mahilfernando/Tracker-Layout_Tororo-PV/solar-mezzanine-roof/report/keyplan.png

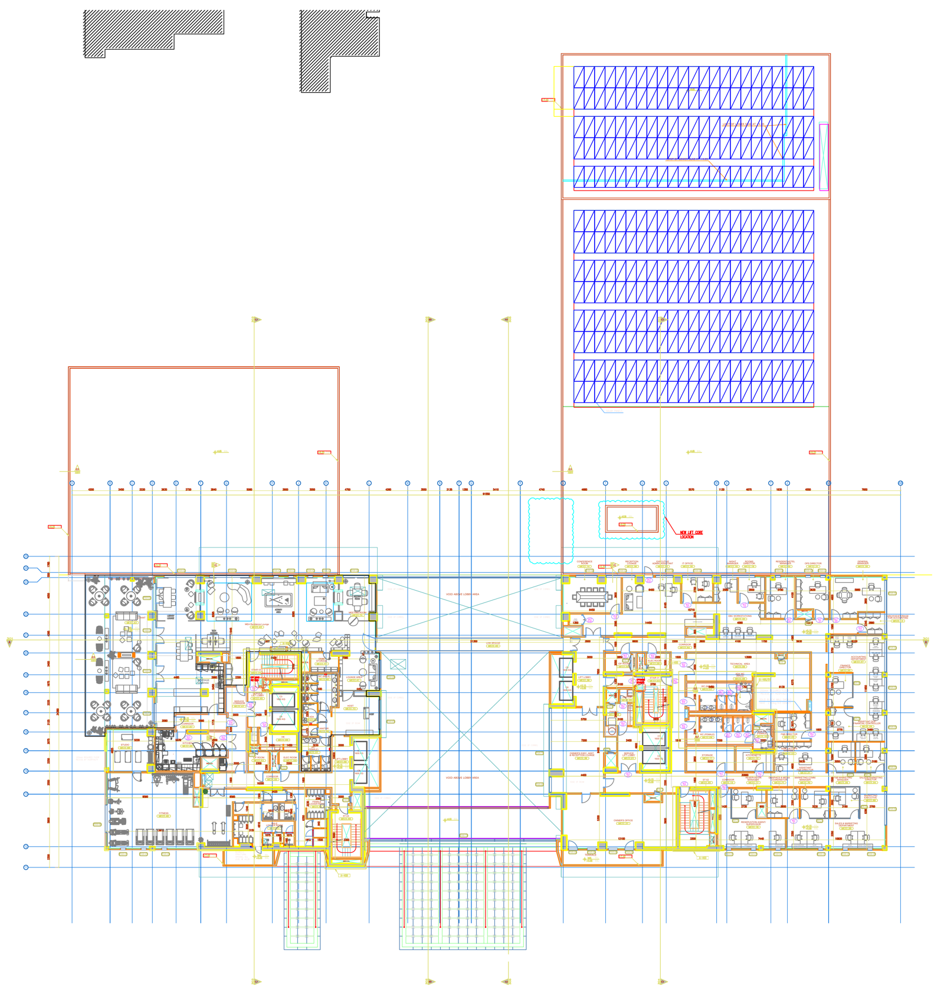
solar-mezzanine-roof/report/keyplan.png
