mahilfernando/Tracker-Layout_Tororo-PV/solar-mezzanine-roof/report/hotel.jpg

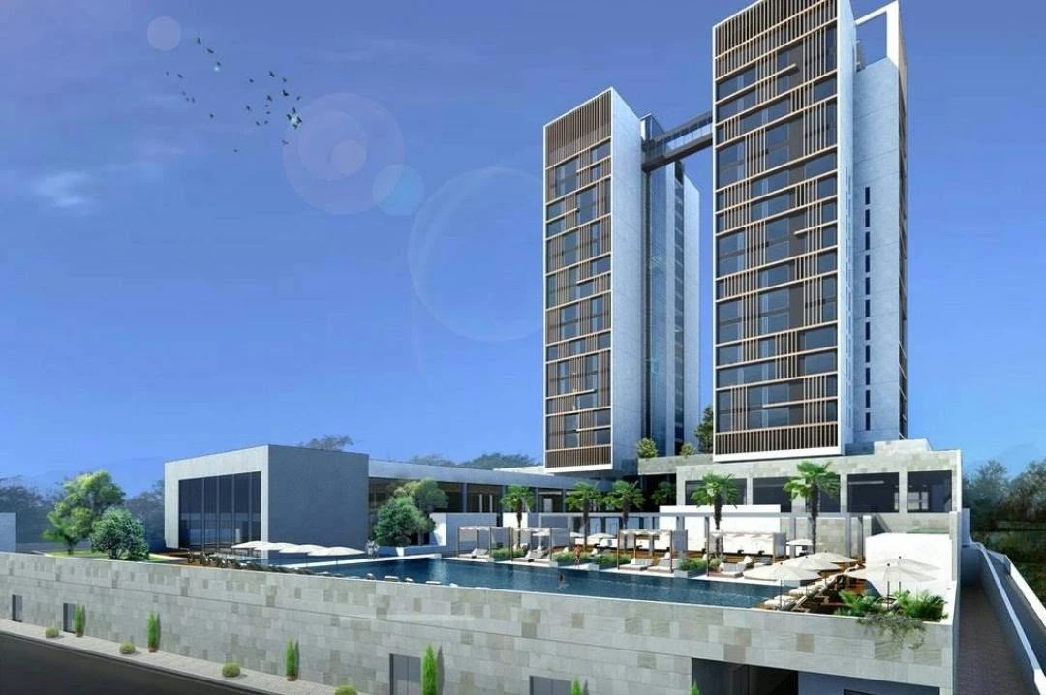
solar-mezzanine-roof/report/hotel.jpg
