mahilfernando/Tracker-Layout_Tororo-PV/solar-mezzanine-roof/README.md

# Rooftop PV layout – D18102-DD-A-104 (Mezzanine)

`PV_Layout_10deg_Mezzanine_Roof.dxf` – PV layout at real scale in mm, ready to paste into the DWG.
`make_pv_layout.py` – regenerates the DXF (change tilt, module or spacing at the top).
`preview_overlay.png` – the layout drawn over the architect's PDF to check the fit.

## Design basis
| Item | Value |
|---|---|
| Module | 2382 × 1134 × 30 mm, 620 Wp bifacial TOPCon, portrait, 2 high (2P) |
| Tilt | 10° → 2P table depth on plan 4,711 mm; 1P table 2,346 mm |
| Clamp gap | 20 mm |
| Aisle between tables | 800 mm (no row-to-row shading 09:00–15:00 all year at Tororo) |
| Edge setback | 1,000 mm (east side 1,742 mm to keep clear of the roof opening ⊠) |
| Modules per row | 23 (row length 26,522 mm) |

## Result
| Zone | Tables | Modules | kWp |
|---|---|---|---|
| Upper block (+6.80, incl. hatched +4.85 strip) | 2 × 2P + 1 × 1P | 115 | 71.3 |
| Lower block (architect's PV zone) | 4 × 2P | 184 | 114.1 |
| **Total** | | **299** | **185.4** |

## Layers
`PV-MODULE`, `PV-TABLE`, `PV-SETBACK`,
`PV-OBSTRUCTION`, `PV-ROOF-REF`, `PV-DIM`, `PV-TEXT`. Modules are block `PV_MOD_620W`.

## Inserting into the DWG
The roof outline was traced from the PDF plot (accurate to about ±50 mm) and calibrated on the
29,390 and 15,805 dimensions. The DXF origin (0,0) is the **inner face of the top-left (NW) corner
of the upper PV roof**.
1. Open the DXF, select everything, then run `COPYBASE` with base point 0,0.
2. In the DWG, `PASTECLIP` and pick the same inner corner.
3. If the model space is rotated relative to the plot, `ROTATE` about that corner.
4. Check that the `PV-ROOF-REF` outline sits on the walls, then freeze or delete that layer.

## Enerack structure version (current)
`PV_Layout_Enerack_10deg.dxf` / `.pdf` – same 299-module layout drawn with the Enerack ballast
structure (EPJ-26110401): rails, 11 frames per table, feet and sections. Built by
`make_pv_layout_enerack.py` and `build_layout_sheet.py`. All tables are within the architect's solar zone.
