mahilfernando/Tracker-Layout_Tororo-PV/solar-mezzanine-roof/report/PVsyst_Report_Kampala_Marriott_Hotel_185kWp_VC0.pdf

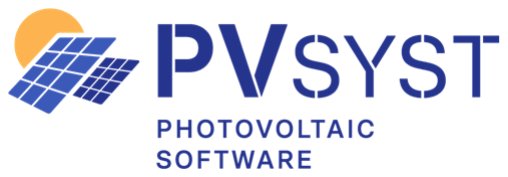
[picture p14: figure]

# PVsyst TRIAL

# PVsyst TRIAL

# PVsyst TRIAL

# PVsyst TRIAL

# PVsyst TRIAL

## PVsyst V8.1.8

# PVsyst - Simulation report

# Grid-Connected System

Project: | Nsambya_160_kW
Variant: | Nsambya_160_kW

## No 3D scene defined, no shadings System power: 185 kWp Nsambya - Uganda

Author

# Kampala_Marriott_Hotel

# Kampala_Marriott_Hotel

# PVsyst TRIAL

# PVsyst TRIAL

# PVsyst TRIAL

# PVsyst TRIAL

# PVsyst TRIAL ⁰⁹/11/26

PVsyst V8.1.8
VC0, Simulation date:
09/11/26 18:38
with V8.1.8

## Project: Nsambya_160_kW

### Variant: Nsambya_160_kW

PVsyst Evaluation mode

### Project summary

Geographical Site
Nsambya
Uganda

Situation
Latitude
Longitude
Altitude
Time zone

0.3042
32.5874
1178
UTC+3

°(N)
°(E)
m

Project settings
Albedo | 0.20

Weather data
Nsambya
Meteonorm 9.0 dll, Sat=100% - Synthetic

### System summary

Grid-Connected System | No 3D scene defined, no shadings

Orientation #1
Fixed plane
Tilt/Azimuth | 10 / 0 °

Near Shadings
no Shadings

User's needs
Unlimited load (grid)

System information
PV Array
Nb. of modules
Pnom total

299
185

units
kWp

Inverters
Nb. of units
Total power
Pnom ratio

2
160
1.16

units
kWac

### Results summary

Simulation step | Hourly
Produced Energy | 291051 kWh/year | Specific production | 1570 kWh/kWp/year Perf. Ratio PR | 85.44 %

### Table of contents

Project and results summary
General parameters, PV Array Characteristics, System losses Main results
Loss diagram
Predef. graphs
Single-line diagram

2
3
4
5
6
7

# Kampala_Marriott_Hotel

## Kampala_Marriott_Hotel

# PVsyst TRIAL

# PVsyst TRIAL

# PVsyst TRIAL

PVsyst V8.1.8
VC0, Simulation date:
09/11/26 18:38
with V8.1.8

### General parameters

Grid-Connected System | No 3D scene defined, no shadings

Simulation step
Hourly

Orientation #1
Fixed plane
Tilt/Azimuth | 10 / 0 °

Models used
Transposition
Diffuse
Circumsolar

Perez
Perez, Meteonorm
separate

Horizon
Free Horizon

Near Shadings
no Shadings

User's needs
Unlimited load (grid)

### PV Array Characteristics

PV module
Manufacturer
Model

Generic
CHSM66RN(DG)/F-BH-620
(Original PVsyst database)
Unit Nom. Power | 620 Wp
Number of PV modules Nominal (STC) Modules | 299
| 185
| 23 units x 13 units
| kWp
| In series
At operating cond. (50°C)
Pmpp U mpp I mpp | 172
| 491
| 351 kWp
| V
| A

Inverter
Manufacturer
Model

Generic
80M1-HYA
(Original PVsyst database)
Unit Nom. Power | 80.0 kWac
Number of inverters Total power | 2
| 160 units
| kWac
Operating voltage Max. power (=>40°C) Pnom ratio (DC:AC) Power sharing within this inverter | 160-1000
| 88.0
| 1.16 V
| kWac

Total PV power
Nominal (STC)
Total
Module area
Cell area

185
299
808
754

kWp
modules
m²
m²

Total inverter power
Total power
Max. power
Number of inverters
Pnom ratio

160
176
2
1.16

kWac
kWac
units

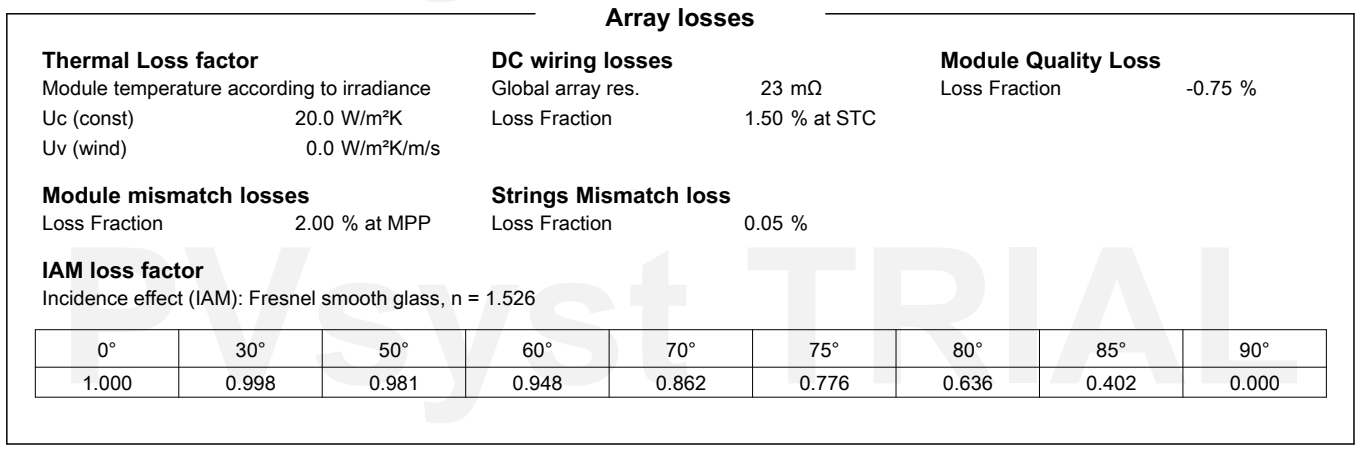
[picture p15: figure]
PVsyst TRIAL; Array losses; Thermal Loss factor; Module temperature according to irradiance; Uc (const); Uv (wind); W/m²K; W/m²K/m/s; DC wiring losses; Global array res.; Loss Fraction; % at STC; Module Quality Loss; Module mismatch losses; 2.00 % at MPP; Strings Mismatch loss; IAM loss factor

Incidence effect (IAM): Fresnel smooth glass, n = 1.526

# PVsyst TRIAL

# PVsyst TRIAL

# PVsyst TRIAL

PVsyst V8.1.8
VC0, Simulation date:
09/11/26 18:38
with V8.1.8

### Main results

Simulation step
Hourly

System Production
Produced Energy | 291051 kWh/year | Specific production
| | Perf. Ratio PR

1570
85.44

kWh/kWp/year
%
Normalized productions (per installed kWp) | Performance Ratio PR

Balances and main results

| GlobHor kWh/m² | DiffHor kWh/m² | T_Amb °C | GlobInc kWh/m² | GlobEff kWh/m² | EArray kWh | E_Grid kWh | PR ratio
PVsyst TRIAL January February March April May June July August September October November December | 163.9 155.8 170.3 146.6 152.4 147.4 158.5 160.2 159.5 155.5 138.1 146.8 | 65.15 60.45 76.10 72.32 71.94 61.35 56.87 63.78 65.84 68.89 73.98 67.95 | 23.02 23.52 23.21 22.79 22.59 22.19 21.80 21.90 22.11 22.31 22.30 22.42 | 174.4 161.5 170.2 141.3 142.3 135.0 145.4 152.1 157.0 158.1 144.3 156.1 | 169.0 157.0 164.9 136.1 136.5 129.0 139.4 146.5 152.1 153.4 139.6 151.3 | 28018 25848 27424 22846 23031 21771 23454 24591 25340 25458 23357 25187 | 27523 25387 26942 22443 22628 21387 23038 24154 24885 24993 22933 24738 | 0.851 0.848 0.854 0.857 0.858 0.855 0.855 0.857 0.855 0.853 0.857 0.855
Year | 1855.0 | 804.62 | 22.51 | 1837.7 | 1774.7 | 296323 | 291051 | 0.854

Legends
GlobHor
DiffHor
T_Amb
GlobInc
GlobEff

Global horizontal irradiation Horizontal diffuse irradiation
Ambient Temperature
Global incident in coll. plane
Effective Global, corr. for IAM and shadings

EArray
E_Grid
PR

Effective energy at the output of the array Energy injected into grid
Performance Ratio

# PVsyst TRIAL

### Loss diagram

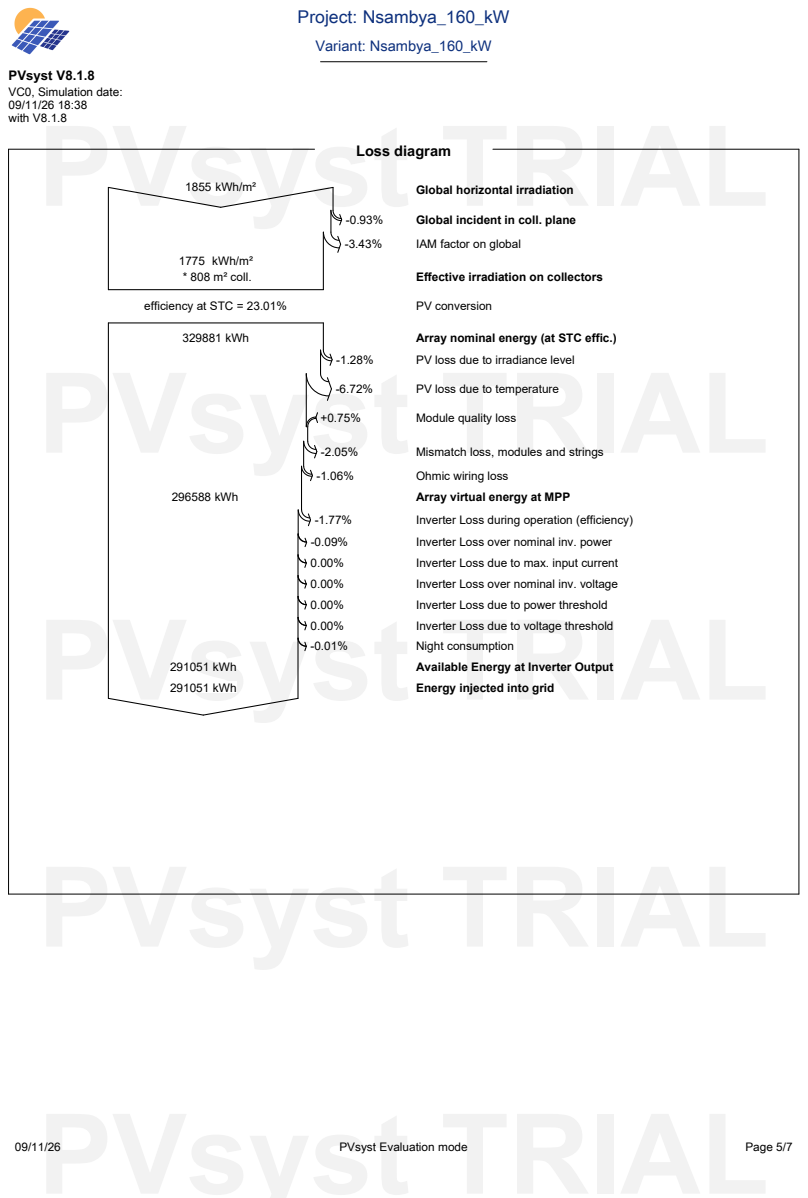
[picture p16: page 5]
PVsyst TRIAL; PVsyst V8.1.8; VC0, Simulation date: 09/11/26 18:38 with V8.1.8; 1855 kWh/m²; Global horizontal irradiation; Global incident in coll. plane; IAM factor on global; 1775 kWh/m²; * 808 m² coll.; efficiency at STC = 23.01%; PV conversion; 329881 kWh; Array nominal energy (at STC effic.); PV loss due to irradiance level; PV loss due to temperature; Module quality loss; Mismatch loss, modules and strings; Ohmic wiring loss; 296588 kWh; Array virtual energy at MPP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

Effective irradiation on collectors

# PVsyst TRIAL

### Predef. graphs

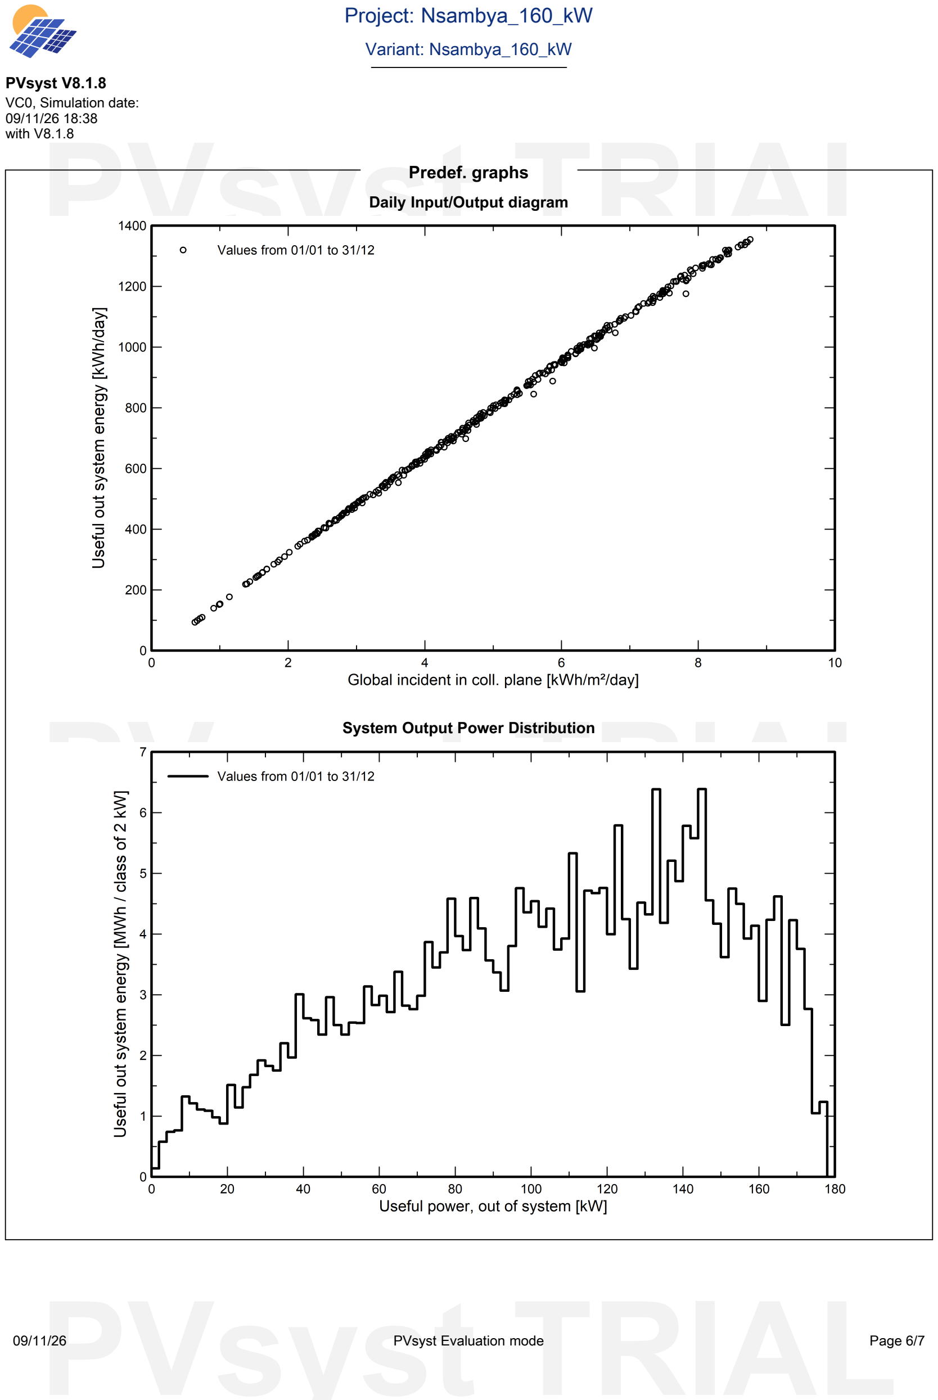
[picture p17: page 6]

# PVsyst TRIAL

# PVsyst TRIAL

# PVsyst TRIAL

PVsyst V8.1.8
VC0, Simulation date:
09/11/26 18:38
with V8.1.8

Daily Input/Output diagram

System Output Power Distribution

# PVsyst TRIAL

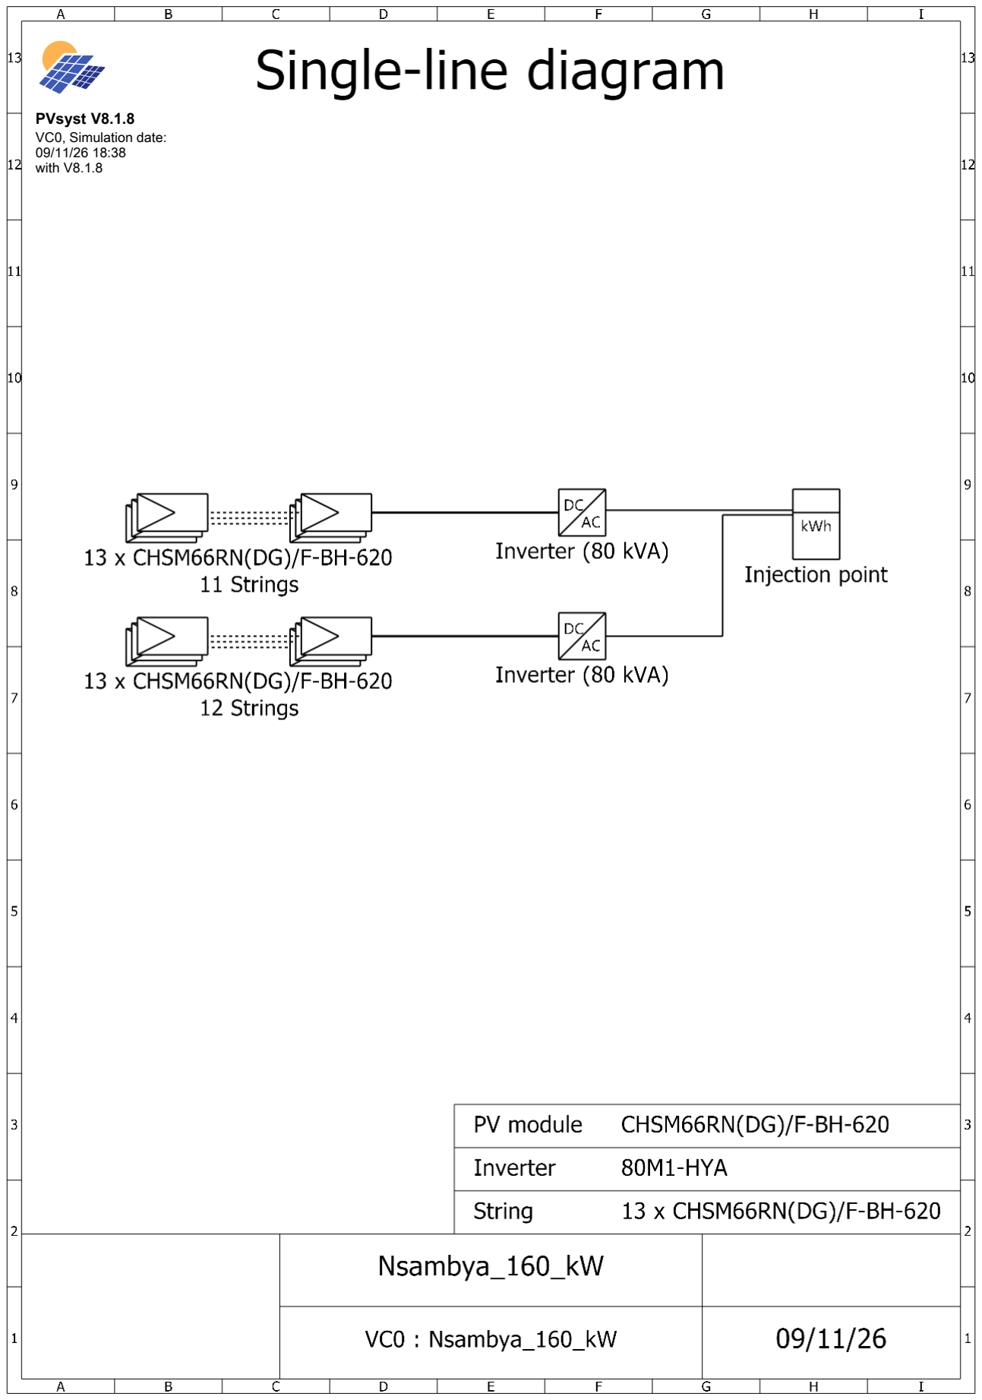
[picture p18: page 7]

# PVsyst TRIAL

# PVsyst TRIAL

# PVsyst TRIAL

# PVsyst TRIAL

PVsyst V8.1.8
VC0, Simulation date:
09/11/26 18:38
with V8.1.8
