mahilfernando/Tracker-Layout_Tororo-PV/solar-mezzanine-roof/sld/PV_SLD_Engineering.docx

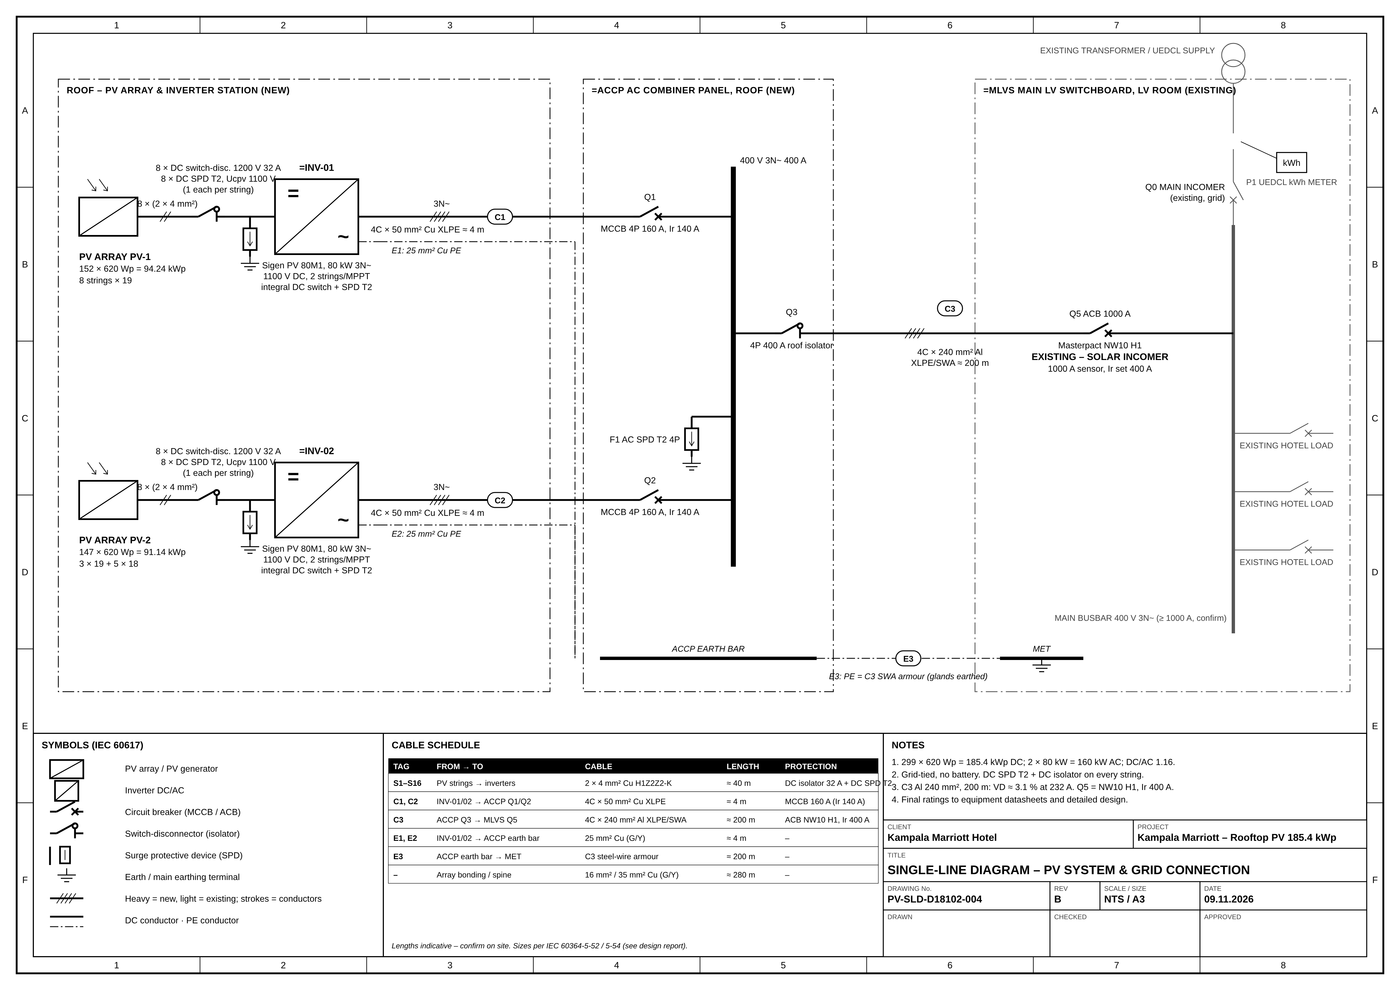
[picture p20: figure]
PV system single-line diagram PV-SLD-D18102-004

Figure – Single-line diagram, 185.4 kWp rooftop PV (drawing PV-SLD-D18102-004 Rev A)
