mahilfernando/Tracker-Layout_Tororo-PV/solar-mezzanine-roof/report/PVsyst_vs_Initial_Generation.xlsx

Sheet: Monthly comparison
PVsyst simulation vs initial generation estimate – Kampala Marriott 185.4 kWp
PVsyst V8.1.8 (trial) · Meteonorm 9.0 · tilt 10°, azimuth 0° · 299 × CHSM66RN(DG)/F-BH-620 · 2 × 80M1 · no shading · simulated 09/11/2026
Month | GHI – initial (kWh/m²) | GHI – PVsyst (kWh/m²) | Plane irradiation – PVsyst (kWh/m²) | Generation – initial estimate (kWh) | Generation – PVsyst E_Grid (kWh) | Difference (kWh) | Difference (%) | PR – PVsyst
Jan | 167.4 | 163.9 | 174.4 | 25143 | 27523 | 2380 | 9.5% | 85.1%
Feb | 156.8 | 155.8 | 161.5 | 23551 | 25387 | 1836 | 7.8% | 84.8%
Mar | 167.4 | 170.3 | 170.2 | 25143 | 26942 | 1799 | 7.2% | 85.4%
Apr | 150.0 | 146.6 | 141.3 | 22529 | 22443 | -86 | -0.4% | 85.7%
May | 145.7 | 152.4 | 142.3 | 21884 | 22628 | 744 | 3.4% | 85.8%
Jun | 138.0 | 147.4 | 135.0 | 20727 | 21387 | 660 | 3.2% | 85.5%
Jul | 139.5 | 158.5 | 145.4 | 20952 | 23038 | 2086 | 10.0% | 85.5%
Aug | 148.8 | 160.2 | 152.1 | 22349 | 24154 | 1805 | 8.1% | 85.7%
Sep | 153.0 | 159.5 | 157.0 | 22980 | 24885 | 1905 | 8.3% | 85.5%
Oct | 155.0 | 155.5 | 158.1 | 23280 | 24993 | 1713 | 7.4% | 85.3%
Nov | 147.0 | 138.1 | 144.3 | 22079 | 22933 | 854 | 3.9% | 85.7%
Dec | 158.1 | 146.8 | 156.1 | 23746 | 24738 | 992 | 4.2% | 85.5%
Year | 1826.7 | 1855.0 | 1837.7 | 274363 | 291051 | 16688 | 6.1% | 85.4%
Indicator |  |  |  | Initial estimate | PVsyst | Difference
Specific yield (kWh/kWp/yr) |  |  |  | 1480.003237 | 1570.023735 | 90.02049844
Average per month (kWh) |  |  |  | 22863.58333 | 24254.25 | 1390.666667
Average per day (kWh) |  |  |  | 751.6794521 | 797.4 | 45.72054795
Performance ratio (yield ÷ plane irradiation) |  |  |  | 80.5% | 85.4% | 4.9%
Best month ÷ worst month |  |  |  | 1.21 | 1.29 | 0.07

Sheet: Assumptions & losses
Why the two estimates differ
Item | Initial estimate (Excel) | PVsyst VC0 | Comment
Weather data | Typical Kampala GHI (desktop), 1,827 kWh/m²/yr | Meteonorm 9.0 synthetic, 1,855 kWh/m²/yr | PVsyst GHI 1.5 % higher
Method | kWp × specific yield 1,480 kWh/kWp | Hourly simulation (Perez transposition)
Performance ratio | ≈ 0.80 (assumed, all losses) | 0.854 (simulated) | Main reason for the 6 % difference
Shading (row-to-row, parapet, tower) | included in PR 0.80 | Not modelled – 'no 3D scene, no shadings' | Tower and parapet shading will reduce PVsyst output
Soiling (dust) | included in PR 0.80 | Not modelled (0 %) | Typically 2–3 % in Kampala (dry seasons, urban dust)
Thermal model | included in PR 0.80 | Uc = 20 W/m²K → −6.7 % temperature loss | Conservative for an open ballast structure (Uc 29 typical)
Module quality / LID | included in PR 0.80 | +0.75 % quality gain, no LID | Optimistic – use 0 % quality gain
Bifacial rear gain | not included | not included (front-side only) | Could add ≈ 2–4 % on a light roof
String layout | 16 strings: 8 × 19 + 3 × 19 + 5 × 18 | 23 strings × 13 modules | Update PVsyst to the design stringing (19/18 in series)
AC losses (ACCP → MLVS cable) | included in PR 0.80 | Not modelled (output at inverter) | ≈ 1–2 % with the long C3 run
Availability / downtime | included in PR 0.80 | Not modelled | ≈ 1 % typical
Degradation | 1 % year 1, then 0.4 %/yr | Year-1 nominal (no degradation) | Compare year-1 figures only
Software licence | – | PVsyst TRIAL / evaluation mode | Run with a licensed copy for the issued report
Adjusted PVsyst estimate (adding the losses PVsyst left out)
Step | Factor | Energy (kWh/yr) | Note
PVsyst E_Grid (as simulated) |  | 291051 | page 4 of the report
Soiling | 2.0% | 285229.98 | edit
Near shading (tower / parapet / rows) | 2.0% | 279525.3804 | edit – confirm with a 3D scene
AC cable losses to MLVS | 1.0% | 276730.1266 | edit
Availability | 1.0% | 273962.8253 | edit
Remove module quality gain | 0.8% | 271908.1041 | PVsyst +0.75 %
Adjusted PVsyst year-1 generation |  | 271908.1041
Initial estimate (proposal / workings) |  | 274363
Adjusted PVsyst vs initial |  | -0.9%

Sheet: Financial impact
Year-1 financial effect of the generation basis (tariff USD 0.07/kWh, Total Project Value USD 102,789)
Case | Year-1 generation (kWh) | Year-1 savings (USD) | Simple payback (yrs, approx.) | Specific yield (kWh/kWp) | Tariff (USD/kWh) | 0.07002272727
Initial estimate (used in proposal) | 274363 | 19211.64552 | 5.1 | 1480.003237 | Investment (USD) | 102788.75
PVsyst as simulated | 291051 | 20380.1848 | 4.9 | 1570.023735 | Escalation | 0.02
PVsyst adjusted (soiling, shading, AC, availability) | 271908.1041 | 19039.74702 | 5.2 | 1466.76073
Payback = years for savings rising 2 %/yr to repay the investment (degradation ignored, so ≈ 0.1 yr shorter than the full 25-year model in the workings).
