mahilfernando/Tracker-Layout_Tororo-PV/ChatGPT Image Oct 8, 2026, 09_10_20 AM.jpg

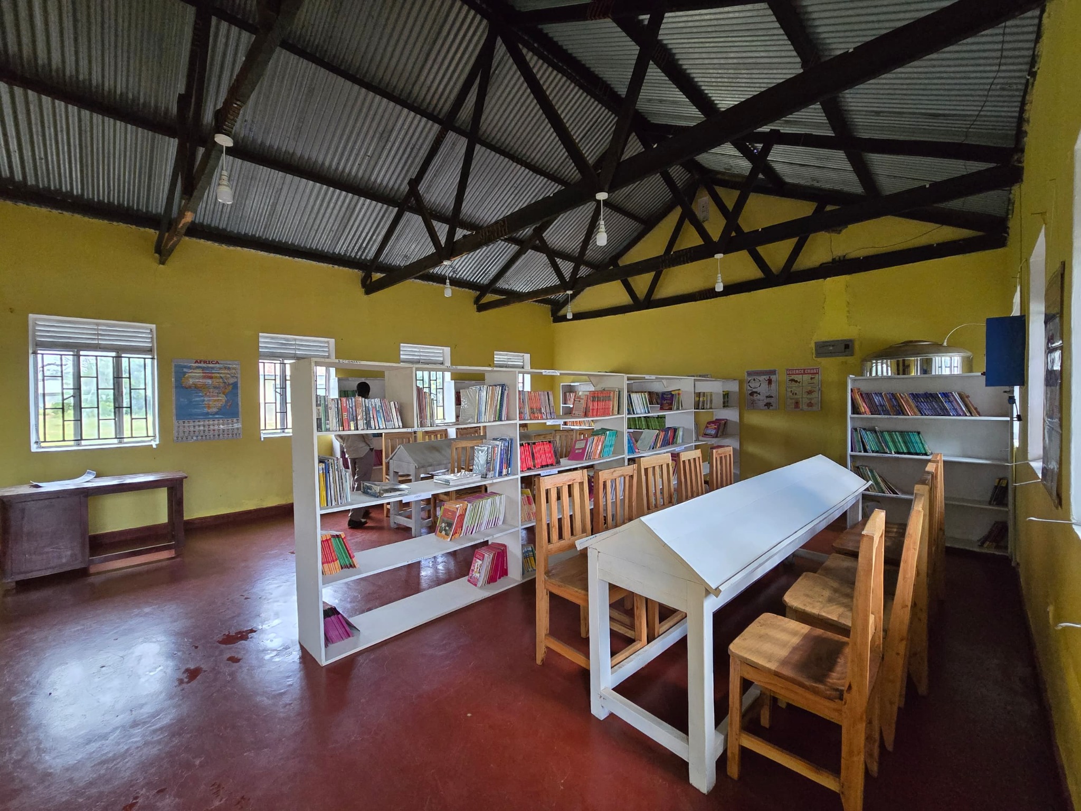
ChatGPT Image Oct 8, 2026, 09_10_20 AM.jpg
