mahilfernando/Tracker-Layout_Tororo-PV/ChatGPT Image Oct 8, 2026, 09_10_26 AM.jpg

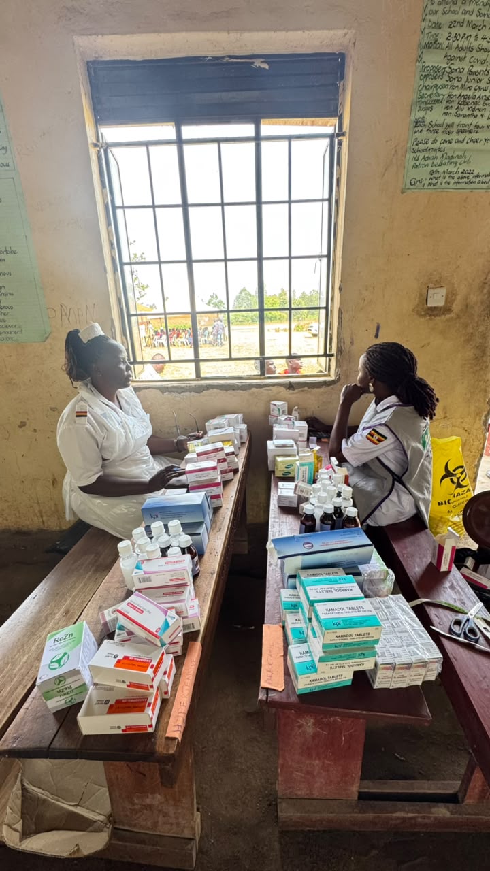
ChatGPT Image Oct 8, 2026, 09_10_26 AM.jpg
