mahilfernando/Tracker-Layout_Tororo-PV/ChatGPT Image Oct 8, 2026, 09_10_37 AM.jpg

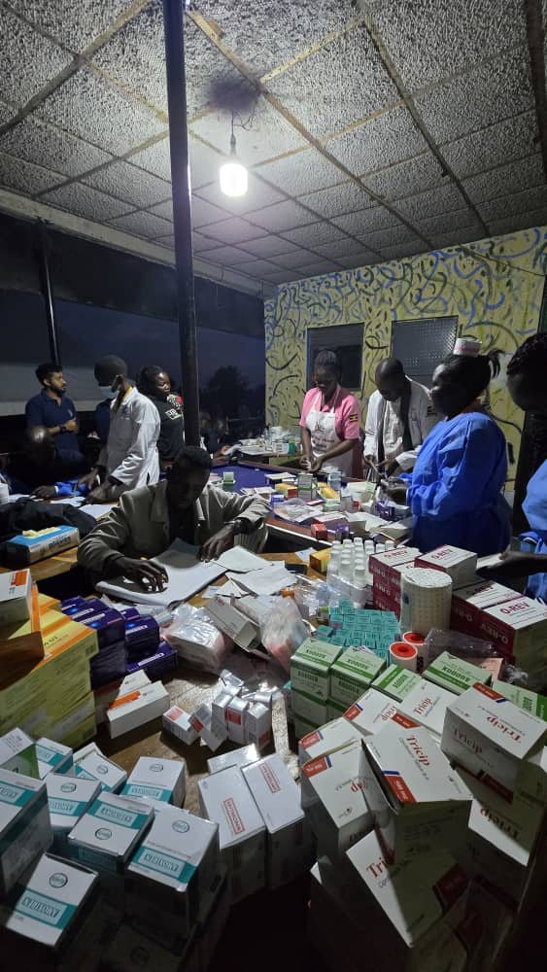
ChatGPT Image Oct 8, 2026, 09_10_37 AM.jpg
