mahilfernando/Tracker-Layout_Tororo-PV/solar-mezzanine-roof/preview_overlay.png

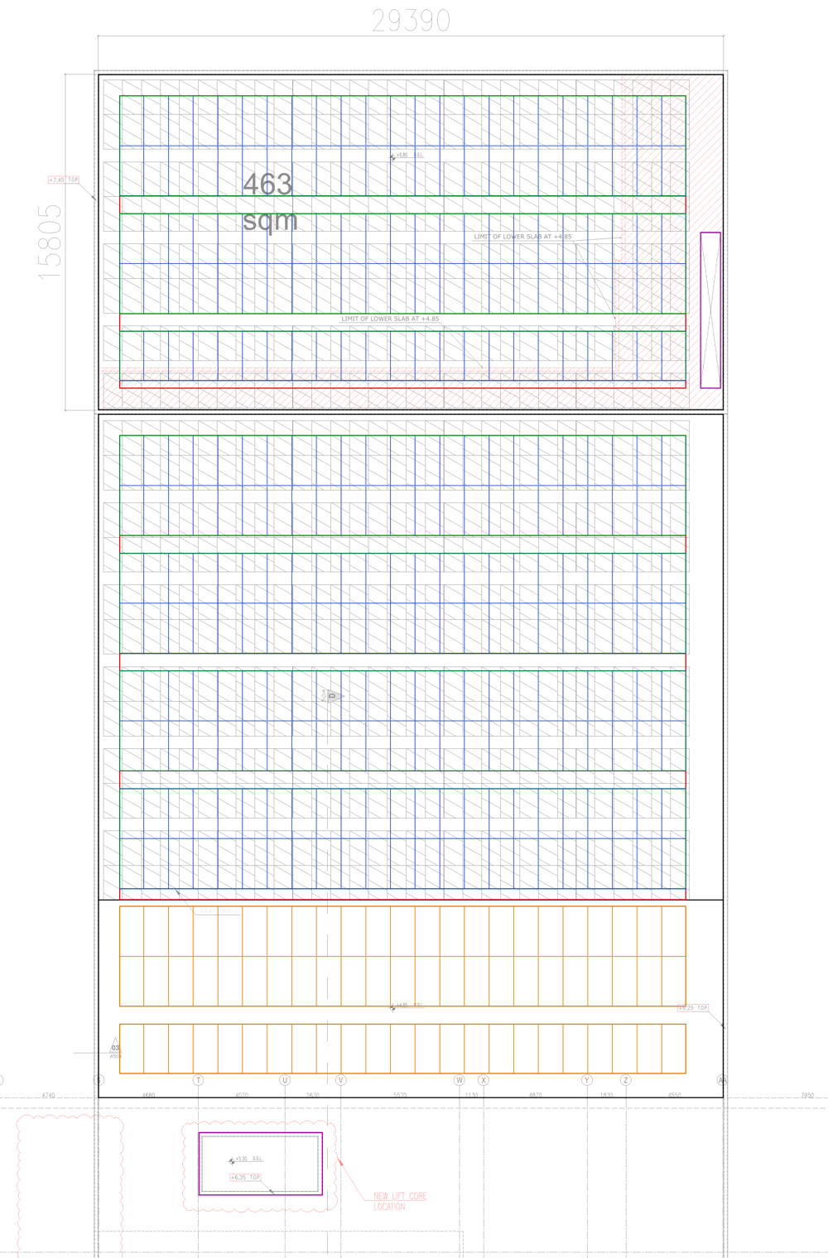
solar-mezzanine-roof/preview_overlay.png
