mahilfernando/Tracker-Layout_Tororo-PV/solar-mezzanine-roof/report/cashflow_chart.png

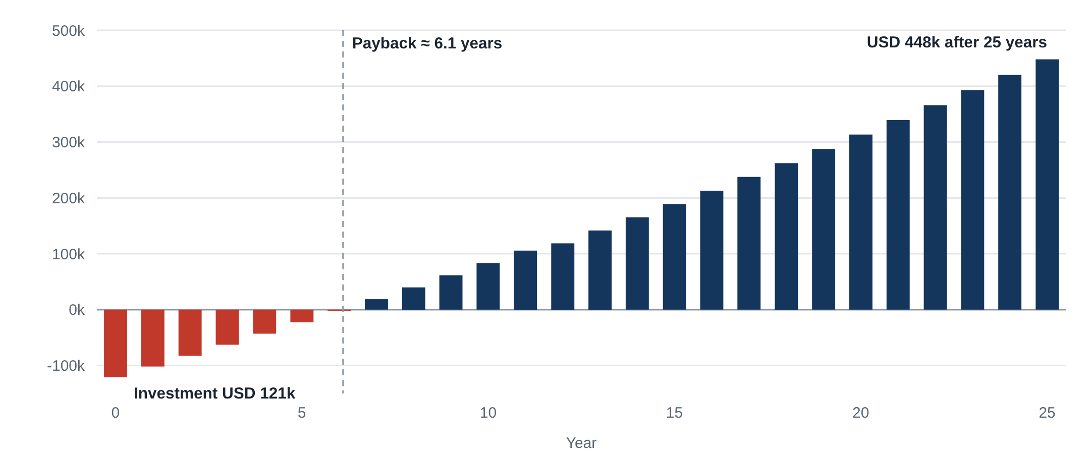
solar-mezzanine-roof/report/cashflow_chart.png
