mahilfernando/Tracker-Layout_Tororo-PV/solar-mezzanine-roof/report/layout_plan_crop.png

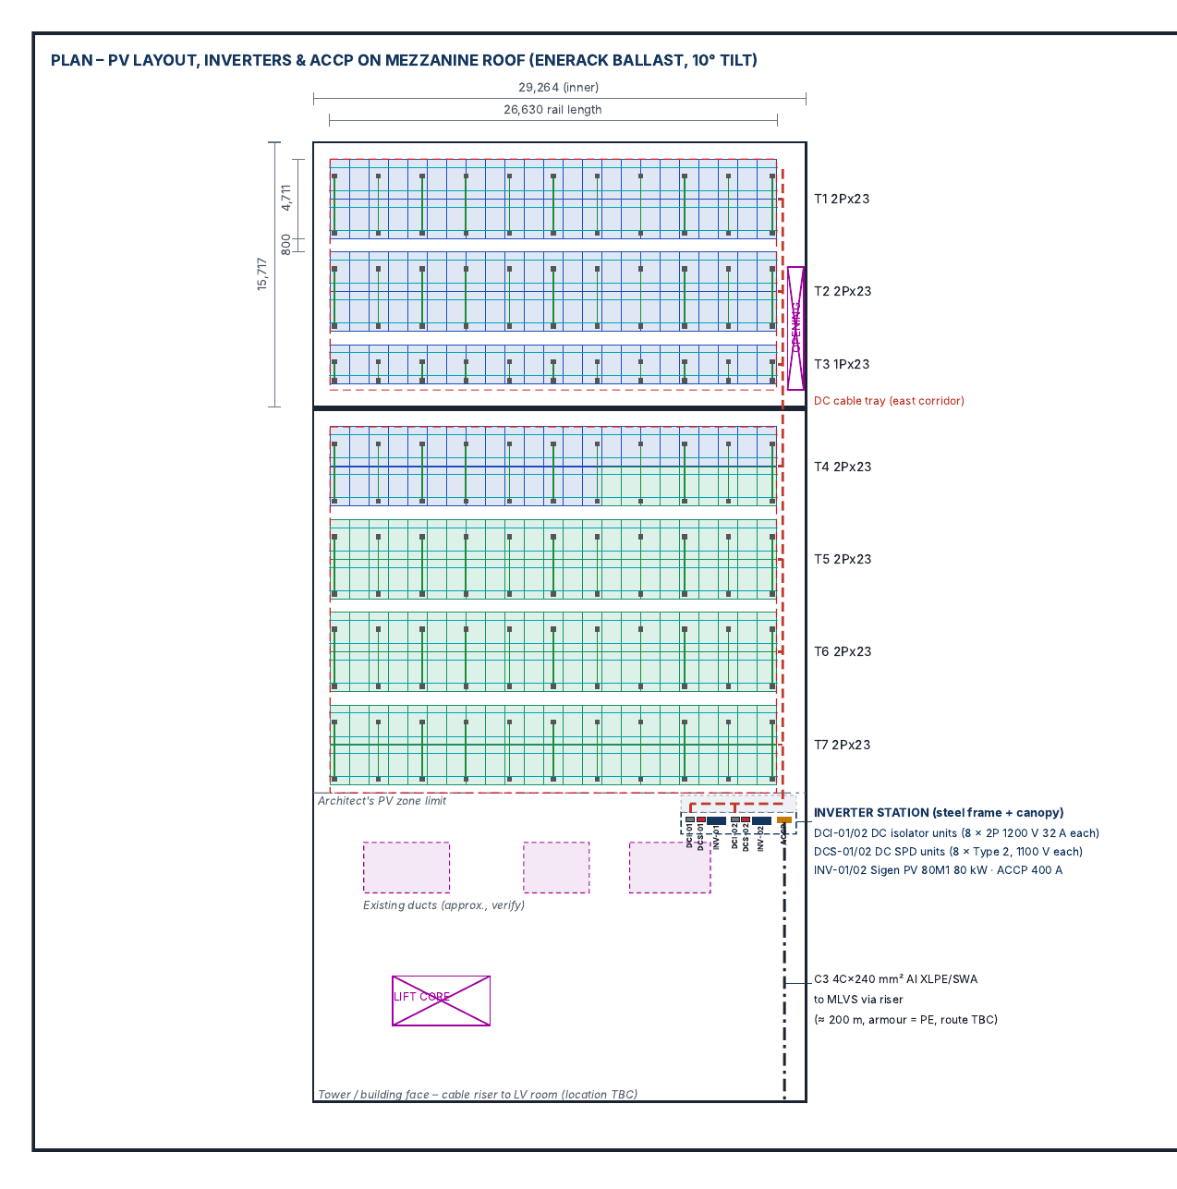
solar-mezzanine-roof/report/layout_plan_crop.png
