mahilfernando/Tracker-Layout_Tororo-PV/solar-mezzanine-roof/report/layout_revB.png

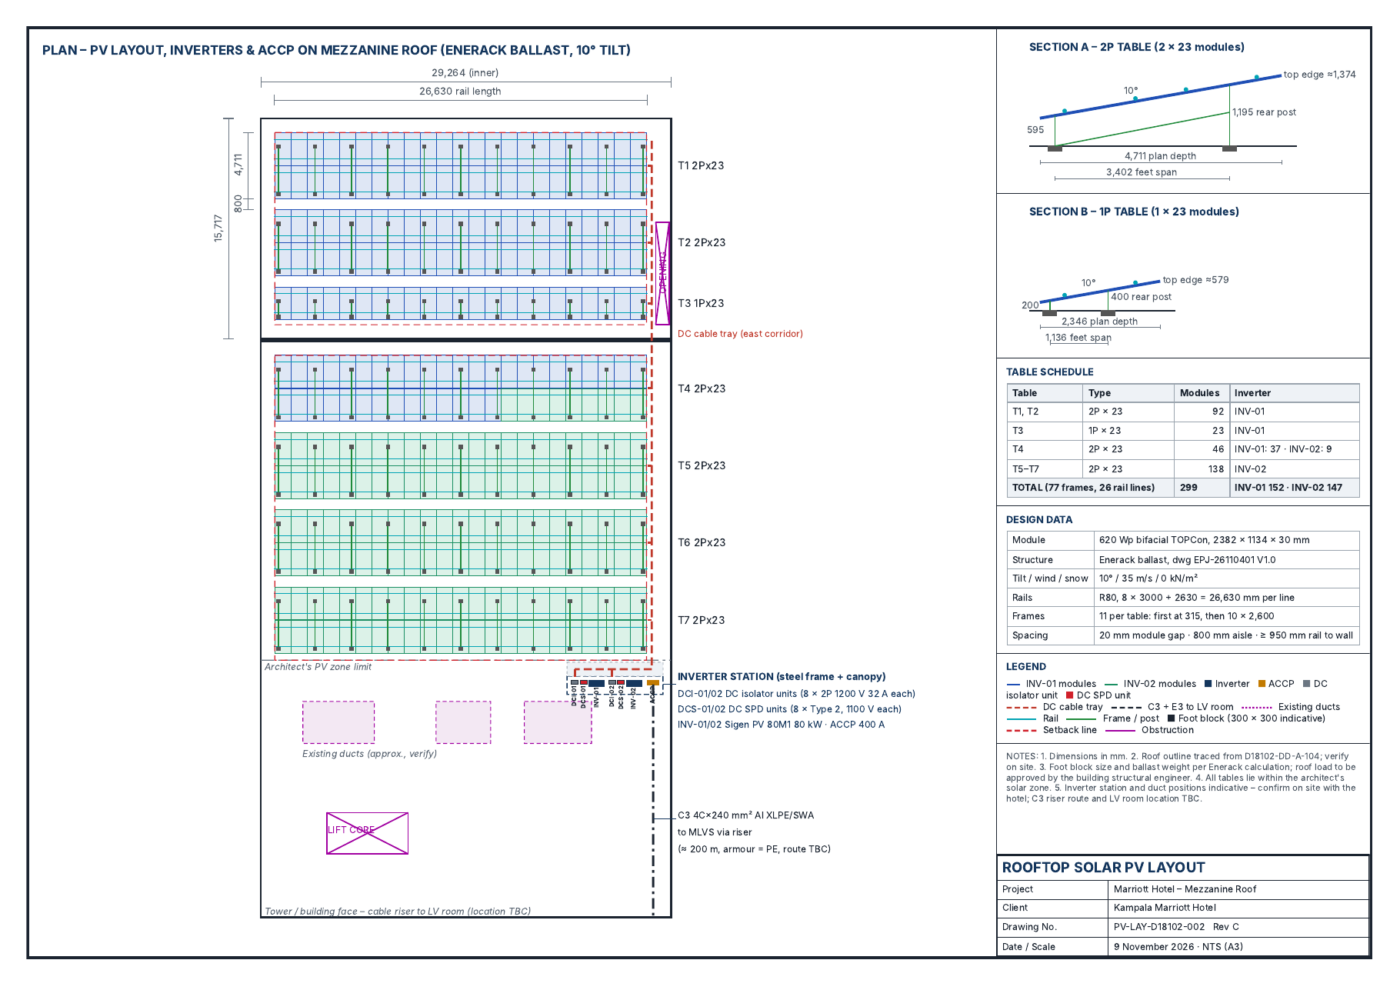
solar-mezzanine-roof/report/layout_revB.png
