mahilfernando/Tracker-Layout_Tororo-PV/solar-mezzanine-roof/sld/Array_Bonding_Explainer.png

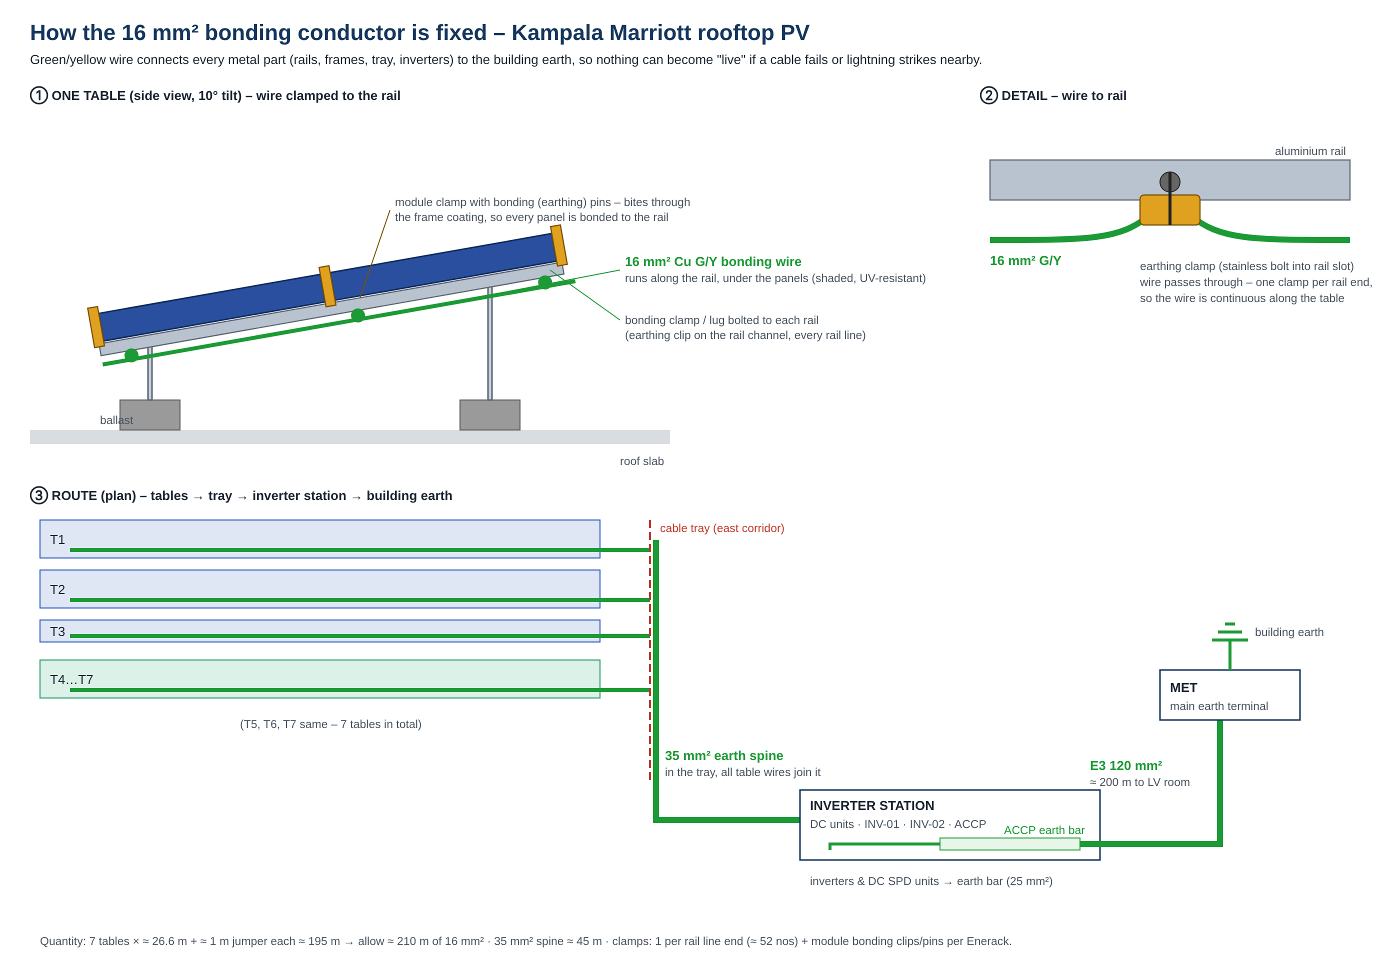
solar-mezzanine-roof/sld/Array_Bonding_Explainer.png
