mahilfernando/Tracker-Layout_Tororo-PV/solar-mezzanine-roof/sld/DC_Cable_Tray_Explainer.png

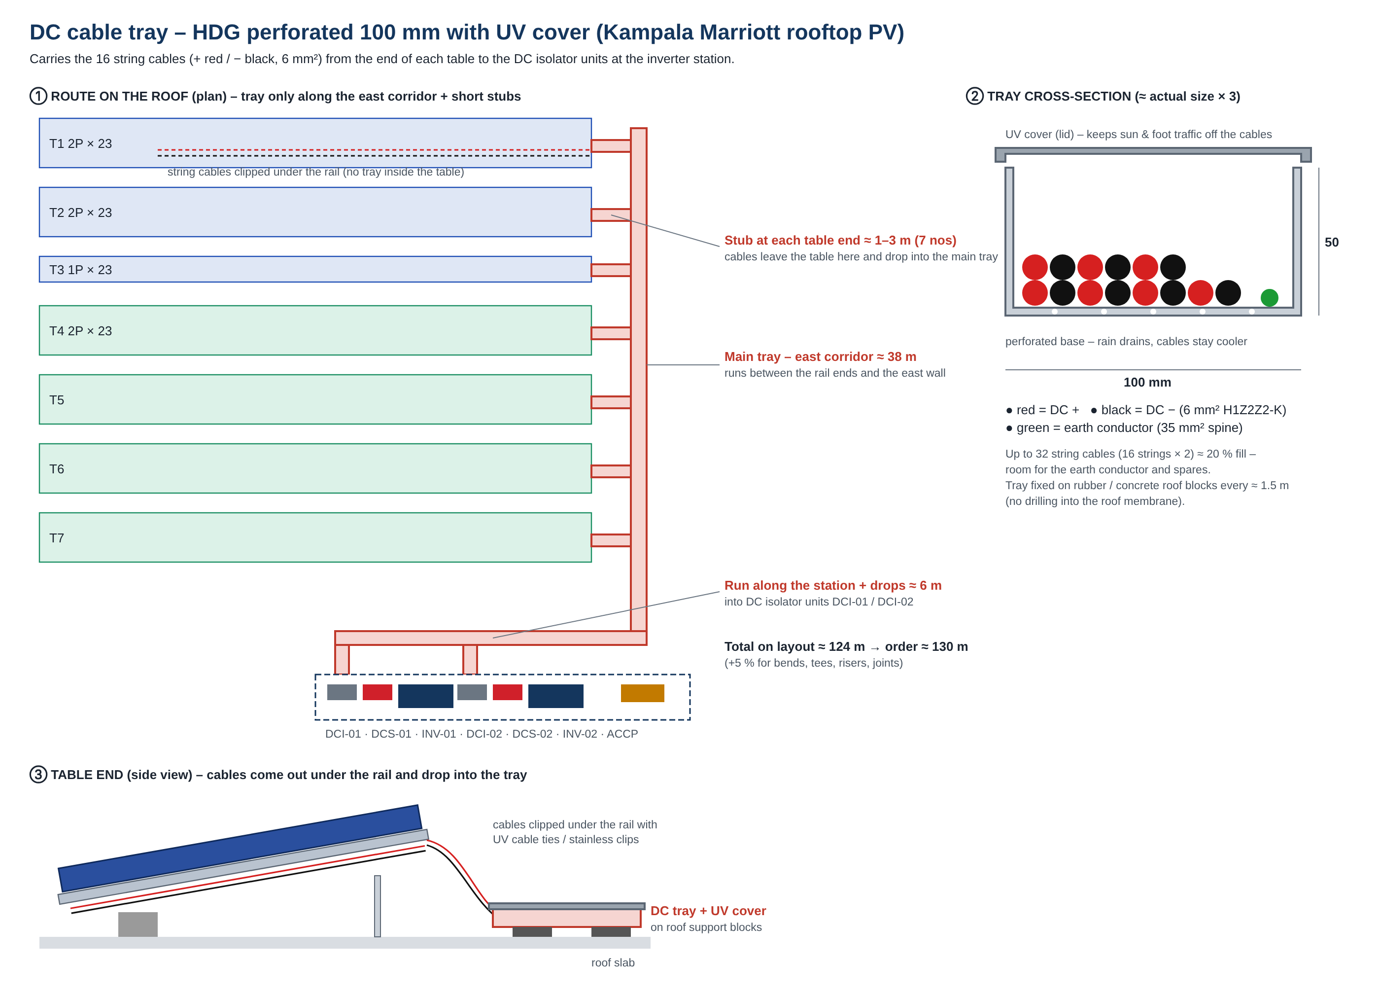
solar-mezzanine-roof/sld/DC_Cable_Tray_Explainer.png
