mahilfernando/Tracker-Layout_Tororo-PV/solar-mezzanine-roof/sld/Lightning_Rod_Explainer.png

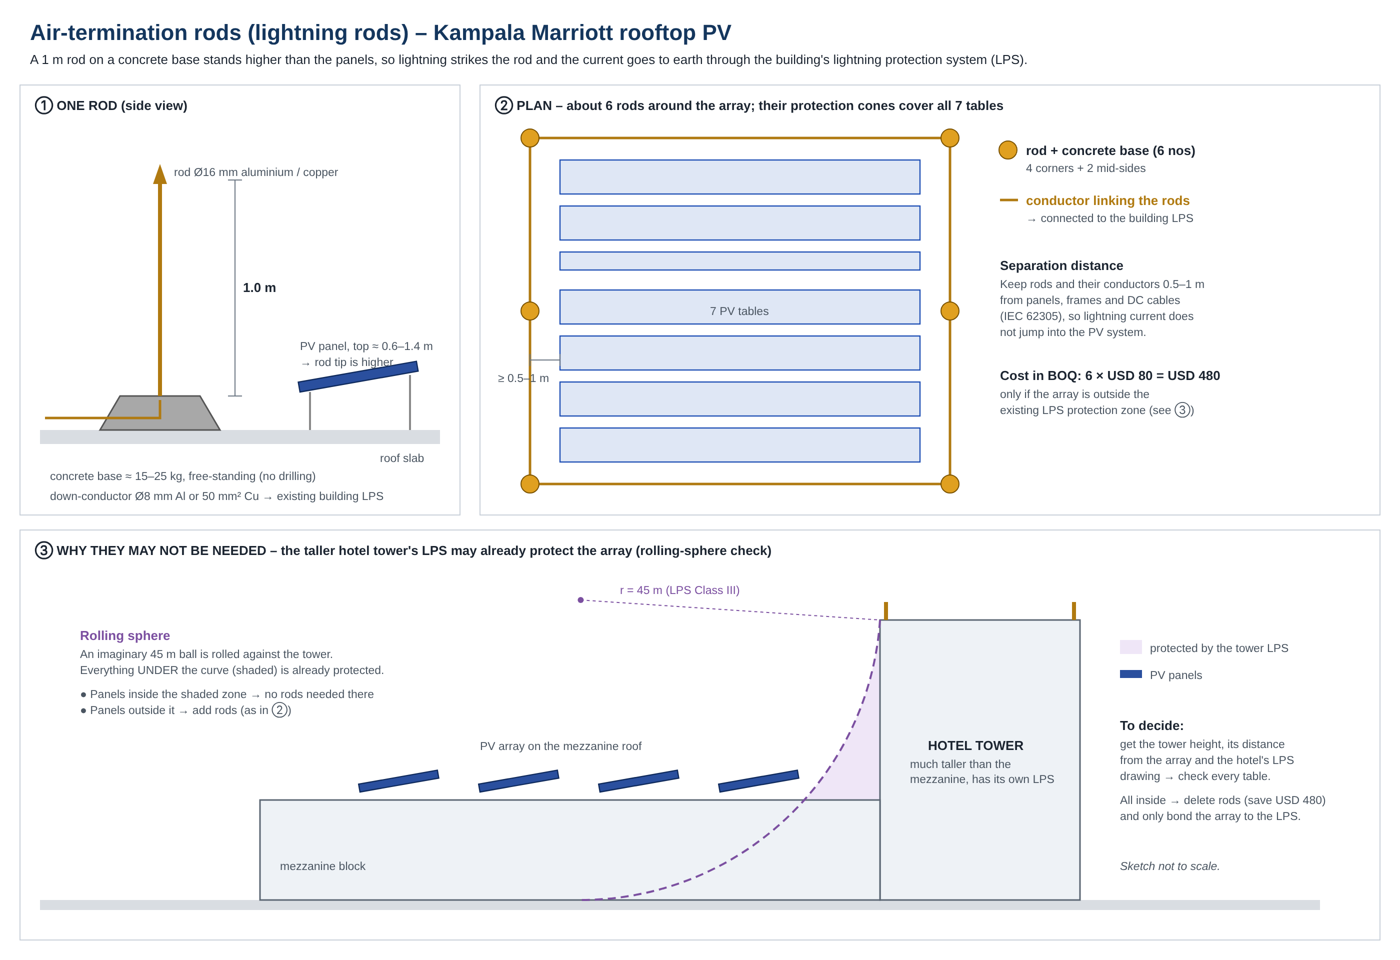
solar-mezzanine-roof/sld/Lightning_Rod_Explainer.png
