mahilfernando/Tracker-Layout_Tororo-PV/solar-mezzanine-roof/sld/PV_Single_Line_Diagram.png

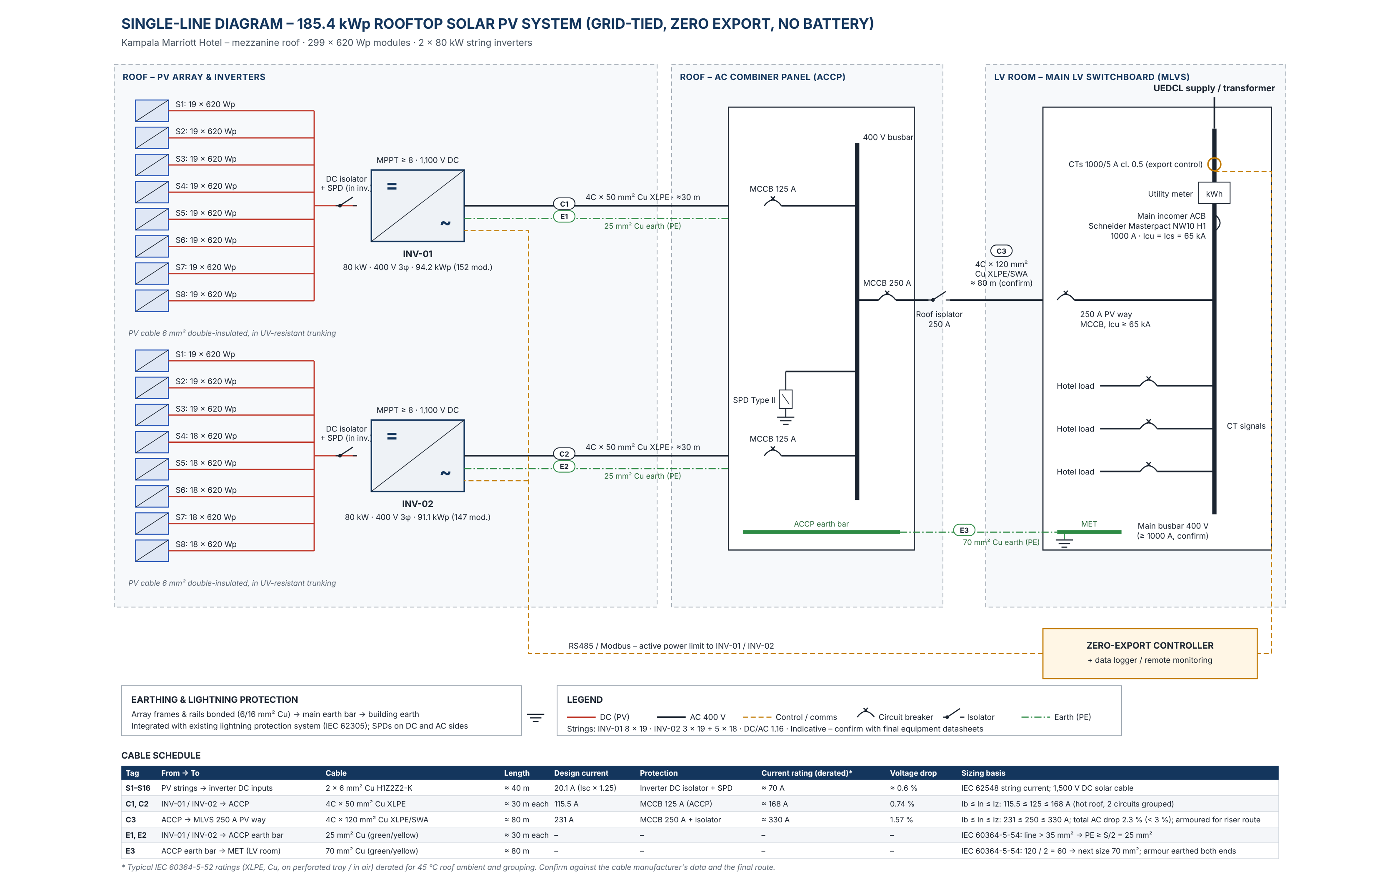
solar-mezzanine-roof/sld/PV_Single_Line_Diagram.png
