mahilfernando/Tracker-Layout_Tororo-PV/solar-mezzanine-roof/sld/PV_SLD_Detailed.png

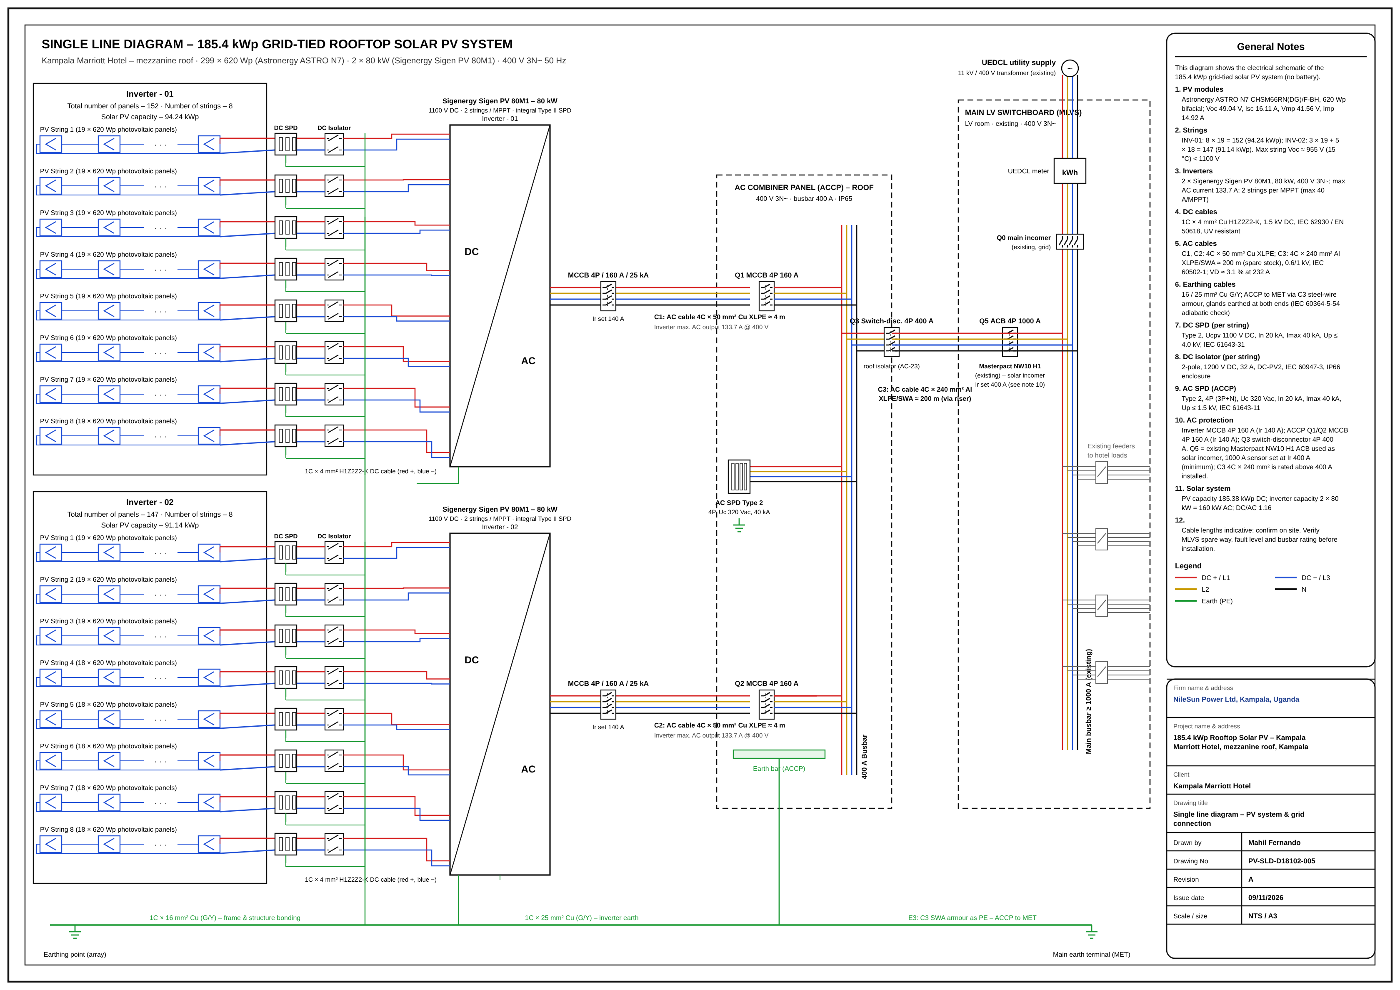
solar-mezzanine-roof/sld/PV_SLD_Detailed.png
