mahilfernando/Tracker-Layout_Tororo-PV/solar-mezzanine-roof/visual/Marriott_roof_PV_overlay_zoom.png

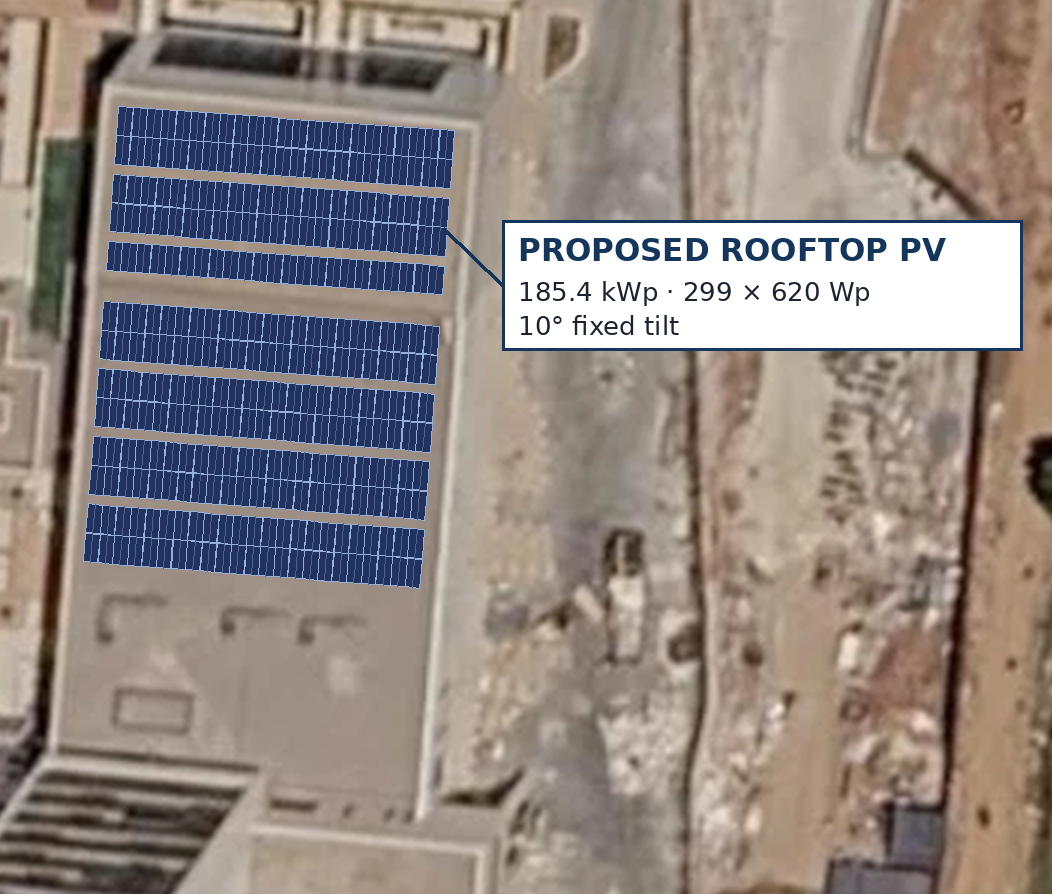
solar-mezzanine-roof/visual/Marriott_roof_PV_overlay_zoom.png
