mahilfernando/Tracker-Layout_Tororo-PV/solar-mezzanine-roof/report/Kampala_Marriott_PV_Quotation.xlsx

 |  | Nile Sun Power Limited Kampala, Uganda
Commercial Proposal & Quotation – Rooftop Solar PV System
Turnkey EPC supply, installation and commissioning · 185.4 kWp grid-tied · no battery
Quotation No.: |  | NSP-261105-KMH | Date: |  | 05-11-2026
Revision: |  | A | Valid until: |  | 05-12-2026 (30 days)
1. Project Details
Project name: |  | Kampala Marriott Hotel – 185.4 kWp Rooftop Solar PV (mezzanine roof)
System: |  | Grid-tied solar PV, self-consumption, no battery storage
Location: |  | Kampala, Uganda · 0°18'11.34"N, 32°35'13.76"E · Ref. drawing D18102-DD-A-104
2. Client & Supplier Details
Client: |  | Kampala Marriott Hotel | Supplier: |  | Nile Sun Power Limited
Address: |  | Kampala, Uganda | Address: |  | Kampala, Uganda
Contact: |  | Mr. Jagath | Contact: |  | Mahil Fernando
Mobile / Email: |  | +256 791 811805 | Mobile / Email: |  | +94 773 55 96 82 · mahil@windforce.lk
3. Quotation (Turnkey EPC)
No. | Scope of supply & works |  | Qty | Unit | Total Price (USD)
1 | PV modules – Astronergy ASTRO N7 620 Wp bifacial N-type TOPCon |  | 299 | nos | USD 139881
2 | String inverters – Sigenergy Sigen PV 80M1, 80 kW, 1100 V |  | 2 | nos
3 | Ballasted aluminium mounting structure, 10° tilt |  | 1 | lot
4 | DC system – PV cable, connectors, string isolators, cable tray |  | 1 | lot
5 | AC system – AC combiner panel, MCCBs, cabling to main LV switchboard |  | 1 | lot
6 | Remote monitoring via inverter cloud portal |  | 1 | set
7 | Earthing & lightning protection integration |  | 1 | lot
8 | Installation, testing & commissioning |  | 1 | lot
9 | Transport, logistics & customs clearing to site |  | 1 | lot
TOTAL TURNKEY EPC PRICE (excluding VAT and other applicable taxes) |  |  |  |  | USD 139881
Equivalent to USD 0.75 per Wp · Amount in words: One hundred thirty-nine thousand eight hundred eighty-one US Dollars only.
4. Payment & Commercial Terms
Price basis: |  | Turnkey EPC, delivered, installed and commissioned at site, Kampala. Currency: USD.
Payment terms: |  | 75 % advance with purchase order · 25 % on commissioning
Taxes: |  | Prices exclude VAT, withholding tax and any other statutory levies, which shall be charged as applicable.
5. Delivery & Project Schedule
Programme: |  | Equipment delivery 8–10 weeks from PO and advance payment; installation and commissioning ≈ 4 weeks after delivery (≈ 12–14 weeks in total).
6. Warranties
PV modules: |  | 15-yr product · 30-yr linear power | Inverters: |  | 5 years (extendable)
Mounting structure: |  | 10 years | Workmanship: |  | 2 years from commissioning
7. Notes & Exclusions
1. Final quantities are subject to detailed engineering and site survey; price will be adjusted for any change in scope.
2. Excluded: roof structural strengthening or waterproofing works, battery storage, utility/permit fees, and works not listed above.
3. Client to provide roof access, connection to the existing Masterpact NW10 H1 solar incomer on the main LV switchboard, and power/water during installation.
4. Energy and savings estimates are given in the accompanying proposal and are indicative only.
