mahilfernando/Tracker-Layout_Tororo-PV/solar-mezzanine-roof/report/Kampala_Marriott_PV_Workings_P50_PVsyst.xlsx

Sheet: Summary
Kampala Marriott Hotel – Rooftop Solar PV: Summary of Workings
185.4 kWp grid-tied, zero-export, no battery · Mezzanine roof (D18102-DD-A-104) · All values link to the working sheets.
Item | Value | Unit | Sheet
System
Modules | 299 | nos | Layout
Module rating | 620 | Wp | Inputs
Plant capacity (DC) | 185.4 | kWp | Layout
Inverters | 2 × 80 kW |  | Inputs
Inverter capacity (AC) | 160 | kW | Electrical
DC/AC ratio | 1.16 |  | Electrical
Tilt | 10 | ° | Inputs
Tables (2P / 1P) | 6 / 1 |  | Layout
Energy
Year-1 generation | 291051 | kWh | Generation
Average monthly generation | 24254.25 | kWh | Generation
Share of hotel consumption | 2.5% |  | Generation
Solar in shoulder period | 100.0% |  | TOU Impact
Solar in peak period | 0.0% |  | TOU Impact
Bill reduction (TOU rates) | 2.46% |  | TOU Impact
Value per solar kWh (TOU) Average | 0.087 | USD/kWh | TOU Impact
Cost & return
Total project value (excl. taxes) | 139881.25 | USD | BOQ
Specific cost | 0.755 | USD/Wp | BOQ
Mounting structure (Enerack, CIF Mombasa) | 77 | USD | Structure
Year-1 savings | 25342.73341 | USD | Financial
Simple payback | 5.4 | years | Financial
Project IRR | 19.2% |  | Financial
NPV (25 years) | 117871.3362 | USD | Financial
LCOE | 0.055 | USD/kWh | Financial
Checks
Row shading | OK |  | Layout
String voltages | OK |  | Electrical
Modules in strings = modules on roof | OK |  | Electrical
Colour code: yellow + blue = input · black = formula · green = link to another sheet.

Sheet: Energy Bill
Energy Bill Analysis – UEDCL bill, CS Hospitality Limited (Kampala Marriott)
Account 110508216496 · Tariff 30.2 Large Consumers – Service · Period 01/10/2026 – 01/11/2026 (31 days, actual) · Invoice 202611EIC0188862201
Bill item | Units | Unit | Rate (UGX) | Amount (UGX) | Share of energy | Note
Energy – peak (18:00–24:00) | 250200 | kWh | 428.80 | 107285760 | 25.5%
Energy – shoulder (06:00–18:00) | 501301 | kWh | 357.00 | 178964457 | 51.1%
Energy – off-peak (00:00–06:00) | 230400 | kWh | 286.50 | 66009600 | 23.5%
Total energy | 981901 | kWh |  | 352259817 | 100.0%
Maximum demand | 1836 | kW | 11096 | 20372256 |  | not reduced by solar (evening peak)
Reactive energy | 221392 | kVArh
Reward | -269558.5 |  | 20 | -5391170
Service charge |  |  |  | 72333.33
Energy amount rebate | 352259817 |  | 40% | -140903926.8 |  | 40 % rebate on all energy charges
VAT (charged on amount before rebate) |  |  | 18% | 66116382.54
Total amount due |  |  |  | 292525692.1 |  | check: bill shows UGX 292,525,692
Demand analysis
Days in billing period | 31 | days
Monthly consumption | 981901 | kWh
Annual consumption (× 12) | 11782812 | kWh/yr
Average daily consumption | 31674.22581 | kWh/day
Average demand – peak band (6 h) | 1345.16129 | kW
Average demand – shoulder band (12 h) | 1347.583333 | kW
Average demand – off-peak band (6 h) | 1238.709677 | kW
Maximum demand | 1836 | kW
Load factor | 71.9%
PV peak output (AC limit 160 kW) ÷ shoulder average demand | 11.9%
Energy rates used (bill tariffs, excluding VAT)
Exchange rate | 4100 | UGX/USD |  |  |  | UGX/USD – market rate Nov 2026 (≈ 4,080–4,130)
Band | Bill tariff (UGX/kWh) | Rate used (UGX/kWh) | Rate used (USD/kWh) | With 40 % rebate (USD/kWh)
Peak | 428.80 | 428.80 | 0.1046 | 0.0628
Shoulder | 357.00 | 357.00 | 0.0871 | 0.0522
Off-peak | 286.50 | 286.50 | 0.0699 | 0.0419
Avoided tariff for solar (all solar in shoulder band, bill tariff, excl. VAT) |  | 357.00 | 0.0871
If VAT is not recoverable: shoulder tariff + 18 % VAT |  | 421.26 | 0.1027
If the 40 % energy rebate is applied: shoulder tariff × 0.6 |  | 214.20 | 0.0522
Base case uses the UEDCL shoulder tariff as billed (UGX 357/kWh), excluding VAT, at UGX 4,100/USD. Solar does not reduce the maximum-demand charge.

Sheet: Inputs
Inputs & Assumptions – Kampala Marriott Rooftop PV
Yellow cells with blue text are inputs. Black = formula, green = link to another sheet. Change inputs here; all sheets update.
Parameter | Value | Unit | Source / note
Site
Project | Kampala Marriott Hotel – mezzanine roof |  | Client: Tororo PV Power Company Limited
Latitude | 0.30315 | ° N | 0°18'11.34"N
Longitude | 32.58716 | ° E | 32°35'13.76"E
Time zone | 3 | UTC +h | East Africa Time
Day length | 12.1 | h | Near-constant at the equator
PV module (620 Wp bifacial TOPCon – confirm with selected datasheet)
Module power | 620 | Wp
Module length | 2382 | mm
Module width | 1134 | mm
Module weight | 33.0 | kg | Dual glass
Voc (STC) | 48.6 | V | Typical
Vmp (STC) | 40.6 | V | Typical
Isc (STC) | 16.1 | A | Typical
Imp (STC) | 15.3 | A | Typical
Temp. coefficient Voc | -0.25% | /°C | -0.25 %/°C
Temp. coefficient Vmp | -0.27% | /°C | -0.27 %/°C
Bifacial / irradiance current factor | 1.25 | × | IEC 62548 string current factor
Minimum cell temperature | 12 | °C | Kampala cool morning
Maximum cell temperature | 65 | °C | Hot roof, low tilt
Roof & layout (drawing D18102-DD-A-104, architect's solar zone only)
Roof inner width | 29264 | mm | Traced from drawing (29,390 dim.)
Upper block inner depth | 15717 | mm | Traced from drawing (15,805 dim.)
Lower block PV-zone depth | 22754 | mm | Joint to architect's PV limit
Tilt | 10 | °
Module clamp gap | 20 | mm
Aisle between tables | 800 | mm | Shading + maintenance walkway
Edge setback (west / north / south) | 1000 | mm
Edge setback (east) | 1742 | mm | Clear of roof opening
Inverters & stringing
Inverter AC rating | 80 | kW | Available sizes: 50/60/80/100/110/125 kW
Number of inverters | 2 | nos
Inverter max. DC voltage | 1100 | V
Inverter MPPT minimum voltage | 200 | V
AC voltage (line-line) | 400 | V
Power factor | 1.00
INV-01: strings (group A) | 8 | nos
INV-01: modules per string (group A) | 19 | nos
INV-01: strings (group B) | 0 | nos
INV-01: modules per string (group B) | 18 | nos
INV-02: strings (group A) | 3 | nos
INV-02: modules per string (group A) | 19 | nos
INV-02: strings (group B) | 5 | nos
INV-02: modules per string (group B) | 18 | nos
Cables & protection
DC string cable length (one way, avg.) | 40 | m | 6 mm² Cu PV cable
DC cable resistance (6 mm², 90 °C) | 3.950 | Ω/km
Inverter → ACCP cable length | 30 | m | 4C × 50 mm² Cu XLPE
Resistance 50 mm² Cu (90 °C) | 0.494 | Ω/km
ACCP → MLVS cable length | 80 | m | 4C × 120 mm² Cu XLPE/SWA (confirm route)
Resistance 120 mm² Cu (90 °C) | 0.196 | Ω/km
Reactance (AC cables) | 0.080 | Ω/km
Inverter outgoing MCCB rating | 125 | A | In ACCP
PV feeder MCCB rating | 250 | A | ACCP outgoing & MLVS PV way
Main incomer (existing) | 1000 | A | Schneider Masterpact NW10 H1, 65 kA
Switchboard fault level | 65 | kA | Masterpact NW10 H1 Icu
PV MCCB breaking capacity Icu | 70 | kA | e.g. NSX250 H
Energy & load
Specific yield, year 1 (incl. losses) | 1570.023735 | kWh/kWp/yr | PVsyst V8.1.8 VC0 (09/11/2026), P50 as simulated: 291,051 kWh ÷ 185.38 kWp
Degradation, year 1 | 1.0%
Degradation, year 2 onward | 0.4% | per yr
Hotel consumption | 981901 | kWh/month | UEDCL bill Oct 2026 (981,901 kWh)
Time-of-use tariff (UEDCL bill Oct 2026, tariffs as billed, excl. VAT, UGX 4,100/USD)
Off-peak start / end | 0 | h | 00:00 |  | Avoided (shoulder) | 357.00 | 0.0871
Shoulder start | 6 | h | 06:00 |  | peak | 428.80 | 0.1046
Peak start | 18 | h | 18:00 – 24:00 |  | shoulder | 357.00 | 0.0871
Off-peak rate | 0.070 | USD/kWh | UEDCL bill |  | off peak | 286.50 | 0.0699
Shoulder rate | 0.087 | USD/kWh | UEDCL bill
Peak rate | 0.105 | USD/kWh | UEDCL bill
Financial
Avoided tariff used in cash flow (year 1) | 0.087 | USD/kWh | Shoulder tariff as billed – all solar is in the shoulder band
Tariff escalation | 2.0% | per yr
Discount rate | 10.0%
O&M cost (% of capex, year 1) | 1.2% |  | Cleaning, inspection, monitoring
O&M escalation | 3.0% | per yr
Inverter replacement year | 12 | year
Contingency | 7.0%
EPC unit rates (2026 East Africa, ±15 %)
PV modules (landed, cleared) | 0.130 | USD/Wp
String inverter | 4000 | USD each | 80 kW, incl. comms
Mounting structure (incl. ballast, pads) | 0.095 | USD/Wp | Enerack quote within this allowance
DC system | 0.035 | USD/Wp | Cable, MC4, isolators, SPD
AC system | 32228 | USD | Lump sum
Earthing & lightning protection | 1985.25 | USD | Lump sum
Installation, testing & commissioning | 5000 | USD/Wp
Transport, logistics & customs clearing | 8650 | USD | Lump sum
Enerack structure unit prices (quote ERKI20261104TP, EXW)
R80 rail L=3000 | 16.64 | USD/kit
R80 rail L=2630 | 14.58 | USD/kit
Rail connect | 1.19 | USD/kit
Rail clamp | 0.22 | USD/kit
30 mm end clamp | 0.30 | USD/kit
Inner clamp 30–40 mm | 0.30 | USD/kit
Pre-assembly frame L=3800 (2P) | 40.40 | USD/kit
Pre-assembly frame L=1400 (1P) | 20.64 | USD/kit
Cross brace L=2725 | 6.85 | USD/kit
M8×70 bolt | 0.20 | USD/kit
Earthing lug | 0.28 | USD/kit
Freight to Mombasa | 1300 | USD
Rail clamps per rail–frame crossing | 2.259 | nos | From quote: 795 clamps for 352 crossings
Bolts per frame | 1.566 | nos | From quote: 155 bolts for 99 frames
Earthing lugs per rail line | 1.031 | nos | From quote: 33 lugs for 32 rail lines
Cross braces per 2P table | 20 | nos | From quote: 140 for 7 tables
Frames per table | 11 | nos | First at 315 mm, then 10 × 2,600 mm
 | Container Size | Transport Cost Mombasa to Uganda | Clearance | Total Cost
module | 40 | 3850 | 250 | 4100
strcture | 20 | 2300 | 250 | 2300
inverter | 2 | 2000 | 250 | 2250
 |  |  |  | 8650

Sheet: BOQ
Cost Estimate – Bill of Quantities (USD, excluding taxes)
 |  |  |  |  |  |  | Columns G–J are internal working – margin is included in modules and installation, not shown to the client.
No. | Description | Quantity | Unit | Rate (USD) | Amount (USD) |  | Base cost (internal) | Margin share | Margin (internal)
1 | PV modules, 620 Wp | 185380 | Wp | 0.205 | 38087 |  | 24099 | 50% | 13988
2 | String inverters, 80 kW | 2 | nos | 4000 | 8000 |  | 8000
3 | Mounting structure | 185380 | Wp | 0.095 | 17634 |  | 17634
4 | DC Cable system | 185380 | Wp | 0.035 | 6488 |  | 6488
5 | AC Cable system | 1 | lot | 32228 | 32228 |  | 32228
7 | Earthing,system & lightning protection | 1 | lot | 1985.25 | 1985 |  | 1985
8 | Installation, testing & commissioning | 1 | lot | 18988.25 | 18988.25 |  | 5000 | 50% | 13988.25
9 | Transport, logistics & customs clearing | 1 | lot | 8650 | 9150 |  | 9150
 | Sub-total |  |  |  | 132560.25 |  | 104584
 | Contingency |  |  | 7.0% | 7321
 | Total Project Value (excluding taxes) |  |  |  | 139881.25 | EPC cost (internal) | 111905
 |  |  |  |  |  | 25 % margin (internal) | 27976.25
 | Specific cost |  | USD/Wp |  | 0.755 |  | 249.01

Sheet: Layout
Layout & Row-Spacing Working
Tables are 2 modules high in portrait (2P) or 1 module high (1P).
Item | Value | Unit | Working
Table geometry
2P slope length | 4784 | mm | 2 × module length + gap
2P table depth on plan | 4711.32029 | mm | slope × cos(tilt)
2P rise (rear above front) | 830.732882 | mm | slope × sin(tilt)
1P table depth on plan | 2345.812068 | mm
1P rise | 413.6299592 | mm
Modules per row | 23 | nos | fits between setbacks
Row length (modules) | 26522 | mm
Upper block
Available depth | 13717 | mm | depth − 2 setbacks
2P tables | 2 | nos
Depth left after 2P tables | 3494.359419 | mm
1P tables | 1 | nos | one 1P row if it fits
Modules | 115 | nos
Lower block (to architect's PV limit)
Available depth | 21754 | mm | setback at top only
2P tables | 4 | nos
Depth left after 2P tables | 508.7188384 | mm
1P tables | 0 | nos
Modules | 184 | nos
Totals
2P tables (total) | 6 | nos
1P tables (total) | 1 | nos
Total modules | 299 | nos
Plant capacity (DC) | 185.38 | kWp
Module area | 807.655212 | m²
Module weight (total) | 9.9 | t
Row-to-row shading check (panels facing the equator, no shading 09:00–15:00 all year)
Sun position | Declination (°) | Hour angle (°) | Elevation (°) | N-S component | Shadow gap needed (mm)
21 Dec, 09:00 / 15:00 | -23.45 | 45 | 40.3 | 0.401 | 515.6828397
21 Dec, 12:00 | -23.45 | 0 | 66.2 | 0.403 | 365.5857322
21 Jun, 09:00 / 15:00 | 23.45 | 45 | 40.6 | -0.395 | 0
21 Jun, 12:00 | 23.45 | 0 | 66.9 | -0.393 | 0
Largest shadow gap needed | 515.6828397 | mm | worst case of the rows above
Aisle provided | 800 | mm
Shading check | OK

Sheet: Electrical
Electrical Working – Strings, Inverters, Cables, Protection
Item | Value | Unit | Working
Module voltages at temperature extremes
Voc at minimum cell temperature | 50.18 | V | Voc × (1 + k × (Tmin − 25))
Vmp at maximum cell temperature | 36.22 | V | Vmp × (1 + k × (Tmax − 25))
Max. modules per string | 21 | nos | inverter max DC ÷ Voc cold
Min. modules per string | 6 | nos | MPPT min ÷ Vmp hot
Design string current | 20.1 | A | Isc × factor
Inverter configuration
 | INV-01 | INV-02 | Total
Strings | 8 | 8 | 16
Modules | 152 | 147 | 299
DC capacity (kWp) | 94.24 | 91.14 | 185.38
AC rating (kW) | 80 | 80 | 160
DC/AC ratio | 1.18 | 1.14 | 1.16
Longest string Voc cold (V) | 953.4105 | 953.4105 | 953.4105
Shortest string Vmp hot (V) | 688.0888 | 651.8736 | 651.8736
AC current at rated output (A) | 115.5 | 115.5 | 230.9
Checks
Modules in strings = modules on roof | OK
String Voc cold ≤ inverter max DC | OK
String Vmp hot ≥ MPPT minimum | OK
DC/AC ratio between 1.0 and 1.35 | OK
Inverter MCCB ≥ inverter current | OK
PV feeder MCCB ≥ total PV current | OK
PV MCCB Icu ≥ switchboard fault level | OK
PV current ≤ 25 % of main incomer | OK
Voltage drop
DC string voltage (19 modules at Vmp STC) | 771.4 | V
DC voltage drop | 4.83 | V | 2 × L × Imp × R
DC voltage drop | 0.63% | % | target ≤ 1.5 %
AC drop inverter → ACCP | 0.74% | % | √3·I·L·(R cosφ + X sinφ) / V
AC drop ACCP → MLVS | 1.57% | %
Total AC voltage drop | 2.31% | % | target ≤ 3 %
Voltage-drop check | OK

Sheet: DC & AC Earthing System
DC System – Bottom-up Breakdown
PV strings to inverter DC inputs. Quantities from Inputs (strings, cable run) and Layout (tables).
No. | Item | Quantity | Unit | Rate (USD) | Amount (USD) | Quantity working | Local Market Price (UGX) | USD
1 | PV cable 4 mm² (red + black) | 1600 | m | 1.45 | 2320 | strings × (2 × one-way run + 10 m row links) × 1.10 waste | 5925.5 | 1.45
2 | MC4 connector pairs | 71 | pairs | 2.68 | 190.28 | 4 pairs per string + 10 % spares | 11000 | 2.68
3 | String DC isolator 1,000 V, 32 A | 16 | nos | 37.00 | 592 | 1 per string | 150000 | 36.59
4 | DC SPD Type II, 2 pole 1000 V DC | 16 | nos | 37.00 | 592 |  | 150000 | 36.59
5 | Cable tray | 100 | m | 17.60 | 1760 | 100mm*25mm | 72000 | 17.56
6 | Tray supports / non-penetrating roof blocks & fixings | 1 | lot | 450.00 | 450 | lot
7 | Flexible conduit, glands & entry fittings | 1 | lot | 250.00 | 250 | lot
8 | UV-resistant cable ties, module cable clips | 1 | lot | 150.00 | 150 | lot
9 | String labels & DC warning signage | 1 | lot | 100.00 | 100 | lot
 | Transport
 | Total (bottom-up) |  |  |  | 6404.28
 | Current BOQ allowance (USD/Wp × Wp) |  |  |  | 7416 | 0.04
 | Difference (bottom-up − allowance) |  |  |  | 1011.72
 | Bottom-up cost per Wp |  |  |  | 0.035
 |  |  |  |  |  |  |  |  |  | String DC isolator 1,000 V, 32 A, IP66
 |  |  |  |  |  |  |  |  |  | DC SPD Type II
 |  |  |  |  |  |  |  |  |  | MCCB 125 A 3P, Icu ≥ 36 kA
AC System – Bottom-up Breakdown |  |  |  |  |  |  |  |  |  | MCCB 250 A 3P
 |  |  |  |  |  |  |  |  |  | SPD Type II, 3P+N, 400 V
 |  |  |  |  |  |  |  |  |  | Switch-disconnector 250 A
No. | Item | Quantity | Unit | Rate (USD) | Amount (USD) | Quantity working | Local Market Price (UGX) | USD
1 | ACCP enclosure IP65, 250 A busbar, wiring, assembly | 1 | nos | 400.00 | 400 |  | 1600000 | 390.24
2 | enclosure IP6 for DC Isolators & SPD Panel | 2 | nos | 250.00 | 250 |  | 1025000 | 250
3 | enclosure IP6 for AC MCCB Panel | 1 | nos | 250.00 | 250 |  | 1025000 | 250
2 | MCCB 125 A 4P | 2 | nos | 66.00 | 132 |  | 272000 | 66.34
3 | MCCB 250 A 4P | 1 | nos | 66.00 | 66 |  | 272000 | 66.34
4 | SPD Type II, 3P+N, 400 V (ACCP) | 1 | nos | 40.00 | 40 |  | 150000 | 36.59
5 | Switch-disconnector 250 A (roof isolator) | 1 | nos | 300.00 | 300 |  | 961000 | 234.39
6 | Cable 4C × 50 mm² Cu XLPE (inverter → ACCP) | 10 | m | 40.00 | 400 |  | 150000 | 36.59
7 | Earth cable 25 mm² Cu (inverter → ACCP) | 10 | m | 4.00 | 40 |  | 15000 | 3.66
8 | Cable 4C × 240 mm² Al XLPE/SWA (ACCP → MLVS) | 200 | m | 146.00 | 29200 | Avaiable Spares at tororo PV./ Cable 4C × 150 mm² cu XLPE/SW USD.106/m | 600000 | 146.34
9 | Earth cable 120 mm² Cu (ACCP → MLVS) | 200 | m |  | 0 | Not Reruired, XLPE armored can use for earthing from one side
11 | Cable glands, lugs, terminations | 1 | lot | 250.00 | 250
13 | MLVS busbar connection kit & panel modification | 1 | lot | 300.00 | 300
14 | Inverter mounting frames & sun-shade canopies | 2 | nos | 300.00 | 600
 | Total Cost |  |  |  | 32228
 |  |  |  |  | 32228
 | cost per Wp |  |  |  | 1.738
Earthing & Lightning Protection – Bottom-up Breakdown
No. | Item | Quantity | Unit | Rate (USD) | Amount (USD) | Quantity working | Local Market Price (UGX) | USD
1 | Panel-to-panel bonding jumpers 4 mm² Cu, green/yellow, UV-resistant | 385 | m | 1.45 | 558.25 | 13 rows × 22 jumpers × 1.3 m (286 nos) + 7 table-to-rail jumpers | 5926 | 1.45
2 | Row-end earth leads 16 mm² Cu, green/yellow | 60 | m | 2.50 | 150 | 13 rows × 2 ends (26 nos), last panel → tray earth | 9000 | 2.20
3 | Tray earth conductor 35 mm² Cu (array → ACCP earth bar) | 45 | m | 5.00 | 225 | along east-corridor tray to inverter station | 20000 | 4.88
4 | Crimp lugs, tinned Cu, 4 mm² / M6 | 590 | nos | 0.30 | 177 | 2 per jumper | 1200 | 0.29
5 | Stainless M6 bolt + serrated (star) washer + nut | 600 | sets | 0.30 | 180 | 1 per lug at panel earthing holes
6 | Bimetallic (Al–Cu) clamps on rails / tray earth | 40 | nos | 3.00 | 120 | 7 tables × 2 + 26 row-end connections
7 | Inverter, DC SPD unit & ACCP earth bonding (16 mm² Cu + lugs) | 5 | sets | 25.00 | 125 | 2 inverters + 2 DC SPD units + ACCP earth bar
9 | Connection to existing LPS: clamps, test joints, separation-distance fittings | 1 | lot | 250.00 | 250 | IEC 62305 tie-in
10 | Earth pit: 1.5 m Cu-bonded rod | 1 | nos | 150.00 | 150 | only if the building earth is inadequate | 330000 | 80.48780488 | 120.7317073
11 | Earthing labels & warning signs | 1 | lot | 50.00 | 50 | lot
 | Total (bottom-up) |  |  |  | 1985.25
 | Current BOQ allowance (lump sum) |  |  |  | 2500
 | Difference (bottom-up − allowance) |  |  |  | -173.5

Sheet: Structure
Bill of Quantities – PV Mounting Structure (Enerack Ballast System)
Kampala Marriott Hotel – mezzanine roof rooftop PV, 185.4 kWp · values exactly as quoted by the supplier
Supplier | Xiamen Enerack Technology Co., Ltd., Xiamen, China
Quote / invoice No. | ERKI20261104TP
Date | 2026-11-04
To | Tororo PV Power Company Limited, Kampala, Uganda
Drawing | EPJ-26110401 V1.0 (2P and 1P tables, 10° tilt, wind 35 m/s)
Module | 2382 × 1134 × 30 mm
Incoterm | EXW unit prices; freight to Mombasa quoted separately (CIF Mombasa)
No. | Item No. | Description | Qty | Unit | Unit price EXW (USD) | Amount (USD)
1 | ERK-R80-3000 | R80 Rail L=3000 | 256 | kits | 16.64 | 4258.56
2 | ERK-R80-2630 | R80 Rail L=2630 | 32 | kits | 14.58 | 466.67
3 | ERK-SFR-R80 | Rail connect | 256 | kits | 1.19 | 304.64
4 | ERK-GRC | Rail clamp | 795 | kits | 0.22 | 178.59
5 | ERK-FEC-30 | 30 mm end clamp | 65 | kits | 0.30 | 19.47
6 | ERK-AIC | Adjustable (30–40 mm) inner clamp | 707 | kits | 0.30 | 212.10
7 | ERK-W45-3800 | Pre-assembly L=3800 (2P frame) | 77 | kits | 40.40 | 3110.80
8 | ERK-W45-1400 | Pre-assembly L=1400 (1P frame) | 22 | kits | 20.64 | 454.08
9 | ERK-35JL-2725 | Cross L=2725 | 140 | kits | 6.85 | 958.77
10 | ERK-M8X70 | M8×70 bolt | 155 | kits | 0.20 | 31.00
11 | ERK-ELG-03 | Earthing lug | 33 | kits | 0.28 | 9.24
 |  | Sub-total EXW | 2538 |  |  | 10003.92
 |  | Freight cost to Mombasa Port, Kenya |  |  |  | 1300.00
 |  | Total CIF Mombasa |  |  |  | 11303.92
 |  | Total Taxes + CIF |  |  |  | 17634.1152
 |  | Transport |  |  |  |  | 2500
 |  |  |  |  |  | 17634.12
Cost per Wp (CIF, 185.4 kWp plant) |  |  |  | Wp | 185380 | 0.095 | 0.09512415147
Blue = value from the supplier's quote (edit if the quote is revised); black = formula.
 | package size | 12 m^3
 | weight

Sheet: Generation
Estimated PV Solar Generation
Monthly shape and annual total from the PVsyst simulation (P50, Meteonorm 9.0, as simulated – no shading/soiling losses modelled).
Plant capacity | 185.38 | kWp
Year-1 generation | 291051 | kWh | kWp × specific yield (PVsyst P50)
Hotel consumption | 11782812 | kWh/yr | 981901
Share of hotel consumption | 2.47%
Month | Days | GHI (kWh/m²/day) | Weight | Share | Generation (kWh) | Generation (MWh) | kWh/day | PVsyst E_Grid (kWh) | PVsyst GlobHor (kWh/m²)
Jan | 31 | 5.29 | 27523.0 | 9.5% | 27523 | 27.5 | 887.8387097 | 27523 | 163.9
Feb | 28 | 5.56 | 25387.0 | 8.7% | 25387 | 25.4 | 906.6785714 | 25387 | 155.8
Mar | 31 | 5.49 | 26942.0 | 9.3% | 26942 | 26.9 | 869.0967742 | 26942 | 170.3
Apr | 30 | 4.89 | 22443.0 | 7.7% | 22443 | 22.4 | 748.1 | 22443 | 146.6
May | 31 | 4.92 | 22628.0 | 7.8% | 22628 | 22.6 | 729.9354839 | 22628 | 152.4
Jun | 30 | 4.91 | 21387.0 | 7.3% | 21387 | 21.4 | 712.9 | 21387 | 147.4
Jul | 31 | 5.11 | 23038.0 | 7.9% | 23038 | 23.0 | 743.1612903 | 23038 | 158.5
Aug | 31 | 5.17 | 24154.0 | 8.3% | 24154 | 24.2 | 779.1612903 | 24154 | 160.2
Sep | 30 | 5.32 | 24885.0 | 8.6% | 24885 | 24.9 | 829.5 | 24885 | 159.5
Oct | 31 | 5.02 | 24993.0 | 8.6% | 24993 | 25.0 | 806.2258065 | 24993 | 155.5
Nov | 30 | 4.60 | 22933.0 | 7.9% | 22933 | 22.9 | 764.4333333 | 22933 | 138.1
Dec | 31 | 4.74 | 24738.0 | 8.5% | 24738 | 24.7 | 798 | 24738 | 146.8
Year | 365 | 5.08 | 291051.0 | 100.0% | 291051 | 291.1 | 797.4 | 291051 | 1855
Monthly average |  |  |  |  | 24254.25 | 24.3

Sheet: TOU Impact
Solar Impact on Time-of-Use Tariff – Average Day
Solar: sine profile between sunrise and sunset (formula). Load: hotel hourly profile scaled so the band totals match the UEDCL bill (Oct 2026).
Solar noon (EAT) | 12.88 | h | longitude correction + equation-of-time avg
Sunrise | 6.83 | h
Sunset | 18.93 | h
Solar per average day | 797.4 | kWh/day
Hotel load per average day | 32281.67671 | kWh/day
Hour | Period | Rate (USD/kWh) | Sun-up from | Sun-up to | Load profile factor | Solar share | Solar (kWh) | Hotel load (kWh) | Grid after solar (kWh)
00:00 | Off-peak | 0.070 | 6.83 | 1.00 | 1.01 | 0.00% | 0.0 | 1294.109859 | 1294.109859
01:00 | Off-peak | 0.070 | 6.83 | 2.00 | 0.97 | 0.00% | 0.0 | 1242.376197 | 1242.376197
02:00 | Off-peak | 0.070 | 6.83 | 3.00 | 0.94 | 0.00% | 0.0 | 1207.801721 | 1207.801721
03:00 | Off-peak | 0.070 | 6.83 | 4.00 | 0.94 | 0.00% | 0.0 | 1207.801721 | 1207.801721
04:00 | Off-peak | 0.070 | 6.83 | 5.00 | 0.97 | 0.00% | 0.0 | 1242.376197 | 1242.376197
05:00 | Off-peak | 0.070 | 6.83 | 6.00 | 1.08 | 0.00% | 0.0 | 1380.417997 | 1380.417997
06:00 | Shoulder | 0.087 | 6.83 | 7.00 | 0.84 | 0.05% | 0.4 | 1071.680725 | 1071.281023
07:00 | Shoulder | 0.087 | 7.00 | 8.00 | 0.97 | 2.25% | 17.9 | 1240.839554 | 1222.907768
08:00 | Shoulder | 0.087 | 8.00 | 9.00 | 1.06 | 5.45% | 43.4 | 1353.654791 | 1310.225803
09:00 | Shoulder | 0.087 | 9.00 | 10.00 | 1.10 | 8.28% | 66.0 | 1410.126436 | 1344.111418
10:00 | Shoulder | 0.087 | 10.00 | 11.00 | 1.13 | 10.56% | 84.2 | 1443.932591 | 1359.75672
11:00 | Shoulder | 0.087 | 11.00 | 12.00 | 1.15 | 12.13% | 96.7 | 1466.470028 | 1369.775855
12:00 | Shoulder | 0.087 | 12.00 | 13.00 | 1.15 | 12.88% | 102.7 | 1466.470028 | 1363.739244
13:00 | Shoulder | 0.087 | 13.00 | 14.00 | 1.15 | 12.78% | 101.9 | 1466.470028 | 1364.588975
14:00 | Shoulder | 0.087 | 14.00 | 15.00 | 1.13 | 11.81% | 94.2 | 1443.932591 | 1349.73065
15:00 | Shoulder | 0.087 | 15.00 | 16.00 | 1.10 | 10.06% | 80.2 | 1410.126436 | 1329.918236
16:00 | Shoulder | 0.087 | 16.00 | 17.00 | 1.06 | 7.63% | 60.8 | 1353.654791 | 1292.816919
17:00 | Shoulder | 0.087 | 17.00 | 18.00 | 1.06 | 4.69% | 37.4 | 1353.654791 | 1316.265386
18:00 | Peak | 0.105 | 18.00 | 18.93 | 1.29 | 1.44% | 11.5 | 1655.733275 | 1644.228068
19:00 | Peak | 0.105 | 19.00 | 18.93 | 1.24 | 0.00% | 0.0 | 1589.529554 | 1589.529554
20:00 | Peak | 0.105 | 20.00 | 18.93 | 1.14 | 0.00% | 0.0 | 1457.122114 | 1457.122114
21:00 | Peak | 0.105 | 21.00 | 18.93 | 1.01 | 0.00% | 0.0 | 1298.079521 | 1298.079521
22:00 | Peak | 0.105 | 22.00 | 18.93 | 0.91 | 0.00% | 0.0 | 1165.67208 | 1165.67208
23:00 | Peak | 0.105 | 23.00 | 18.93 | 0.83 | 0.00% | 0.0 | 1059.643685 | 1059.643685
Day total |  |  |  |  | 25.21 | 100.0% | 797.4 | 32281.67671 | 31484.27671
Period | Rate (USD/kWh) | Hotel use (MWh/yr) | Solar (MWh/yr) | Share of solar | Grid after solar (MWh/yr) | Reduction | Cost before (USD/yr) | Cost after (USD/yr) | Saving (USD/yr)
Off-peak | 0.070 | 2764.832547 | 0.0 | 0.0% | 2764.832547 | 0.00% | 193201.1036 | 193201.1036 | 0
Shoulder | 0.087 | 6015.569669 | 291.1 | 100.0% | 5724.518669 | 4.84% | 523794.7248 | 498451.9914 | 25342.73341
Peak | 0.105 | 3002.409784 | 0.0 | 0.0% | 3002.409784 | 0.00% | 314008.1257 | 314008.1257 | 0
Total |  | 11782.812 | 291.1 | 100.0% | 11491.761 | 2.47% | 1031003.954 | 1005661.221 | 25342.73341
Bill reduction |  |  |  |  |  |  |  |  | 2.46%
Value per solar kWh (USD) |  |  |  |  |  |  |  |  | 0.087
Avoided tariff for solar |  |  |  |  |  |  |  |  | 0.09
 | Avoided (shoulder) | 357.00 | 0.09
 | peak | 428.80 | 0.10
 | shoulder | 357.00 | 0.09
 | off peak | 286.50 | 0.07
Note: the small solar output just after 18:00 is counted in the shoulder period – no solar energy is assigned to the peak band.

Sheet: Financial
Financial Analysis – 25-Year Cash Flow (USD)
Savings use the flat avoided tariff on Inputs; see the TOU sheet for value by tariff period.
Year | Generation (kWh) | Tariff (USD/kWh) | Savings | O&M | Inverter replacement | Net cash flow | Cumulative | Discount factor | Disc. cash flow | Disc. generation | Disc. costs (O&M + repl.)
0 |  |  |  |  |  | -139881.25 | -139881.25 | 1.0000 | -139881.25
1 | 291051 | 0.087 | 25342.73341 |  | 0 | 25342.73341 | -114538.5166 | 0.9091 | 23038.84856 | 264591.8182 | 0
2 | 286987.928 | 0.089 | 25488.72783 |  | 0 | 25488.72783 | -89049.78875 | 0.8264 | 21065.06433 | 237180.1058 | 0
3 | 285839.9763 | 0.091 | 25894.50838 |  | 0 | 25894.50838 | -63155.28037 | 0.7513 | 19454.92741 | 214755.8049 | 0
4 | 284696.6164 | 0.092 | 26306.74895 |  | 0 | 26306.74895 | -36848.53142 | 0.6830 | 17967.8635 | 194451.6197 | 0
5 | 283557.83 | 0.094 | 26725.5524 |  | 0 | 26725.5524 | -10122.97902 | 0.6209 | 16594.46535 | 176067.1029 | 0
6 | 282423.5986 | 0.096 | 27151.02319 |  | 0 | 27151.02319 | 17028.04417 | 0.5645 | 15326.04477 | 159420.7587 | 0
7 | 281293.9042 | 0.098 | 27583.26748 |  | 0 | 27583.26748 | 44611.31165 | 0.5132 | 14154.57763 | 144348.2506 | 0
8 | 280168.7286 | 0.100 | 28022.3931 |  | 0 | 28022.3931 | 72633.70475 | 0.4665 | 13072.65319 | 130700.7796 | 0
9 | 279048.0537 | 0.102 | 28468.5096 |  | 0 | 28468.5096 | 101102.2143 | 0.4241 | 12073.42712 | 118343.615 | 0
10 | 277931.8615 | 0.104 | 28921.72827 |  | 0 | 28921.72827 | 130023.9426 | 0.3855 | 11150.57825 | 107154.7641 | 0
11 | 276820.1341 | 0.106 | 29382.16218 |  | 0 | 29382.16218 | 159406.1048 | 0.3505 | 10298.2686 | 97023.76824 | 0
12 | 275712.8535 | 0.108 | 29849.92621 |  | 0 | 29849.92621 | 189256.031 | 0.3186 | 9511.106396 | 87850.61197 | 0
13 | 274610.0021 | 0.110 | 30325.13703 |  | 0 | 30325.13703 | 219581.168 | 0.2897 | 8784.112008 | 79544.73593 | 0
14 | 273511.5621 | 0.113 | 30807.91321 |  | 0 | 30807.91321 | 250389.0812 | 0.2633 | 8112.686429 | 72024.14271 | 0
15 | 272417.5158 | 0.115 | 31298.37519 |  | 0 | 31298.37519 | 281687.4564 | 0.2394 | 7492.582179 | 65214.5874 | 0 | 1044878.05
16 | 271327.8458 | 0.117 | 31796.64532 |  | 0 | 31796.64532 | 313484.1018 | 0.2176 | 6919.876443 | 59048.84459 | 0
17 | 270242.5344 | 0.120 | 32302.84792 |  | 0 | 32302.84792 | 345786.9497 | 0.1978 | 6390.946251 | 53466.04474 | 0
18 | 269161.5643 | 0.122 | 32817.10926 |  | 0 | 32817.10926 | 378604.0589 | 0.1799 | 5902.445559 | 48411.07324 | 0
19 | 268084.918 | 0.124 | 33339.55764 |  | 0 | 33339.55764 | 411943.6166 | 0.1635 | 5451.284084 | 43834.02631 | 0
20 | 267012.5783 | 0.127 | 33870.32339 |  | 0 | 33870.32339 | 445813.94 | 0.1486 | 5034.607752 | 39689.71837 | 0
21 | 265944.528 | 0.129 | 34409.53894 |  | 0 | 34409.53894 | 480223.4789 | 0.1351 | 4649.780643 | 35937.23591 | 0
22 | 264880.7499 | 0.132 | 34957.3388 |  | 0 | 34957.3388 | 515180.8177 | 0.1228 | 4294.368319 | 32539.5336 | 0
23 | 263821.2269 | 0.135 | 35513.85964 |  | 0 | 35513.85964 | 550694.6773 | 0.1117 | 3966.12242 | 29463.06861 | 0
24 | 262765.942 | 0.137 | 36079.24028 |  | 0 | 36079.24028 | 586773.9176 | 0.1015 | 3662.966445 | 26677.46939 | 0
25 | 261714.8782 | 0.140 | 36653.62179 |  | 0 | 36653.62179 | 623427.5394 | 0.0923 | 3382.98261 | 24155.23592 | 0
Total | 6871028.331 |  | 763308.7894 | 0 | 0 | 623427.5394 | 5664055.811 |  | 117871.3362 | 2541894.716 | 0
Results
Investment (EPC) | 139881.25 | USD
Year-1 savings | 25342.73341 | USD
Simple payback | 5.4 | years
Project IRR (25 years) | 19.2% |  |  |  |  |  | Put the formula back, =(capex + total discounted costs) ÷ total discounted generation, and it will give 0.05
NPV at discount rate | 117871.3362 | USD
LCOE | 0.055 | USD/kWh
25-year generation | 6871.028331 | MWh
25-year net savings (before capex) | 763308.7894 | USD
LCOE = (capex + discounted O&M and replacement) ÷ discounted generation. Payback interpolated within the year it turns positive.

Sheet: Sensitivity
Tariff Sensitivity
Each column recomputes the 25-year cash flow at a different avoided tariff (year 1).
Avoided tariff (USD/kWh) | Payback (yrs) | IRR | NPV (USD)
0.087 | 5.4 | 19.22695809% | 117871.3362
0.060 | 7.7 | 13.12330962% | 37729.77582
0.070 | 6.6 | 15.43749128% | 67331.61345
0.080 | 5.8 | 17.67583846% | 96933.45109
0.100 | 4.7 | 22.01438554% | 156137.1264
12% |  |  |  | Tariff → | 0.087 | 0.060 | 0.070 | 0.080 | 0.100
0.09752195122 |  |  |  | Year | Cash flow @ F11 | Cash flow @ G11 | Cash flow @ H11 | Cash flow @ I11 | Cash flow @ J11 | Cumulative @ F11 | Cumulative @ G11 | Cumulative @ H11 | Cumulative @ I11 | Cumulative @ J11
0.1092245854 |  |  |  | 0 | -139881.25 | -139881.25 | -139881.25 | -139881.25 | -139881.25 | -139881.25 | -139881.25 | -139881.25 | -139881.25 | -139881.25
0.1223315356 |  |  |  | 1 | 25342.73341 | 17463.06 | 20373.57 | 23284.08 | 29105.1 | -114538.5166 | -122418.19 | -119507.68 | -116597.17 | -110776.15
0.1370113199 |  |  |  | 2 | 25488.72783 | 17563.6612 | 20490.93806 | 23418.21493 | 29272.76866 | -89049.78875 | -104854.5288 | -99016.74194 | -93178.95507 | -81503.38134
 |  |  |  | 3 | 25894.50838 | 17843.27468 | 20817.1538 | 23791.03291 | 29738.79114 | -63155.28037 | -87011.25412 | -78199.58814 | -69387.92216 | -51764.5902
 |  |  |  | 4 | 26306.74895 | 18127.33962 | 21148.56288 | 24169.78615 | 30212.23269 | -36848.53142 | -68883.91451 | -57051.02526 | -45218.13601 | -21552.35751
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
0.05 | 13718 | 8.9 | 10.60% | 6840
0.06 | 16462 | 7.5 | 13.10% | 34744
0.07 | 19205 | 6.5 | 15.50% | 62649
0.08 | 21949 | 5.7 | 17.80% | 90553
0.09 | 24693 | 5.1 | 20.00% | 118458
0.1 | 27436 | 4.6 | 22.20% | 146362
0.12 | 32923 | 3.9 | 26.60% | 202171
