mahilfernando/Tracker-Layout_Tororo-PV/solar-mezzanine-roof/report/Kampala_Marriott_Earthing_AC_BOQ.xlsx

Sheet: Earthing BOQ
Earthing & Bonding BOQ – panel-to-panel bonding (revised)
Kampala Marriott Hotel – 185.4 kWp rooftop PV · NileSun Power Ltd · yellow = input, blue = estimated rate (confirm)
No. | Item | Quantity | Unit | Rate (USD) | Amount (USD) | Quantity working
1 | Panel-to-panel bonding jumpers 6 mm² Cu, green/yellow, UV-resistant | 385 | m | 0.80 | 308 | 13 rows × 22 jumpers × 1.3 m (286 nos) + 7 table-to-rail jumpers
2 | Row-end earth leads 16 mm² Cu, green/yellow | 60 | m | 2.50 | 150 | 13 rows × 2 ends (26 nos), last panel → tray earth
3 | Tray earth conductor 35 mm² Cu (array → ACCP earth bar) | 45 | m | 5.00 | 225 | along east-corridor tray to inverter station
4 | Crimp lugs, tinned Cu, 6 mm² / M6 | 590 | nos | 0.15 | 88.5 | 2 per jumper
5 | Stainless M6 bolt + serrated (star) washer + nut | 600 | sets | 0.30 | 180 | 1 per lug at panel earthing holes
6 | Bimetallic (Al–Cu) clamps on rails / tray earth | 40 | nos | 3.00 | 120 | 7 tables × 2 + 26 row-end connections
7 | Inverter, DC SPD unit & ACCP earth bonding (16 mm² Cu + lugs) | 5 | sets | 25.00 | 125 | 2 inverters + 2 DC SPD units + ACCP earth bar
8 | Air-termination rods 1 m with concrete bases (array perimeter) | 6 | nos | 80.00 | 480 | only if the array is outside the existing LPS protection zone
9 | Connection to existing LPS: clamps, test joints, separation-distance fittings | 1 | lot | 250.00 | 250 | IEC 62305 tie-in
10 | Earth pit: 1.5 m Cu-bonded rod | 1 | nos | 350.00 | 350 | only if the building earth is inadequate
11 | Earthing labels & warning signs | 1 | lot | 50.00 | 50 | lot
 | Total (bottom-up) |  |  |  | 2326.5
 | Current BOQ allowance (lump sum) |  |  |  | 2500
 | Difference (bottom-up − allowance) |  |  |  | -173.5
E3 (120 mm² Cu ≈ 200 m, ACCP earth bar → MET) is included in the AC BOQ sheet.

Sheet: AC BOQ
AC System BOQ – revised (C3 ≈ 200 m, 4C × 240 mm²)
Kampala Marriott Hotel – 185.4 kWp rooftop PV · NileSun Power Ltd · yellow = input, blue = estimated rate (confirm)
No. | Item | Quantity | Unit | Rate (USD) | Amount (USD) | Quantity working
1 | ACCP enclosure IP65, 400 A busbar, wiring, assembly | 1 | nos | 1000.00 | 1000 | AC combiner panel on the roof
2 | MCCB 4P 160 A (Ir 140 A), Icu ≥ 25 kA – inverter incomers Q1/Q2 | 2 | nos | 300.00 | 600 | 1 per inverter (max AC 133.7 A)
3 | Switch-disconnector 4P 400 A – Q3 roof isolator | 1 | nos | 500.00 | 500 | replaces 250 A MCCB + 250 A switch
4 | AC SPD Type 2, 3P+N, Uc 320 Vac, 40 kA (ACCP) | 1 | nos | 250.00 | 250
5 | Cable 4C × 50 mm² Cu XLPE (C1, C2 inverter → ACCP) | 15 | m | 25.00 | 375 | layout: C1 4.5 m + C2 2.3 m + drops/terminations
6 | Earth cable 25 mm² Cu (E1, E2 inverter → ACCP) | 15 | m | 4.00 | 60 | same route
7 | Cable 4C × 240 mm² Cu XLPE/SWA (C3 ACCP → MLVS) | 200 | m | 110.00 | 22000 | route length (confirm); VD ≈ 2.0 % at 232 A
8 | Earth cable 120 mm² Cu (E3 ACCP → MET) | 200 | m | 15.00 | 3000 | same route
9 | Cable ladder/tray 300 mm HDG (roof section) | 20 | m | 18.00 | 360 | roof ≈ 17.4 m; LV room cable provision available
10 | Cable glands, lugs, terminations (240 mm²) | 1 | lot | 350.00 | 350 | lot
11 | MLVS solar incomer: existing Masterpact NW10 H1 (no new breaker) | 0 | nos | 900.00 | 0 | existing breaker used – Ir set 400 A
12 | MLVS busbar connection & NW10 H1 setting / test | 1 | lot | 300.00 | 300
13 | Inverter station frame & sun-shade canopy (incl. DC units) | 2 | nos | 300.00 | 600 | 1 per inverter bay
 | Total (bottom-up) |  |  |  | 29395
 | Current BOQ allowance (lump sum) |  |  |  | 13140
 | Difference (bottom-up − allowance) |  |  |  | 16255
Rates in blue are estimates for new / upsized items – confirm with suppliers.
