mahilfernando/Tracker-Layout_Tororo-PV/solar-mezzanine-roof/report/Kampala_Marriott_PV_Workings.xlsx

Sheet: Summary
Kampala Marriott Hotel – Rooftop Solar PV: Summary of Workings
185.4 kWp grid-tied, zero-export, no battery · Mezzanine roof (D18102-DD-A-104) · All values link to the working sheets.
Item | Value | Unit | Sheet
System
Modules | 299 | nos | Layout
Module rating | 620 | Wp | Inputs
Plant capacity (DC) | 185.4 | kWp | Layout
Inverters | 2 × 80 kW |  | Inputs
Inverter capacity (AC) | 160 | kW | Electrical
DC/AC ratio | 1.16 |  | Electrical
Tilt | 10 | ° | Inputs
Tables (2P / 1P) | 6 / 1 |  | Layout
Energy
Year-1 generation | 274362.4 | kWh | Generation
Average monthly generation | 22863.53333 | kWh | Generation
Share of hotel consumption | 2.3% |  | Generation
Solar in shoulder period | 98.6% |  | TOU Impact
Solar in peak period | 1.4% |  | TOU Impact
Bill reduction (TOU rates) | 2.32% |  | TOU Impact
Value per solar kWh (TOU) | 0.120 | USD/kWh | TOU Impact
Cost & return
Budget EPC cost (excl. taxes) | 109278 | USD | BOQ
Specific cost | 0.589 | USD/Wp | BOQ
Mounting structure (Enerack, CIF Mombasa) | 11303.92 | USD | Structure
Year-1 savings | 32923.488 | USD | Financial
Simple payback | 3.4 | years | Financial
Project IRR | 30.1% |  | Financial
NPV (25 years) | 207407.7608 | USD | Financial
LCOE | 0.053 | USD/kWh | Financial
Checks
Row shading | OK |  | Layout
String voltages | OK |  | Electrical
Modules in strings = modules on roof | OK |  | Electrical
Colour code: yellow + blue = input · black = formula · green = link to another sheet.

Sheet: Inputs
Inputs & Assumptions – Kampala Marriott Rooftop PV
Yellow cells with blue text are inputs. Black = formula, green = link to another sheet. Change inputs here; all sheets update.
Parameter | Value | Unit | Source / note
Site
Project | Kampala Marriott Hotel – mezzanine roof |  | Client: Kampala Marriott Hotel
Latitude | 0.30315 | ° N | 0°18'11.34"N
Longitude | 32.58716 | ° E | 32°35'13.76"E
Time zone | 3 | UTC +h | East Africa Time
Day length | 12.1 | h | Near-constant at the equator
PV module (620 Wp bifacial TOPCon – confirm with selected datasheet)
Module power | 620 | Wp
Module length | 2382 | mm
Module width | 1134 | mm
Module weight | 33.0 | kg | Dual glass
Voc (STC) | 48.6 | V | Typical
Vmp (STC) | 40.6 | V | Typical
Isc (STC) | 16.1 | A | Typical
Imp (STC) | 15.3 | A | Typical
Temp. coefficient Voc | -0.25% | /°C | -0.25 %/°C
Temp. coefficient Vmp | -0.27% | /°C | -0.27 %/°C
Bifacial / irradiance current factor | 1.25 | × | IEC 62548 string current factor
Minimum cell temperature | 12 | °C | Kampala cool morning
Maximum cell temperature | 65 | °C | Hot roof, low tilt
Roof & layout (drawing D18102-DD-A-104, architect's solar zone only)
Roof inner width | 29264 | mm | Traced from drawing (29,390 dim.)
Upper block inner depth | 15717 | mm | Traced from drawing (15,805 dim.)
Lower block PV-zone depth | 22754 | mm | Joint to architect's PV limit
Tilt | 10 | °
Module clamp gap | 20 | mm
Aisle between tables | 800 | mm | Shading + maintenance walkway
Edge setback (west / north / south) | 1000 | mm
Edge setback (east) | 1742 | mm | Clear of roof opening
Inverters & stringing
Inverter AC rating | 80 | kW | Available sizes: 50/60/80/100/110/125 kW
Number of inverters | 2 | nos
Inverter max. DC voltage | 1100 | V
Inverter MPPT minimum voltage | 200 | V
AC voltage (line-line) | 400 | V
Power factor | 1.00
INV-01: strings (group A) | 8 | nos
INV-01: modules per string (group A) | 19 | nos
INV-01: strings (group B) | 0 | nos
INV-01: modules per string (group B) | 18 | nos
INV-02: strings (group A) | 3 | nos
INV-02: modules per string (group A) | 19 | nos
INV-02: strings (group B) | 5 | nos
INV-02: modules per string (group B) | 18 | nos
Cables & protection
DC string cable length (one way, avg.) | 40 | m | 6 mm² Cu PV cable
DC cable resistance (6 mm², 90 °C) | 3.950 | Ω/km
Inverter → ACCP cable length | 30 | m | 4C × 50 mm² Cu XLPE
Resistance 50 mm² Cu (90 °C) | 0.494 | Ω/km
ACCP → MLVS cable length | 80 | m | 4C × 120 mm² Cu XLPE/SWA (confirm route)
Resistance 120 mm² Cu (90 °C) | 0.196 | Ω/km
Reactance (AC cables) | 0.080 | Ω/km
Inverter outgoing MCCB rating | 125 | A | In ACCP
PV feeder MCCB rating | 250 | A | ACCP outgoing & MLVS PV way
Main incomer (existing) | 1000 | A | Schneider Masterpact NW10 H1, 65 kA
Switchboard fault level | 65 | kA | Masterpact NW10 H1 Icu
PV MCCB breaking capacity Icu | 70 | kA | e.g. NSX250 H
Energy & load
Specific yield, year 1 (incl. losses) | 1480 | kWh/kWp/yr | Desktop estimate, PR ≈ 0.80 – confirm with PVsyst
Degradation, year 1 | 1.0%
Degradation, year 2 onward | 0.4% | per yr
Hotel consumption | 1000000 | kWh/month | Client
Time-of-use tariff (Uganda ERA structure – replace with the bill's values)
Off-peak start / end | 0 | h | 00:00
Shoulder start | 6 | h | 06:00
Peak start | 18 | h | 18:00 – 24:00
Off-peak rate | 0.070 | USD/kWh | Indicative
Shoulder rate | 0.120 | USD/kWh | Indicative
Peak rate | 0.150 | USD/kWh | Indicative
Financial
Avoided tariff used in cash flow (year 1) | 0.120 | USD/kWh | Flat rate; TOU value per kWh shown on TOU sheet
Tariff escalation | 2.0% | per yr
Discount rate | 10.0%
O&M cost (% of capex, year 1) | 1.2% |  | Cleaning, inspection, monitoring
O&M escalation | 3.0% | per yr
Inverter replacement year | 12 | year
Contingency | 7.0%
EPC unit rates (2026 East Africa, ±15 %)
PV modules (landed, cleared) | 0.150 | USD/Wp
String inverter | 4800 | USD each | 80 kW, incl. comms
Mounting structure (incl. ballast, pads) | 0.090 | USD/Wp | Enerack quote within this allowance
DC system | 0.040 | USD/Wp | Cable, MC4, isolators, SPD
AC system (ACCP, MCCBs, 120 mm² cable, tray) | 9500 | USD | Lump sum
Use detailed breakdowns in BOQ (1 = yes, 0 = allowance) | 0 |  | DC System, AC System, Earthing & LPS and Roof Access & Safety sheets
Zero-export controller & monitoring | 3500 | USD | Lump sum
Earthing & lightning protection | 3000 | USD | Lump sum
Walkways, lifeline, water point | 3500 | USD | Lump sum
Installation, testing & commissioning | 0.060 | USD/Wp
Engineering & structural check | 4000 | USD | Lump sum
Approvals & utility interface | 2000 | USD | Lump sum
Transport, logistics & customs clearing | 4000 | USD | Lump sum

Sheet: Layout
Layout & Row-Spacing Working
Tables are 2 modules high in portrait (2P) or 1 module high (1P).
Item | Value | Unit | Working
Table geometry
2P slope length | 4784 | mm | 2 × module length + gap
2P table depth on plan | 4711.32029 | mm | slope × cos(tilt)
2P rise (rear above front) | 830.732882 | mm | slope × sin(tilt)
1P table depth on plan | 2345.812068 | mm
1P rise | 413.6299592 | mm
Modules per row | 23 | nos | fits between setbacks
Row length (modules) | 26522 | mm
Upper block
Available depth | 13717 | mm | depth − 2 setbacks
2P tables | 2 | nos
Depth left after 2P tables | 3494.359419 | mm
1P tables | 1 | nos | one 1P row if it fits
Modules | 115 | nos
Lower block (to architect's PV limit)
Available depth | 21754 | mm | setback at top only
2P tables | 4 | nos
Depth left after 2P tables | 508.7188384 | mm
1P tables | 0 | nos
Modules | 184 | nos
Totals
2P tables (total) | 6 | nos
1P tables (total) | 1 | nos
Total modules | 299 | nos
Plant capacity (DC) | 185.38 | kWp
Module area | 807.655212 | m²
Module weight (total) | 9.9 | t
Row-to-row shading check (panels facing the equator, no shading 09:00–15:00 all year)
Sun position | Declination (°) | Hour angle (°) | Elevation (°) | N-S component | Shadow gap needed (mm)
21 Dec, 09:00 / 15:00 | -23.45 | 45 | 40.3 | 0.401 | 515.6828397
21 Dec, 12:00 | -23.45 | 0 | 66.2 | 0.403 | 365.5857322
21 Jun, 09:00 / 15:00 | 23.45 | 45 | 40.6 | -0.395 | 0
21 Jun, 12:00 | 23.45 | 0 | 66.9 | -0.393 | 0
Largest shadow gap needed | 515.6828397 | mm | worst case of the rows above
Aisle provided | 800 | mm
Shading check | OK

Sheet: Electrical
Electrical Working – Strings, Inverters, Cables, Protection
Item | Value | Unit | Working
Module voltages at temperature extremes
Voc at minimum cell temperature | 50.18 | V | Voc × (1 + k × (Tmin − 25))
Vmp at maximum cell temperature | 36.22 | V | Vmp × (1 + k × (Tmax − 25))
Max. modules per string | 21 | nos | inverter max DC ÷ Voc cold
Min. modules per string | 6 | nos | MPPT min ÷ Vmp hot
Design string current | 20.1 | A | Isc × factor
Inverter configuration
 | INV-01 | INV-02 | Total
Strings | 8 | 8 | 16
Modules | 152 | 147 | 299
DC capacity (kWp) | 94.24 | 91.14 | 185.38
AC rating (kW) | 80 | 80 | 160
DC/AC ratio | 1.18 | 1.14 | 1.16
Longest string Voc cold (V) | 953.4105 | 953.4105 | 953.4105
Shortest string Vmp hot (V) | 688.0888 | 651.8736 | 651.8736
AC current at rated output (A) | 115.5 | 115.5 | 230.9
Checks
Modules in strings = modules on roof | OK
String Voc cold ≤ inverter max DC | OK
String Vmp hot ≥ MPPT minimum | OK
DC/AC ratio between 1.0 and 1.35 | OK
Inverter MCCB ≥ inverter current | OK
PV feeder MCCB ≥ total PV current | OK
PV MCCB Icu ≥ switchboard fault level | OK
PV current ≤ 25 % of main incomer | OK
Voltage drop
DC string voltage (19 modules at Vmp STC) | 771.4 | V
DC voltage drop | 4.83 | V | 2 × L × Imp × R
DC voltage drop | 0.63% | % | target ≤ 1.5 %
AC drop inverter → ACCP | 0.74% | % | √3·I·L·(R cosφ + X sinφ) / V
AC drop ACCP → MLVS | 1.57% | %
Total AC voltage drop | 2.31% | % | target ≤ 3 %
Voltage-drop check | OK

Sheet: Structure
Mounting Structure – Enerack Ballast System (supplier quote as issued)
Xiamen Enerack Technology Co., Ltd. · Invoice/quote ERKI20261104TP dated 2026-11-04 · Drawing EPJ-26110401 V1.0 · Panel 2382×1134×30 mm
Item No. | Description | Qty | Unit | Unit price EXW (USD) | Amount EXW (USD)
ERK-R80-3000 | R80 Rail L=3000 | 256 | kits | 16.64 | 4258.56
ERK-R80-2630 | R80 Rail L=2630 | 32 | kits | 14.58 | 466.67
ERK-SFR-R80 | Rail connect | 256 | kits | 1.19 | 304.64
ERK-GRC | Rail clamp | 795 | kits | 0.22 | 178.59
ERK-FEC-30 | 30 mm end clamp | 65 | kits | 0.30 | 19.47
ERK-AIC | Adjustable (30-40 mm) inner clamp | 707 | kits | 0.30 | 212.10
ERK-W45-3800 | Pre-assembly L=3800 (2P frame) | 77 | kits | 40.40 | 3110.80
ERK-W45-1400 | Pre-assembly L=1400 (1P frame) | 22 | kits | 20.64 | 454.08
ERK-35JL-2725 | Cross L=2725 | 140 | kits | 6.85 | 958.77
ERK-M8X70 | M8×70 bolt | 155 | kits | 0.20 | 31.00
ERK-ELG-03 | Earthing lug | 33 | kits | 0.28 | 9.24
 | Sub-total EXW | 2538 |  |  | 10003.92
 | Freight cost to Mombasa Port, Kenya |  |  |  | 1300.00
 | Total CIF Mombasa |  |  |  | 11303.92
Quote terms: 30 % T/T deposit, balance before shipment · Port of destination Mombasa · Delivery 10–15 days after deposit · CIF excludes import clearance, customs duties and VAT.
Line amounts are as printed on the supplier's quote (some differ from qty × unit price by a few cents due to the supplier's rounding).
Quote scope vs. current layout
 | Item | Quoted | Current layout | Difference
 | 2P frames (L=3800) | 77 | 66 | 11
 | 1P frames (L=1400) | 22 | 11 | 11
 | Rail lines (R80 L=2630, 1 per line) | 32 | 26 | 6
 | Modules supported | 368 | 299 | 69
The quote covers 7 × 2P + 2 × 1P tables (368 modules); the current layout uses 6 × 2P + 1 × 1P (299 modules). Value kept as quoted – confirm final quantities with Enerack.
Structure cost per Wp of current plant (CIF) | 0.061 | USD/Wp
Roof load – modules + structure (excl. ballast) | 16.6 | kg/m² | 4.5 kg/m² structure allowance; ballast per Enerack calculation

Sheet: Generation
Estimated PV Solar Generation
Monthly shape from typical Kampala irradiation (approx.); annual total = kWp × specific yield. Replace column C with PVGIS/PVsyst values when available.
Plant capacity | 185.38 | kWp
Year-1 generation | 274362.4 | kWh | kWp × specific yield
Hotel consumption | 12000000 | kWh/yr
Share of hotel consumption | 2.29%
Month | Days | GHI (kWh/m²/day) | Weight | Share | Generation (kWh) | Generation (MWh) | kWh/day
Jan | 31 | 5.40 | 167.4 | 9.2% | 25142.75237 | 25.1 | 811.0565282
Feb | 28 | 5.60 | 156.8 | 8.6% | 23550.67845 | 23.6 | 841.0956588
Mar | 31 | 5.40 | 167.4 | 9.2% | 25142.75237 | 25.1 | 811.0565282
Apr | 30 | 5.00 | 150.0 | 8.2% | 22529.348 | 22.5 | 750.9782668
May | 31 | 4.70 | 145.7 | 8.0% | 21883.5067 | 21.9 | 705.9195708
Jun | 30 | 4.60 | 138.0 | 7.6% | 20727.00016 | 20.7 | 690.9000055
Jul | 31 | 4.50 | 139.5 | 7.6% | 20952.29364 | 21.0 | 675.8804401
Aug | 31 | 4.80 | 148.8 | 8.1% | 22349.11322 | 22.3 | 720.9391361
Sep | 30 | 5.10 | 153.0 | 8.4% | 22979.93496 | 23.0 | 765.9978322
Oct | 31 | 5.00 | 155.0 | 8.5% | 23280.32627 | 23.3 | 750.9782668
Nov | 30 | 4.90 | 147.0 | 8.0% | 22078.76104 | 22.1 | 735.9587015
Dec | 31 | 5.10 | 158.1 | 8.7% | 23745.9328 | 23.7 | 765.9978322
Year | 365 | 5.00 | 1826.7 | 100.0% | 274362.4 | 274.4 | 751.6778082
Monthly average |  |  |  |  | 22863.53333 | 22.9

Sheet: TOU Impact
Solar Impact on Time-of-Use Tariff – Average Day
Solar: sine profile between sunrise and sunset at the site (formula). Load: hotel hourly profile (edit column F).
Solar noon (EAT) | 12.88 | h | longitude correction + equation-of-time avg
Sunrise | 6.83 | h
Sunset | 18.93 | h
Solar per average day | 751.6778082 | kWh/day
Hotel load per average day | 32876.71233 | kWh/day
Hour | Period | Rate (USD/kWh) | Sun-up from | Sun-up to | Load profile factor | Solar share | Solar (kWh) | Hotel load (kWh) | Grid after solar (kWh)
00:00 | Off-peak | 0.070 | 6.83 | 1.00 | 0.75 | 0.00% | 0.0 | 978.0854521 | 978.0854521
01:00 | Off-peak | 0.070 | 6.83 | 2.00 | 0.72 | 0.00% | 0.0 | 938.962034 | 938.962034
02:00 | Off-peak | 0.070 | 6.83 | 3.00 | 0.70 | 0.00% | 0.0 | 912.8797553 | 912.8797553
03:00 | Off-peak | 0.070 | 6.83 | 4.00 | 0.70 | 0.00% | 0.0 | 912.8797553 | 912.8797553
04:00 | Off-peak | 0.070 | 6.83 | 5.00 | 0.72 | 0.00% | 0.0 | 938.962034 | 938.962034
05:00 | Off-peak | 0.070 | 6.83 | 6.00 | 0.80 | 0.00% | 0.0 | 1043.291149 | 1043.291149
06:00 | Shoulder | 0.120 | 6.83 | 7.00 | 0.95 | 0.05% | 0.4 | 1238.908239 | 1238.531455
07:00 | Shoulder | 0.120 | 7.00 | 8.00 | 1.10 | 2.25% | 16.9 | 1434.52533 | 1417.621736
08:00 | Shoulder | 0.120 | 8.00 | 9.00 | 1.20 | 5.45% | 40.9 | 1564.936723 | 1523.997914
09:00 | Shoulder | 0.120 | 9.00 | 10.00 | 1.25 | 8.28% | 62.2 | 1630.14242 | 1567.912643
10:00 | Shoulder | 0.120 | 10.00 | 11.00 | 1.28 | 10.56% | 79.3 | 1669.265838 | 1589.916535
11:00 | Shoulder | 0.120 | 11.00 | 12.00 | 1.30 | 12.13% | 91.1 | 1695.348117 | 1604.1983
12:00 | Shoulder | 0.120 | 12.00 | 13.00 | 1.30 | 12.88% | 96.8 | 1695.348117 | 1598.507823
13:00 | Shoulder | 0.120 | 13.00 | 14.00 | 1.30 | 12.78% | 96.0 | 1695.348117 | 1599.308831
14:00 | Shoulder | 0.120 | 14.00 | 15.00 | 1.28 | 11.81% | 88.8 | 1669.265838 | 1580.465351
15:00 | Shoulder | 0.120 | 15.00 | 16.00 | 1.25 | 10.06% | 75.6 | 1630.14242 | 1554.533285
16:00 | Shoulder | 0.120 | 16.00 | 17.00 | 1.20 | 7.63% | 57.3 | 1564.936723 | 1507.58724
17:00 | Shoulder | 0.120 | 17.00 | 18.00 | 1.20 | 4.69% | 35.2 | 1564.936723 | 1529.691193
18:00 | Peak | 0.150 | 18.00 | 18.93 | 1.25 | 1.44% | 10.8 | 1630.14242 | 1619.296911
19:00 | Peak | 0.150 | 19.00 | 18.93 | 1.20 | 0.00% | 0.0 | 1564.936723 | 1564.936723
20:00 | Peak | 0.150 | 20.00 | 18.93 | 1.10 | 0.00% | 0.0 | 1434.52533 | 1434.52533
21:00 | Peak | 0.150 | 21.00 | 18.93 | 0.98 | 0.00% | 0.0 | 1278.031657 | 1278.031657
22:00 | Peak | 0.150 | 22.00 | 18.93 | 0.88 | 0.00% | 0.0 | 1147.620264 | 1147.620264
23:00 | Peak | 0.150 | 23.00 | 18.93 | 0.80 | 0.00% | 0.0 | 1043.291149 | 1043.291149
Day total |  |  |  |  | 25.21 | 100.0% | 751.6778082 | 32876.71233 | 32125.03452
Period | Rate (USD/kWh) | Hotel use (MWh/yr) | Solar (MWh/yr) | Share of solar | Grid after solar (MWh/yr) | Reduction | Cost before (USD/yr) | Cost after (USD/yr) | Saving (USD/yr)
Off-peak | 0.070 | 2089.646965 | 0.0 | 0.0% | 2089.646965 | 0.00% | 146275.2876 | 146275.2876 | 0
Shoulder | 0.120 | 6954.383181 | 270.4 | 98.6% | 6683.979392 | 3.89% | 834525.9818 | 802077.5271 | 32448.4547
Peak | 0.150 | 2955.969853 | 4.0 | 1.4% | 2952.011242 | 0.13% | 443395.478 | 442801.6864 | 593.7916211
Total |  | 12000 | 274.4 | 100.0% | 11725.6376 | 2.29% | 1424196.747 | 1391154.501 | 33042.24632
Bill reduction |  |  |  |  |  |  |  |  | 2.32%
Value per solar kWh (USD) |  |  |  |  |  |  |  |  | 0.120

Sheet: DC System
DC System – Bottom-up Breakdown
PV strings to inverter DC inputs. Quantities from Inputs (strings, cable run) and Layout (tables).
No. | Item | Quantity | Unit | Rate (USD) | Amount (USD) | Quantity working
1 | PV cable 6 mm² H1Z2Z2-K (red + black), UV-resistant | 1590 | m | 1.30 | 2067 | strings × (2 × one-way run + 10 m row links) × 1.10 waste
2 | MC4 connector pairs (genuine, 1,500 V) | 71 | pairs | 4.00 | 284 | 4 pairs per string + 10 % spares
3 | String DC isolator 1,000 V, 32 A, IP66 (at array) | 16 | nos | 45.00 | 720 | 1 per string
4 | DC SPD Type II | 0 | nos | 150.00 | 0 | 0 – built into inverters (enter qty if external SPDs required)
5 | Cable tray, HDG perforated 100 mm with UV cover | 145 | m | 14.00 | 2030 | 15 m per table + 40 m main run to inverters
6 | Tray supports / non-penetrating roof blocks & fixings | 1 | lot | 450.00 | 450 | lot
7 | Flexible conduit, glands & entry fittings | 1 | lot | 250.00 | 250 | lot
8 | UV-resistant cable ties, module cable clips | 1 | lot | 150.00 | 150 | lot
9 | String labels & DC warning signage | 1 | lot | 120.00 | 120 | lot
 | Total (bottom-up) |  |  |  | 6071
 | Current BOQ allowance (USD/Wp × Wp) |  |  |  | 7415
 | Difference (bottom-up − allowance) |  |  |  | -1344
 | Bottom-up cost per Wp |  |  |  | 0.033
Rates are indicative landed Kampala prices (2026), excluding VAT – replace with supplier quotes. Yellow + blue = input · black = formula · green = link to another sheet.

Sheet: AC System
AC System – Bottom-up Breakdown
Inverter AC outputs to the main LV switchboard. Lengths from Inputs (30 m and 80 m runs).
No. | Item | Quantity | Unit | Rate (USD) | Amount (USD) | Quantity working
1 | ACCP enclosure IP65, 250 A busbar, wiring, assembly | 1 | nos | 900.00 | 900 | AC combiner panel on the roof
2 | MCCB 125 A 3P, Icu ≥ 36 kA (inverter incomers) | 2 | nos | 220.00 | 440 | 1 per inverter
3 | MCCB 250 A 3P (ACCP outgoing) | 1 | nos | 450.00 | 450
4 | SPD Type II, 3P+N, 400 V (ACCP) | 1 | nos | 250.00 | 250
5 | Switch-disconnector 250 A (roof isolator) | 1 | nos | 350.00 | 350
6 | Cable 4C × 50 mm² Cu XLPE (inverter → ACCP) | 60 | m | 25.00 | 1500 | inverters × run length
7 | Earth cable 25 mm² Cu (inverter → ACCP) | 60 | m | 4.00 | 240 | same route
8 | Cable 4C × 120 mm² Cu XLPE/SWA (ACCP → MLVS) | 80 | m | 60.00 | 4800 | route length (confirm)
9 | Earth cable 70 mm² Cu (ACCP → MLVS) | 80 | m | 9.00 | 720 | same route
10 | Cable ladder/tray 300 mm HDG incl. riser supports | 80 | m | 18.00 | 1440 | main route roof → LV room
11 | Cable glands, lugs, terminations | 1 | lot | 250.00 | 250 | lot
12 | MLVS PV way: MCCB 250 A, Icu ≥ 65 kA (e.g. NSX250 H) | 1 | nos | 900.00 | 900 | matches Masterpact NW10 H1 fault level
13 | MLVS busbar connection kit & panel modification | 1 | lot | 300.00 | 300
14 | Inverter mounting frames & sun-shade canopies | 2 | nos | 300.00 | 600 | 1 per inverter
 | Total (bottom-up) |  |  |  | 13140
 | Current BOQ allowance (lump sum) |  |  |  | 9500
 | Difference (bottom-up − allowance) |  |  |  | 3640
 | Bottom-up cost per Wp |  |  |  | 0.071
Rates are indicative landed Kampala prices (2026), excluding VAT – replace with supplier quotes. Yellow + blue = input · black = formula · green = link to another sheet.

Sheet: Earthing & LPS
Earthing & Lightning Protection – Bottom-up Breakdown
Equipotential bonding of the array, connection to building earth and existing lightning protection (IEC 62305, IEC 60364-7-712).
No. | Item | Quantity | Unit | Rate (USD) | Amount (USD) | Quantity working
1 | Bonding conductor 16 mm² Cu, green/yellow, UV-resistant (along each table) | 200 | m | 2.50 | 500 | 1 run per table (row length + 1 m)
2 | Main PV earth conductor 35 mm² Cu (array spine → building earth bar) | 80 | m | 5.00 | 400 | follows the main cable route to the LV room
3 | Bimetallic (Al–Cu) bonding clamps / lugs on rails & frames | 90 | nos | 3.00 | 270 | 4 per table + 1 every 3 m of bonding run (Enerack lugs in structure quote)
4 | Inverter & ACCP earth bonding (16 mm² Cu + lugs) | 3 | sets | 25.00 | 75 | 1 per inverter + ACCP earth bar
5 | Air-termination rods 1 m with concrete bases (array perimeter) | 6 | nos | 80.00 | 480 | only if the array is outside the existing LPS protection zone
6 | Connection to existing LPS: clamps, test joints, separation-distance fittings | 1 | lot | 250.00 | 250 | IEC 62305 tie-in
7 | Earth pit: 1.5 m Cu-bonded rod + inspection chamber (if required) | 1 | nos | 350.00 | 350 | only if the building earth is inadequate
8 | Earth resistance testing & LPS risk assessment (IEC 62305-2) | 1 | lot | 300.00 | 300 | before and after installation
9 | Earthing labels & warning signs | 1 | lot | 50.00 | 50 | lot
 | Total (bottom-up) |  |  |  | 2675
 | Current BOQ allowance (lump sum) |  |  |  | 3000
 | Difference (bottom-up − allowance) |  |  |  | -325
 | Bottom-up cost per Wp |  |  |  | 0.014
Rates are indicative landed Kampala prices (2026), excluding VAT – replace with supplier quotes. Yellow + blue = input · black = formula · green = link to another sheet.

Sheet: Roof Access & Safety
Roof Walkways, Safety Lifeline & Water Point – Bottom-up Breakdown
Safe access for installation, cleaning and O&M; protection of the roof waterproofing.
No. | Item | Quantity | Unit | Rate (USD) | Amount (USD) | Quantity working
1 | Walkway pads, rubber/GRP 600 mm wide (roof door → station → east corridor) | 49 | m | 15.00 | 735 | length of both PV blocks + 10 m access; protects waterproofing on the main route
2 | Walkway pads in front of inverter station (service area) | 5 | m² | 25.00 | 125 | 1 m clearance zone in front of INV-01/02 and ACCP
3 | Deadweight (ballasted) fall-arrest anchor, non-penetrating | 2 | nos | 800.00 | 1600 | needed only if parapet < 1.1 m; one per PV block, EN 795 type E
4 | Harness + 2 m energy-absorbing lanyard kit | 2 | sets | 150.00 | 300 | for O&M staff
5 | Water supply pipe HDPE 25 mm to roof | 40 | m | 3.00 | 120 | from nearest hotel water point (route TBC)
6 | Tap, isolation valve, backflow preventer, hose reel 30 m | 1 | set | 280.00 | 280 | for module cleaning (soft water / no detergents)
7 | Roof access & PV hazard signage | 1 | lot | 80.00 | 80 | roof door, station, DC warning
 | Total (bottom-up) |  |  |  | 3240
 | Current BOQ allowance (lump sum) |  |  |  | 3500
 | Difference (bottom-up − allowance) |  |  |  | -260
 | Bottom-up cost per Wp |  |  |  | 0.017
Rates are indicative landed Kampala prices (2026), excluding VAT – replace with supplier quotes. Yellow + blue = input · black = formula · green = link to another sheet.

Sheet: BOQ
Cost Estimate – Bill of Quantities (USD, excluding taxes)
No. | Description | Quantity | Unit | Rate (USD) | Amount (USD)
1 | PV modules, 620 Wp bifacial TOPCon (landed, cleared) | 185380 | Wp | 0.150 | 27807
2 | String inverters, 80 kW, 1,100 V, multi-MPPT | 2 | nos | 4800 | 9600
3 | Mounting structure, 10° ballasted, incl. pads | 185380 | Wp | 0.090 | 16684
4 | DC system: PV cable, MC4, isolators, SPD | 185380 | Wp | 0.040 | 7415
5 | AC system: ACCP, MCCBs, 4C×120 mm² cable, tray | 1 | lot | 9500 | 9500
6 | Zero-export controller, CTs, data logger | 1 | set | 3500 | 3500
7 | Earthing, bonding & lightning protection | 1 | lot | 3000 | 3000
8 | Roof walkways, safety lifeline, water point | 1 | lot | 3500 | 3500
9 | Installation, testing & commissioning | 185380 | Wp | 0.060 | 11123
10 | Engineering: design, structural check, PVsyst | 1 | lot | 4000 | 4000
11 | Approvals & utility interface (ERA / UEDCL) | 1 | lot | 2000 | 2000
12 | Transport, logistics & customs clearing | 1 | lot | 4000 | 4000
 | Sub-total |  |  |  | 102129
 | Contingency |  |  | 7.0% | 7149
 | Total budget EPC cost (excluding taxes) |  |  |  | 109278
 | Specific cost |  | USD/Wp |  | 0.589
 | Annual O&M, year 1 |  |  |  | 1311

Sheet: Financial
Financial Analysis – 25-Year Cash Flow (USD)
Savings use the flat avoided tariff on Inputs; see the TOU sheet for value by tariff period.
Year | Generation (kWh) | Tariff (USD/kWh) | Savings | O&M | Inverter replacement | Net cash flow | Cumulative | Discount factor | Disc. cash flow | Disc. generation | Disc. costs (O&M + repl.)
0 |  |  |  |  |  | -109278 | -109278 | 1.0000 | -109278
1 | 274362.4 | 0.120 | 32923.488 | 1311 | 0 | 31612.488 | -77665.512 | 0.9091 | 28738.62545 | 249420.3636 | 1191.818182
2 | 270532.3009 | 0.122 | 33113.15363 | 1350.33 | 0 | 31762.82363 | -45902.68837 | 0.8264 | 26250.26746 | 223580.414 | 1115.975207
3 | 269450.1717 | 0.125 | 33640.31504 | 1390.8399 | 0 | 32249.47514 | -13653.21323 | 0.7513 | 24229.50799 | 202441.9021 | 1044.958603
4 | 268372.371 | 0.127 | 34175.86885 | 1432.565097 | 0 | 32743.30375 | 19090.09052 | 0.6830 | 22364.11704 | 183301.9404 | 978.4612369
5 | 267298.8815 | 0.130 | 34719.94868 | 1475.54205 | 0 | 33244.40663 | 52334.49715 | 0.6209 | 20642.16095 | 165971.5752 | 916.1955219
6 | 266229.686 | 0.132 | 35272.69027 | 1519.808311 | 0 | 33752.88195 | 86087.37911 | 0.5645 | 19052.62193 | 150279.7172 | 857.8921705
7 | 265164.7673 | 0.135 | 35834.23149 | 1565.402561 | 0 | 34268.82893 | 120356.208 | 0.5132 | 17585.32777 | 136071.453 | 803.2990323
8 | 264104.1082 | 0.138 | 36404.71246 | 1612.364638 | 0 | 34792.34782 | 155148.5559 | 0.4665 | 16230.88703 | 123206.5156 | 752.180003
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
NPV at discount rate | 207407.7608 | USD
LCOE | 0.053 | USD/kWh
25-year generation | 6477.049807 | MWh
25-year net savings (before capex) | 934238.7322 | USD
LCOE = (capex + discounted O&M and replacement) ÷ discounted generation. Payback interpolated within the year it turns positive.

Sheet: Sensitivity
Tariff Sensitivity
Each column recomputes the 25-year cash flow at a different avoided tariff (year 1).
Avoided tariff (USD/kWh) | Payback (yrs) | IRR | NPV (USD)
0.090 | 4.6 | 22.35481053% | 123694.2754
0.100 | 4.1 | 24.94561734% | 151598.7705
0.120 | 3.4 | 30.05762706% | 207407.7608
0.140 | 2.9 | 35.11901162% | 263216.7512
0.160 | 2.5 | 40.15543121% | 319025.7415
 |  |  |  | Tariff → | 0.090 | 0.100 | 0.120 | 0.140 | 0.160
 |  |  |  | Year | Cash flow @ F11 | Cash flow @ G11 | Cash flow @ H11 | Cash flow @ I11 | Cash flow @ J11 | Cumulative @ F11 | Cumulative @ G11 | Cumulative @ H11 | Cumulative @ I11 | Cumulative @ J11
 |  |  |  | 0 | -109278 | -109278 | -109278 | -109278 | -109278 | -109278 | -109278 | -109278 | -109278 | -109278
 |  |  |  | 1 | 23381.616 | 26125.24 | 31612.488 | 37099.736 | 42586.984 | -85896.384 | -83152.76 | -77665.512 | -72178.264 | -66691.016
 |  |  |  | 2 | 23484.53522 | 26243.96469 | 31762.82363 | 37281.68257 | 42800.54151 | -62411.84878 | -56908.79531 | -45902.68837 | -34896.58143 | -23890.47449
 |  |  |  | 3 | 23839.39638 | 26642.75596 | 32249.47514 | 37856.19431 | 43462.91348 | -38572.4524 | -30266.03935 | -13653.21323 | 2959.612876 | 19572.43899
 |  |  |  | 4 | 24199.33654 | 27047.32561 | 32743.30375 | 38439.2819 | 44135.26004 | -14373.11586 | -3218.713734 | 19090.09052 | 41398.89477 | 63707.69902
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
 |  |  |  | 25 | 33048.35296 | 37016.50251 | 44952.80163 | 52889.10075 | 60825.39987 | 577051.5252 | 659687.9276 | 824960.7322 | 990233.5368 | 1155506.341
