mahilfernando/Tracker-Layout_Tororo-PV/solar-mezzanine-roof/report/PV_Generation_Estimate.xlsx

Sheet: Inputs
Rooftop Solar PV – Estimated Generation Inputs
Kampala Marriott Hotel – mezzanine roof · 0°18'11.34"N, 32°35'13.76"E
Parameter | Value | Unit | Source / note
Number of modules | 299 | nos | Layout PV-LAY-D18102-002 (13 rows × 23)
Module rating | 620 | Wp | 620 Wp bifacial TOPCon, 2382 × 1134 mm
Plant capacity | 185.4 | kWp | Formula
Specific yield (year 1) | 1480 | kWh/kWp/yr | Desktop estimate incl. ≈0.80 performance ratio; confirm with PVsyst
Year-1 generation | 274362.4 | kWh | Formula
Degradation, year 1 | 1.0% |  | Typical TOPCon warranty
Degradation, year 2 onward | 0.4% | per year | Typical TOPCon warranty
Hotel consumption | 12000000 | kWh/yr | ≈1,000,000 kWh/month (client)
Share of hotel consumption | 2.3% |  | Formula
Legend: yellow cells with blue text are inputs you can change; black values are formulas.

Sheet: Monthly Generation
Estimated Monthly PV Generation – Year 1
Monthly shape from typical Kampala global horizontal irradiation (long-term climatology, approx.); annual total from Inputs!B8. PVGIS/NASA data could not be fetched – replace column C with PVGIS/PVsyst values when available.
Month | Days | GHI (kWh/m²/day) | Weight (GHI × days) | Share of year | Generation (kWh) | Generation (MWh) | Average (kWh/day)
Jan | 31 | 5.40 | 167.4 | 9.2% | 25142.75237 | 25.1 | 811.0565282
Feb | 28 | 5.60 | 156.8 | 8.6% | 23550.67845 | 23.6 | 841.0956588
Mar | 31 | 5.40 | 167.4 | 9.2% | 25142.75237 | 25.1 | 811.0565282
Apr | 30 | 5.00 | 150.0 | 8.2% | 22529.348 | 22.5 | 750.9782668
May | 31 | 4.70 | 145.7 | 8.0% | 21883.5067 | 21.9 | 705.9195708
Jun | 30 | 4.60 | 138.0 | 7.6% | 20727.00016 | 20.7 | 690.9000055
Jul | 31 | 4.50 | 139.5 | 7.6% | 20952.29364 | 21.0 | 675.8804401
Aug | 31 | 4.80 | 148.8 | 8.1% | 22349.11322 | 22.3 | 720.9391361
Sep | 30 | 5.10 | 153.0 | 8.4% | 22979.93496 | 23.0 | 765.9978322
Oct | 31 | 5.00 | 155.0 | 8.5% | 23280.32627 | 23.3 | 750.9782668
Nov | 30 | 4.90 | 147.0 | 8.0% | 22078.76104 | 22.1 | 735.9587015
Dec | 31 | 5.10 | 158.1 | 8.7% | 23745.9328 | 23.7 | 765.9978322
Year | 365 | 5.00 | 1826.7 | 100.0% | 274362.4 | 274.4 | 751.6778082
Monthly average |  |  |  |  | 22863.53333 | 22.9

Sheet: 25-Year Generation
Estimated Annual PV Generation – 25 Years
Year | Generation (kWh) | Generation (MWh) | Cumulative (MWh)
1 | 274362.4 | 274.4 | 274.3624
2 | 270532.3009 | 270.5 | 544.8947009
3 | 269450.1717 | 269.5 | 814.3448726
4 | 268372.371 | 268.4 | 1082.717244
5 | 267298.8815 | 267.3 | 1350.016125
6 | 266229.686 | 266.2 | 1616.245811
7 | 265164.7673 | 265.2 | 1881.410578
8 | 264104.1082 | 264.1 | 2145.514687
9 | 263047.6917 | 263.0 | 2408.562378
10 | 261995.501 | 262.0 | 2670.557879
11 | 260947.519 | 260.9 | 2931.505398
12 | 259903.7289 | 259.9 | 3191.409127
13 | 258864.114 | 258.9 | 3450.273241
14 | 257828.6575 | 257.8 | 3708.101899
15 | 256797.3429 | 256.8 | 3964.899242
16 | 255770.1535 | 255.8 | 4220.669395
17 | 254747.0729 | 254.7 | 4475.416468
18 | 253728.0846 | 253.7 | 4729.144553
19 | 252713.1723 | 252.7 | 4981.857725
20 | 251702.3196 | 251.7 | 5233.560045
21 | 250695.5103 | 250.7 | 5484.255555
22 | 249692.7283 | 249.7 | 5733.948283
23 | 248693.9574 | 248.7 | 5982.64224
24 | 247699.1815 | 247.7 | 6230.341422
25 | 246708.3848 | 246.7 | 6477.049807
Total | 6477049.807 | 6477.049807
Year 1 uses Inputs!B8; later years apply the year-1 loss plus the yearly rate (same basis as the report).

Sheet: TOU Impact
Solar Impact on Time-of-Use Tariff – Average Day
Bands per Uganda ERA TOU structure; rates indicative (USD/kWh) – replace with the hotel's bill. Hourly shares: solar from site sun times (sunrise ≈06:50, sunset ≈18:56); load from an assumed hotel profile.
Tariff period | Start hour | End hour | Rate (USD/kWh)
Off-peak | 0 | 6 | 0.070
Shoulder | 6 | 18 | 0.120
Peak | 18 | 24 | 0.150
Hour | Period | Solar share of day | Load share of day | Solar (kWh/day) | Hotel load (kWh/day) | Grid after solar (kWh/day) | Rate (USD/kWh)
00:00 | Off-peak | 0.00% | 2.97% | 0.0 | 978.0821918 | 978.0821918 | 0.070
01:00 | Off-peak | 0.00% | 2.86% | 0.0 | 938.9589041 | 938.9589041 | 0.070
02:00 | Off-peak | 0.00% | 2.78% | 0.0 | 912.8876712 | 912.8876712 | 0.070
03:00 | Off-peak | 0.00% | 2.78% | 0.0 | 912.8876712 | 912.8876712 | 0.070
04:00 | Off-peak | 0.00% | 2.86% | 0.0 | 938.9589041 | 938.9589041 | 0.070
05:00 | Off-peak | 0.00% | 3.17% | 0.0 | 1043.276712 | 1043.276712 | 0.070
06:00 | Shoulder | 0.05% | 3.77% | 0.3 | 1238.893151 | 1238.551889 | 0.120
07:00 | Shoulder | 2.22% | 4.36% | 16.7 | 1434.509589 | 1417.813322 | 0.120
08:00 | Shoulder | 5.42% | 4.76% | 40.7 | 1564.931507 | 1524.183805 | 0.120
09:00 | Shoulder | 8.26% | 4.96% | 62.1 | 1630.126027 | 1568.058487 | 0.120
10:00 | Shoulder | 10.54% | 5.08% | 79.2 | 1669.282192 | 1590.055351 | 0.120
11:00 | Shoulder | 12.12% | 5.16% | 91.1 | 1695.353425 | 1604.277886 | 0.120
12:00 | Shoulder | 12.88% | 5.16% | 96.8 | 1695.353425 | 1598.534316 | 0.120
13:00 | Shoulder | 12.78% | 5.16% | 96.1 | 1695.353425 | 1599.280732 | 0.120
14:00 | Shoulder | 11.83% | 5.08% | 88.9 | 1669.282192 | 1580.395539 | 0.120
15:00 | Shoulder | 10.08% | 4.96% | 75.7 | 1630.126027 | 1554.384716 | 0.120
16:00 | Shoulder | 7.65% | 4.76% | 57.5 | 1564.931507 | 1507.411618 | 0.120
17:00 | Shoulder | 4.71% | 4.76% | 35.4 | 1564.931507 | 1529.489898 | 0.120
18:00 | Peak | 1.47% | 4.96% | 11.0 | 1630.126027 | 1619.085384 | 0.150
19:00 | Peak | 0.00% | 4.76% | 0.0 | 1564.931507 | 1564.931507 | 0.150
20:00 | Peak | 0.00% | 4.36% | 0.0 | 1434.509589 | 1434.509589 | 0.150
21:00 | Peak | 0.00% | 3.89% | 0.0 | 1278.016438 | 1278.016438 | 0.150
22:00 | Peak | 0.00% | 3.49% | 0.0 | 1147.627397 | 1147.627397 | 0.150
23:00 | Peak | 0.00% | 3.17% | 0.0 | 1043.276712 | 1043.276712 | 0.150
Day total |  | 100.0% | 100.0% | 751.6770565 | 32876.6137 | 32124.93664
Period | Hotel use (MWh/yr) | Solar (MWh/yr) | Share of solar | Grid after solar (MWh/yr) | Reduction | Cost before (USD/yr) | Cost after (USD/yr) | Saving (USD/yr)
Off-peak | 2089.644 | 0.0 | 0.0% | 2089.644 | 0.00% | 146275.08 | 146275.08 | 0
Shoulder | 6954.372 | 270.3 | 98.5% | 6684.039709 | 3.89% | 834524.64 | 802084.7651 | 32439.87488
Peak | 2955.948 | 4.0 | 1.5% | 2951.918165 | 0.14% | 443392.2 | 442787.7248 | 604.4752397
Total | 11999.964 | 274.4 | 100.0% | 11725.60187 | 2.29% | 1424191.92 | 1391147.57 | 33044.35012
Bill reduction |  |  |  |  |  |  |  | 2.32%
Value per solar kWh (USD) |  |  |  |  |  |  |  | 0.120
