mahilfernando/Tracker-Layout_Tororo-PV/solar-mezzanine-roof/PV_Layout_10deg_Mezzanine_Roof.dxf

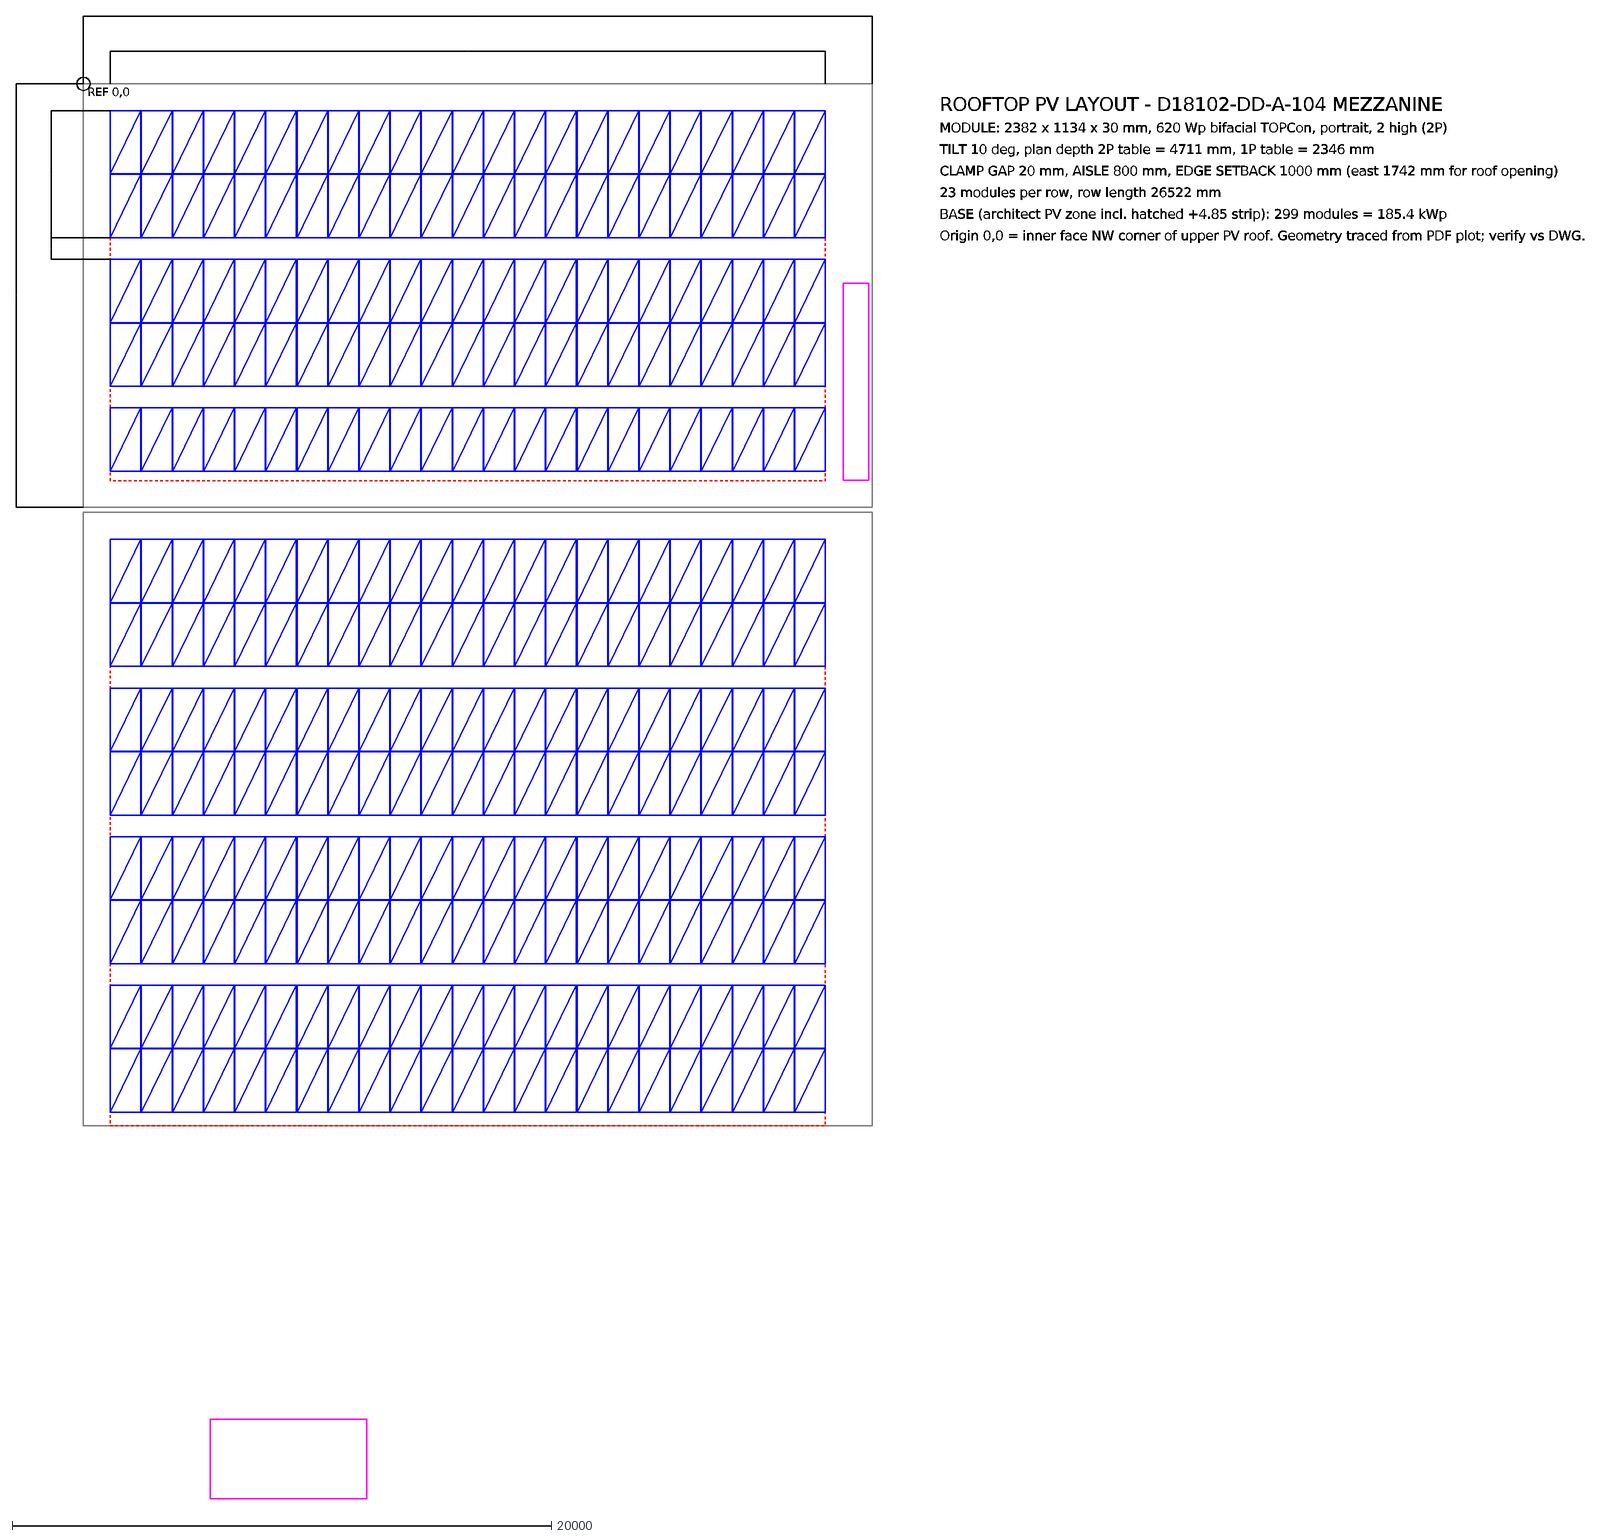
[picture p52: CAD file, 2026-11-04]
solar-mezzanine-roof/PV_Layout_10deg_Mezzanine_Roof.dxf
2926400
2652200
1571700
471132.03
80000
ROOFTOP PV LAYOUT - D18102-DD-A-104 MEZZANINE
MODULE: 2382 x 1134 x 30 mm, 620 Wp bifacial TOPCon, portrait, 2 high (2P)
TILT 10 deg, plan depth 2P table = 4711 mm, 1P table = 2346 mm
CLAMP GAP 20 mm, AISLE 800 mm, EDGE SETBACK 1000 mm (east 1742 mm for roof opening)
23 modules per row, row length 26522 mm
BASE (architect PV zone incl. hatched +4.85 strip): 299 modules = 185.4 kWp
Origin 0,0 = inner face NW corner of upper PV roof. Geometry traced from PDF plot; verify vs DWG.
REF 0,0
