mahilfernando/Tracker-Layout_Tororo-PV/(list of files, cad)

Other CAD files:
solar-mezzanine-roof/PV_Layout_Enerack_10deg.dxf
