mahilfernando/Tracker-Layout_Tororo-PV/solar-mezzanine-roof/PV_Layout_Enerack_10deg_CAD.pdf

## ROOFTOP PV LAYOUT – CAD PLOT (all layers)

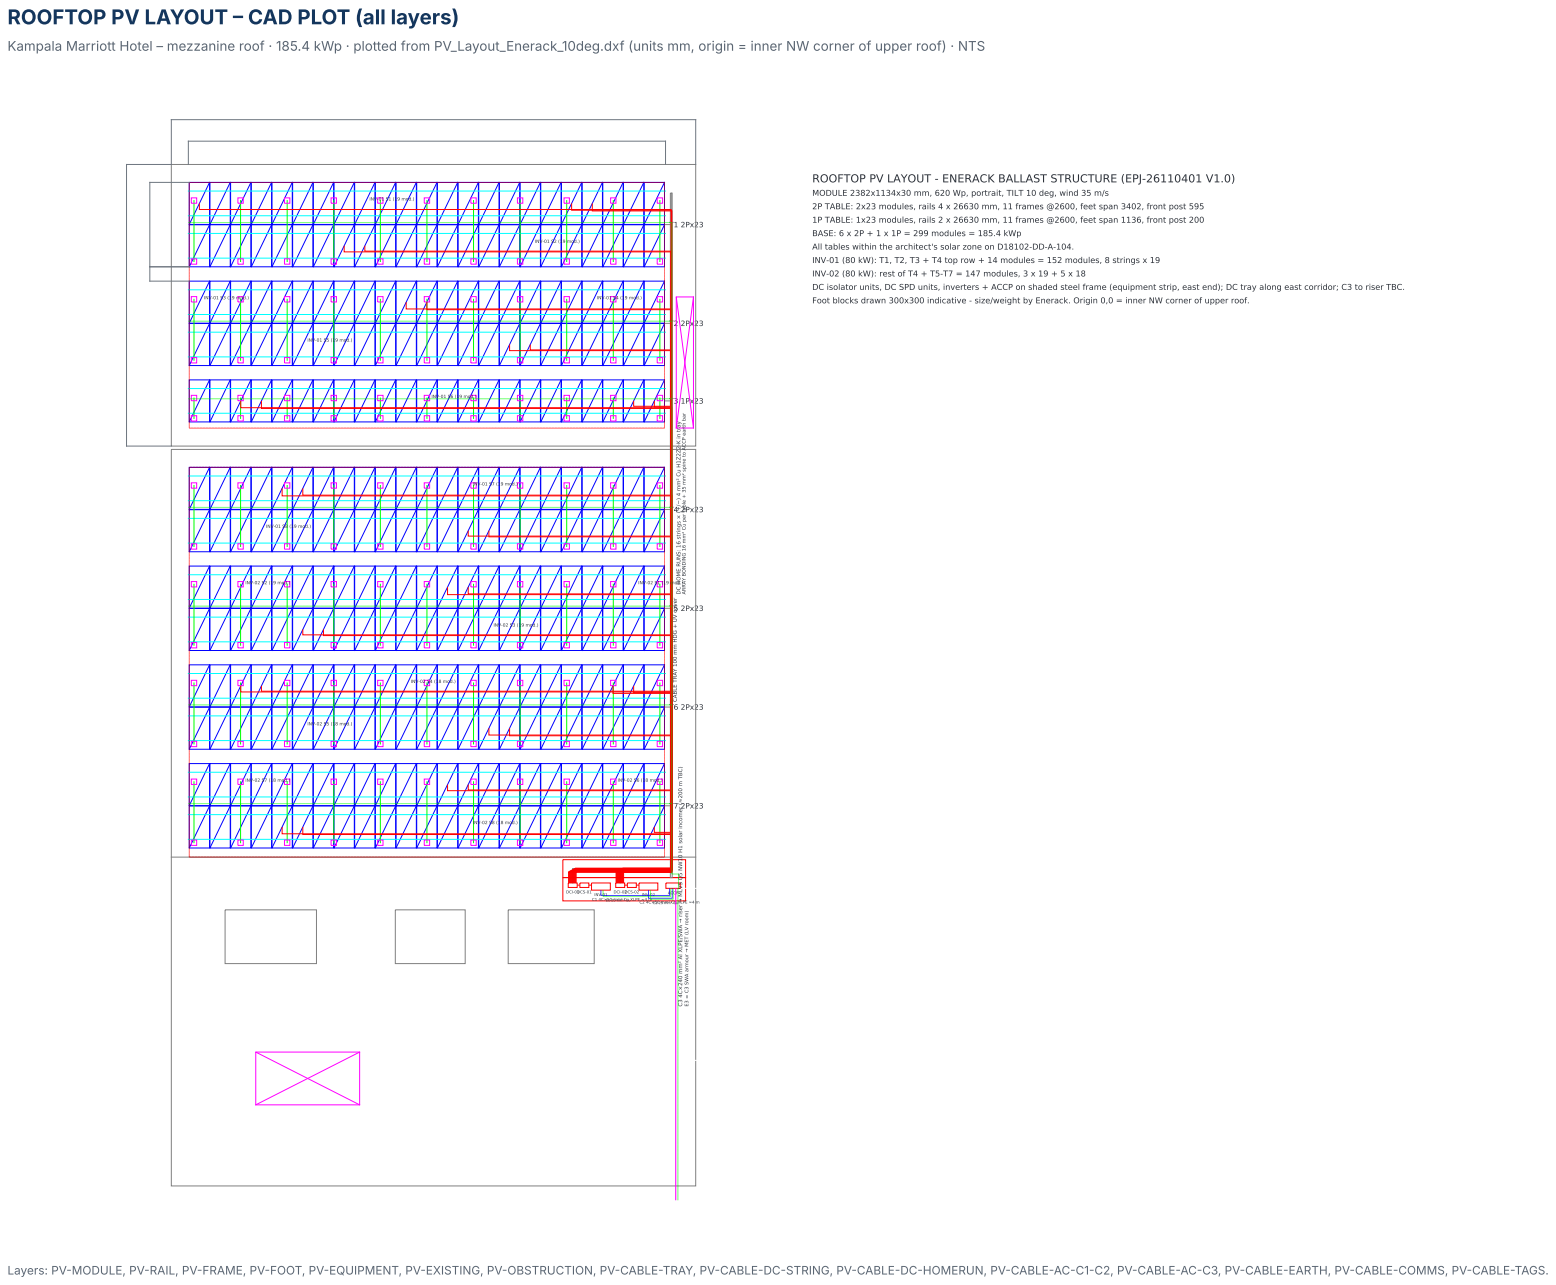
[picture p53: page 1]

Kampala Marriott Hotel – mezzanine roof · 185.4 kWp · plotted from PV_Layout_Enerack_10deg.dxf (units mm, origin = inner NW corner of upper roof) · NTS

Layers: PV-MODULE, PV-RAIL, PV-FRAME, PV-FOOT, PV-EQUIPMENT, PV-EXISTING, PV-OBSTRUCTION, PV-CABLE-TRAY, PV-CABLE-DC-STRING, PV-CABLE-DC-HOMERUN, PV-CABLE-AC-C1-C2, PV-CABLE-AC-C3, PV-CABLE-EARTH, PV-CABLE-COMMS, PV-CABLE-TAGS.

## CABLE LAYOUT – CAD PLOT (cable layers highlighted)

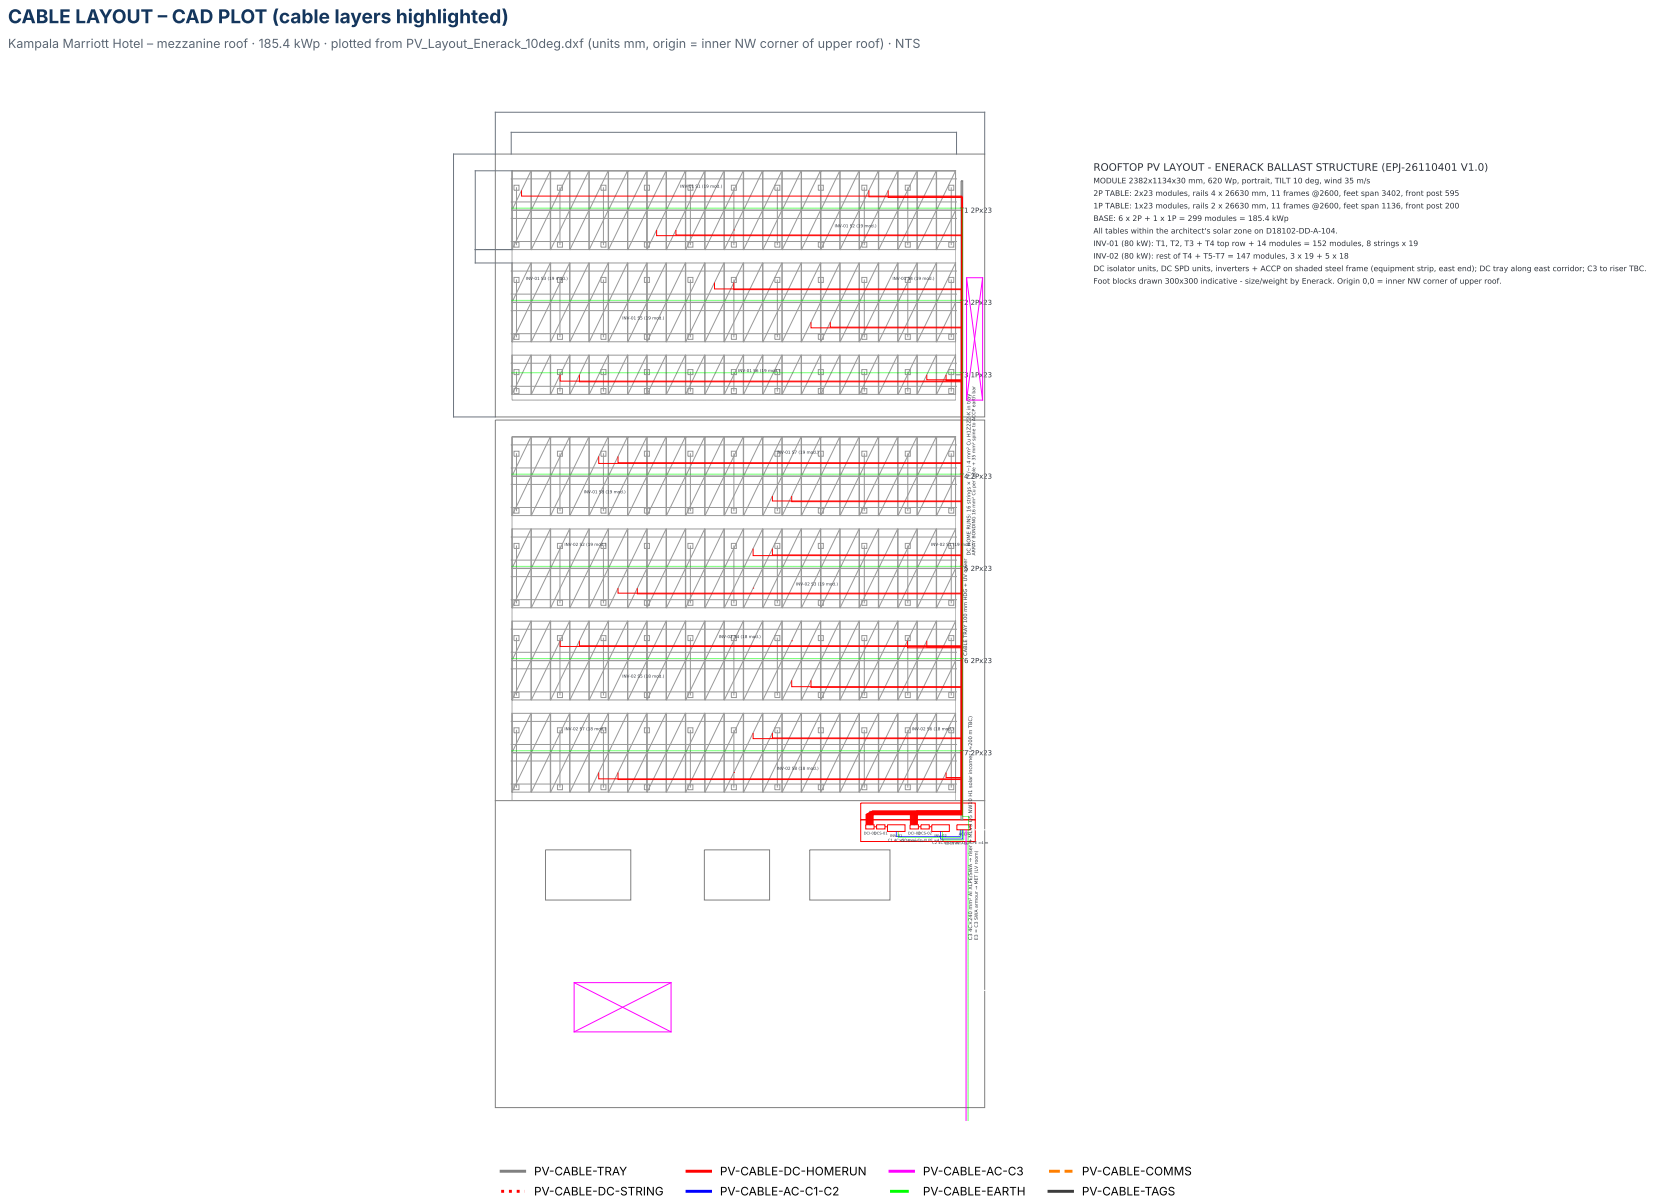
[picture p54: page 2]
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

PV-CABLE-TRAY
PV-CABLE-DC-STRING

PV-CABLE-DC-HOMERUN
PV-CABLE-AC-C1-C2

PV-CABLE-AC-C3
PV-CABLE-EARTH

PV-CABLE-COMMS
PV-CABLE-TAGS
