mahilfernando/Tracker-Layout_Tororo-PV/solar-mezzanine-roof/PV_Layout_Enerack_10deg.pdf

## PLAN – PV LAYOUT, INVERTERS & ACCP ON MEZZANINE ROOF (ENERACK BALLAST, 10° TILT)

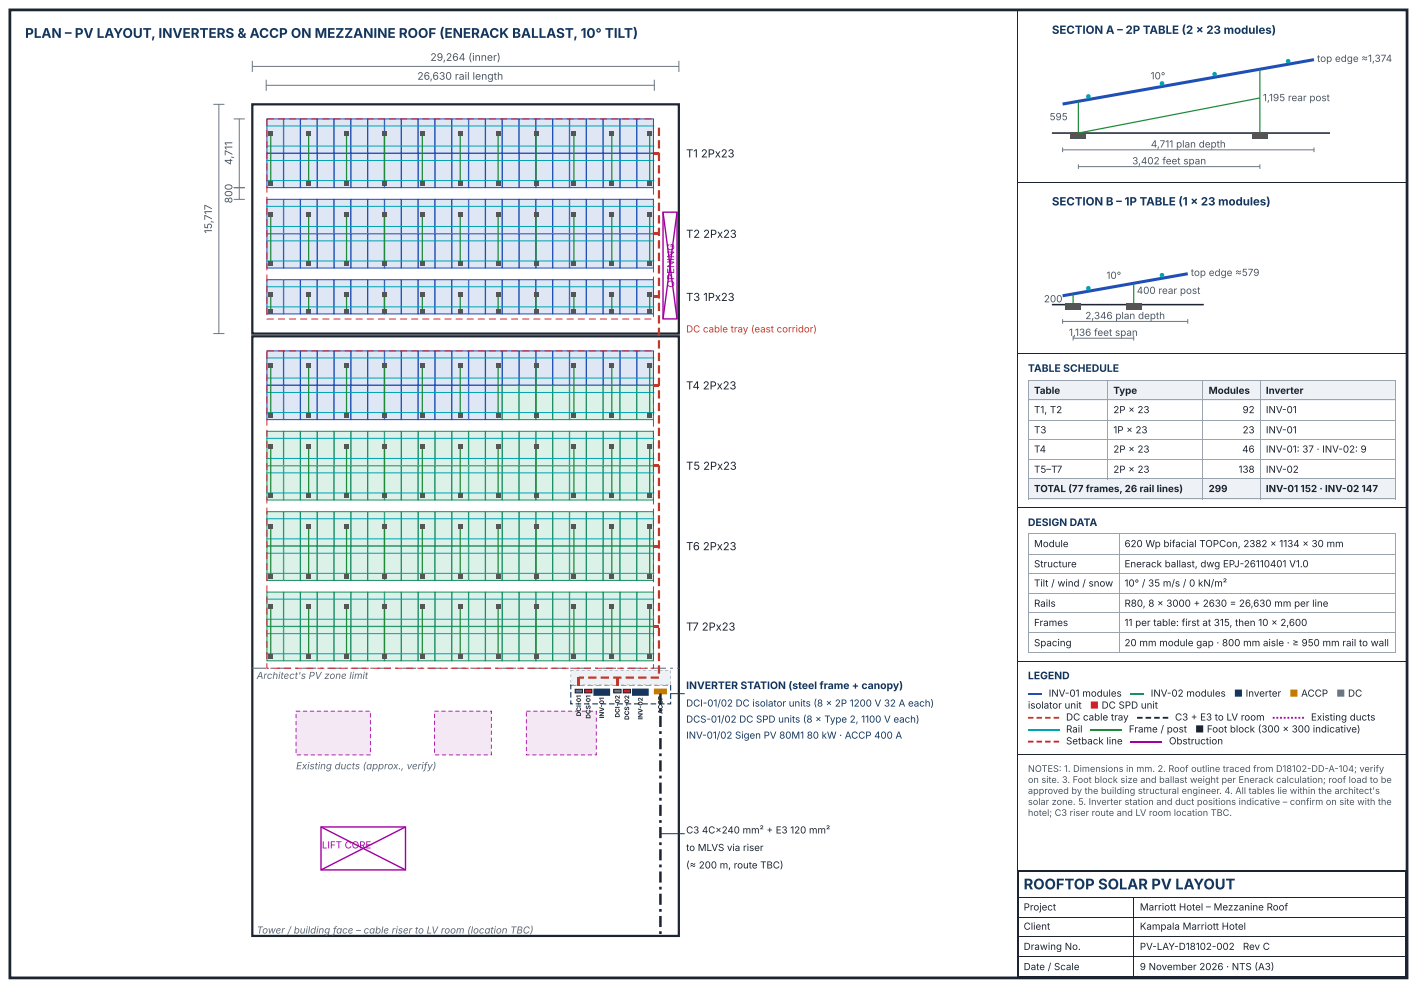
[picture p55: page 1]
DCI-01; DCS-01; INV-01; DCI-02; DCS-02; INV-02; ACCP; 29,264 (inner); 26,630 rail length; OPENIN; LIFT CORE; 4,711 plan depth; 3,402 feet span; 1,195 rear post; top edge ≈1,374; SECTION A –; 2P TABLE (2 × 23 modules); 2,346 plan depth; 1,136 feet span; 400 rear post; top edge ≈579; SECTION B –; 1P TABLE (1 × 23 modules); TABLE SCHEDULE; DESIGN DATA; INV-01 modules; INV-02 modules ■ Inverter ■ ACCP ■ DC; DC cable tray; C3 + E3 to LV room; Existing ducts; Rail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

DC cable tray (east corridor)

Table | Type | Modules | Inverter
T1, T2 | 2P × 23 | 92 | INV-01
T3 | 1P × 23 | 23 | INV-01
T4 | 2P × 23 | 46 | INV-01: 37 · INV-02: 9
T5–T7 | 2P × 23 | 138 | INV-02
TOTAL (77 frames, 26 rail lines) | | 299 | INV-01 152 · INV-02 147

Module | 620 Wp bifacial TOPCon, 2382 × 1134 × 30 mm
Structure | Enerack ballast, dwg EPJ-26110401 V1.0
Tilt / wind / snow | 10° / 35 m/s / 0 kN/m²
Rails | R80, 8 × 3000 + 2630 = 26,630 mm per line
Frames | 11 per table: first at 315, then 10 × 2,600
Spacing | 20 mm module gap · 800 mm aisle · ≥ 950 mm rail to wall

Architect's PV zone limit

LEGEND
isolator unit ■ DC SPD unit

INVERTER STATION (steel frame + canopy)
DCI-01/02 DC isolator units (8 × 2P 1200 V 32 A each)
DCS-01/02 DC SPD units (8 × Type 2, 1100 V each)
INV-01/02 Sigen PV 80M1 80 kW · ACCP 400 A

Existing ducts (approx., verify)

NOTES: 1. Dimensions in mm. 2. Roof outline traced from D18102-DD-A-104; verify
on site. 3. Foot block size and ballast weight per Enerack calculation; roof load to be
approved by the building structural engineer. 4. All tables lie within the architect's
solar zone. 5. Inverter station and duct positions indicative – confirm on site with the
hotel; C3 riser route and LV room location TBC.

C3 4C×240 mm² + E3 120 mm²
to MLVS via riser
(≈ 200 m, route TBC)

ROOFTOP SOLAR PV LAYOUT

Project | Marriott Hotel – Mezzanine Roof
Client | Kampala Marriott Hotel
Drawing No. | PV-LAY-D18102-002 Rev C
Date / Scale | 9 November 2026 · NTS (A3)

Tower / building face – cable riser to LV room (location TBC)
