mahilfernando/Tracker-Layout_Tororo-PV/solar-mezzanine-roof/annexes/1.Single_Line_Diagram.pdf

~

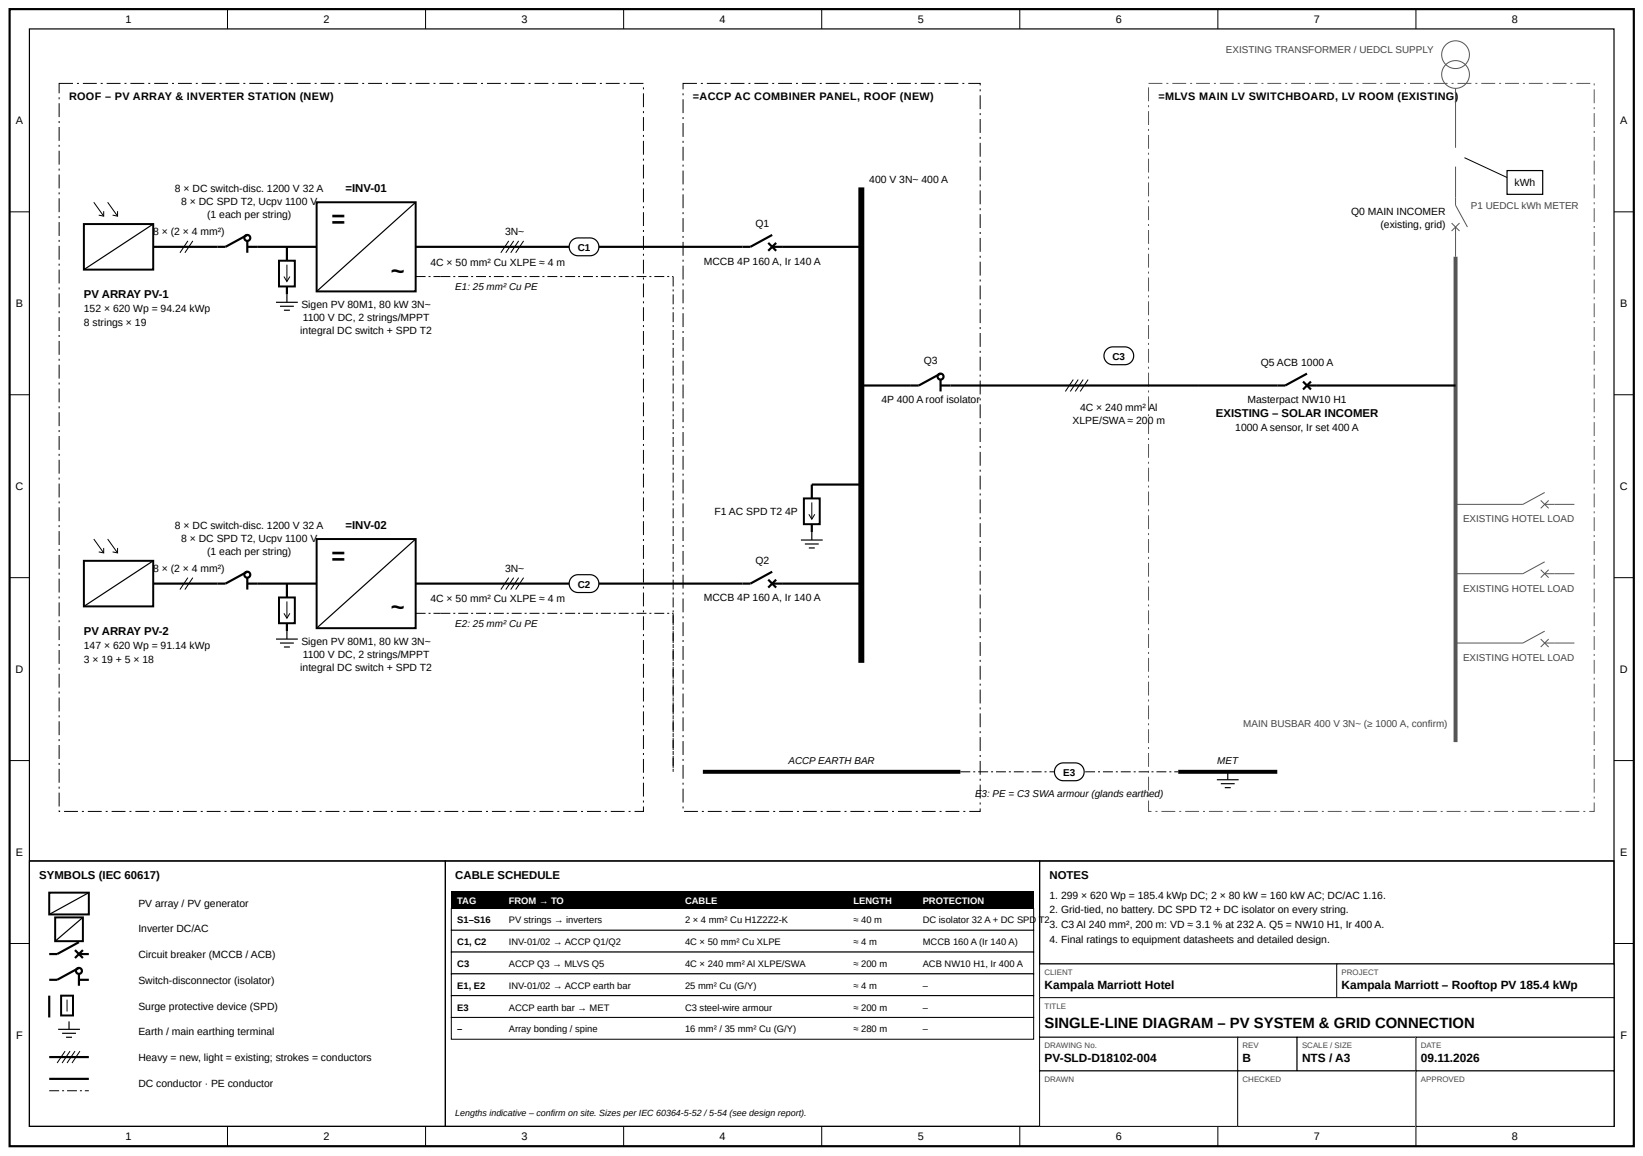
[picture p56: page 1]

EXISTING TRANSFORMER / UEDCL SUPPLY

P1 UEDCL kWh METER Q0 MAIN INCOMER
(existing, grid)

Sigen PV 80M1, 80 kW 3N~
1100 V DC, 2 strings/MPPT
integral DC switch + SPD T2

E3: PE = C3 SWA armour (glands earthed)

NOTES
1. 299 × 620 Wp = 185.4 kWp DC; 2 × 80 kW = 160 kW AC; DC/AC 1.16.
2. Grid-tied, no battery. DC SPD T2 + DC isolator on every string.
3. C3 Al 240 mm², 200 m: VD ≈ 3.1 % at 232 A. Q5 = NW10 H1, Ir 400 A.
4. Final ratings to equipment datasheets and detailed design.

PV array / PV generator

Circuit breaker (MCCB / ACB)

PROJECT
Kampala Marriott – Rooftop PV 185.4 kWp

Surge protective device (SPD)

TITLE
SINGLE-LINE DIAGRAM – PV SYSTEM & GRID CONNECTION

Earth / main earthing terminal

Heavy = new, light = existing; strokes = conductors

DC conductor · PE conductor

Lengths indicative – confirm on site. Sizes per IEC 60364-5-52 / 5-54 (see design report).
