mahilfernando/Tracker-Layout_Tororo-PV/solar-mezzanine-roof/sld/PV_SLD_Detailed.pdf

# SINGLE LINE DIAGRAM – 185.4 kWp GRID-TIED ROOFTOP SOLAR PV SYSTEM

DC

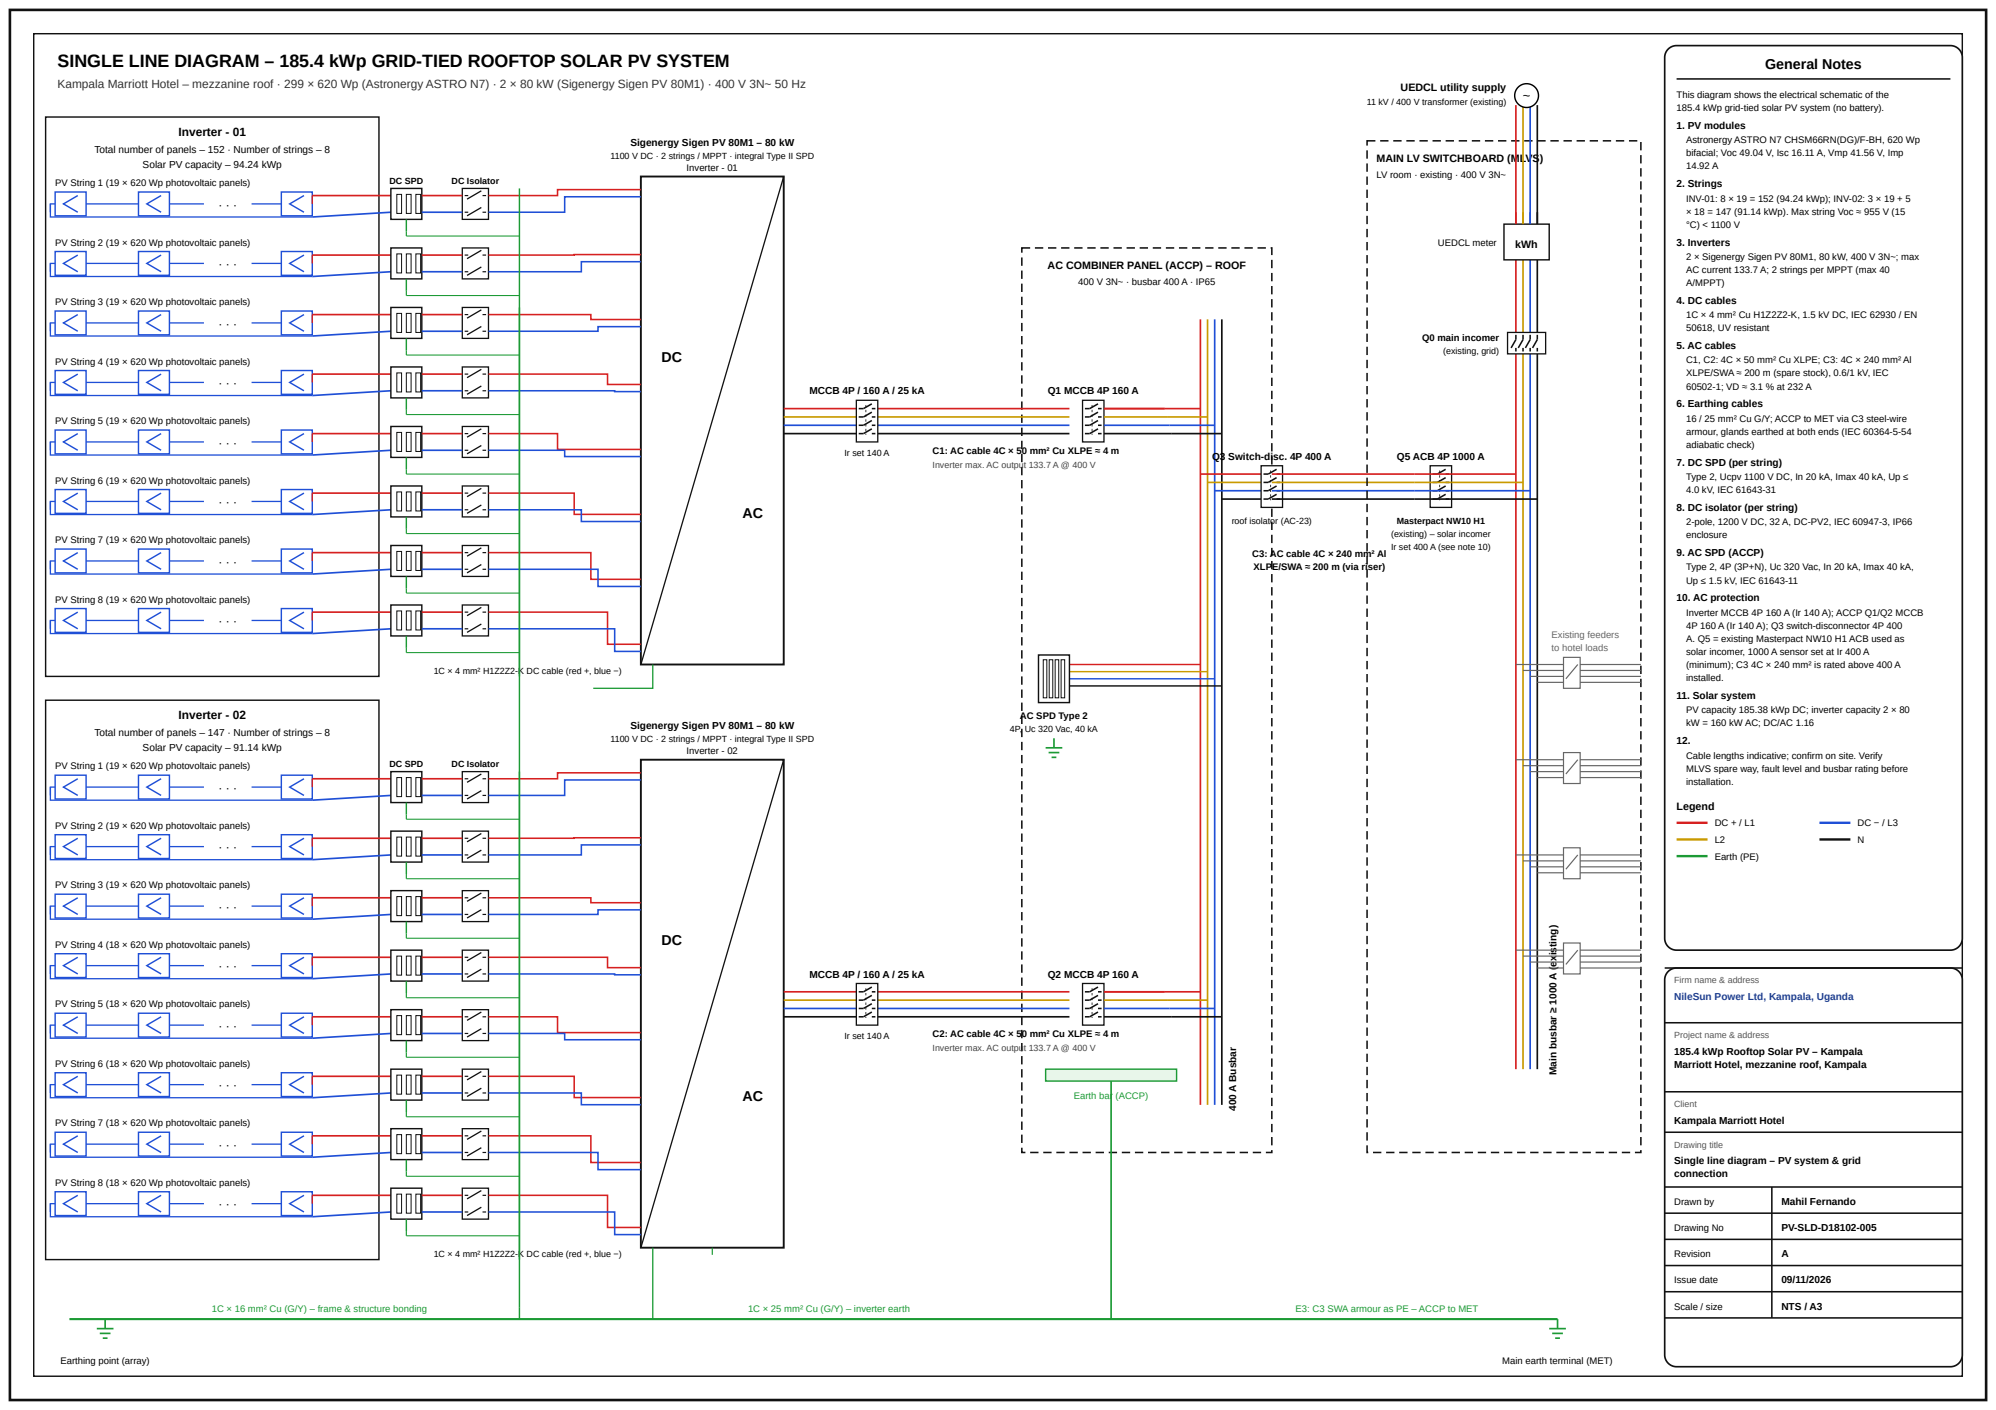
[picture p57: page 1]

Kampala Marriott Hotel – mezzanine roof · 299 × 620 Wp (Astronergy ASTRO N7) · 2 × 80 kW (Sigenergy Sigen PV 80M1) · 400 V 3N~ 50 Hz

This diagram shows the electrical schematic of the
185.4 kWp grid-tied solar PV system (no battery).
1. PV modules
Astronergy ASTRO N7 CHSM66RN(DG)/F-BH, 620 Wp
bifacial; Voc 49.04 V, Isc 16.11 A, Vmp 41.56 V, Imp
2. Strings
INV-01: 8 × 19 = 152 (94.24 kWp); INV-02: 3 × 19 + 5
× 18 = 147 (91.14 kWp). Max string Voc ≈ 955 V (15
3. Inverters
2 × Sigenergy Sigen PV 80M1, 80 kW, 400 V 3N~; max
AC current 133.7 A; 2 strings per MPPT (max 40
A/MPPT)
4. DC cables
1C × 4 mm² Cu H1Z2Z2-K, 1.5 kV DC, IEC 62930 / EN
50618, UV resistant
5. AC cables
C1, C2: 4C × 50 mm² Cu XLPE; C3: 4C × 240 mm² Al
XLPE/SWA ≈ 200 m (spare stock), 0.6/1 kV, IEC
6. Earthing cables
16 / 25 mm² Cu G/Y; ACCP to MET via C3 steel-wire
armour, glands earthed at both ends (IEC 60364-5-54
adiabatic check)
7. DC SPD (per string)
Type 2, Ucpv 1100 V DC, In 20 kA, Imax 40 kA, Up ≤
4.0 kV, IEC 61643-31
8. DC isolator (per string)

Sigenergy Sigen PV 80M1 – 80 kW
1100 V DC · 2 strings / MPPT · integral Type II SPD

Total number of panels – 152 · Number of strings – 8

Solar PV capacity – 94.24 kWp

MAIN LV SWITCHBOARD (MLVS)
LV room · existing · 400 V 3N~

PV String 1 (19 × 620 Wp photovoltaic panels)

PV String 2 (19 × 620 Wp photovoltaic panels)

AC COMBINER PANEL (ACCP) – ROOF
400 V 3N~ · busbar 400 A · IP65

PV String 3 (19 × 620 Wp photovoltaic panels)

PV String 4 (19 × 620 Wp photovoltaic panels)

PV String 5 (19 × 620 Wp photovoltaic panels)

Inverter max. AC output 133.7 A @ 400 V

PV String 6 (19 × 620 Wp photovoltaic panels)

Masterpact NW10 H1
(existing) – solar incomer
Ir set 400 A (see note 10)

2-pole, 1200 V DC, 32 A, DC-PV2, IEC 60947-3, IP66
enclosure
9. AC SPD (ACCP)
Type 2, 4P (3P+N), Uc 320 Vac, In 20 kA, Imax 40 kA,
Up ≤ 1.5 kV, IEC 61643-11
10. AC protection
Inverter MCCB 4P 160 A (Ir 140 A); ACCP Q1/Q2 MCCB
4P 160 A (Ir 140 A); Q3 switch-disconnector 4P 400
A. Q5 = existing Masterpact NW10 H1 ACB used as
solar incomer, 1000 A sensor set at Ir 400 A
(minimum); C3 4C × 240 mm² is rated above 400 A
installed.
11. Solar system
PV capacity 185.38 kWp DC; inverter capacity 2 × 80
Cable lengths indicative; confirm on site. Verify
MLVS spare way, fault level and busbar rating before
installation.

PV String 7 (19 × 620 Wp photovoltaic panels)

C3: AC cable 4C × 240 mm² Al
XLPE/SWA ≈ 200 m (via riser)

PV String 8 (19 × 620 Wp photovoltaic panels)

1C × 4 mm² H1Z2Z2-K DC cable (red +, blue −)

Total number of panels – 147 · Number of strings – 8

Solar PV capacity – 91.14 kWp

PV String 4 (18 × 620 Wp photovoltaic panels)

Firm name & address
NileSun Power Ltd, Kampala, Uganda

PV String 5 (18 × 620 Wp photovoltaic panels)

Project name & address
185.4 kWp Rooftop Solar PV – Kampala
Marriott Hotel, mezzanine roof, Kampala

PV String 6 (18 × 620 Wp photovoltaic panels)

PV String 7 (18 × 620 Wp photovoltaic panels)

Drawing title
Single line diagram – PV system & grid
connection

PV String 8 (18 × 620 Wp photovoltaic panels)
