mahilfernando/Tracker-Layout_Tororo-PV/solar-mezzanine-roof/sld/PV_Block_Diagram.pdf

# Rooftop Solar PV System – Kampala Marriott Hotel

## Solar Panels

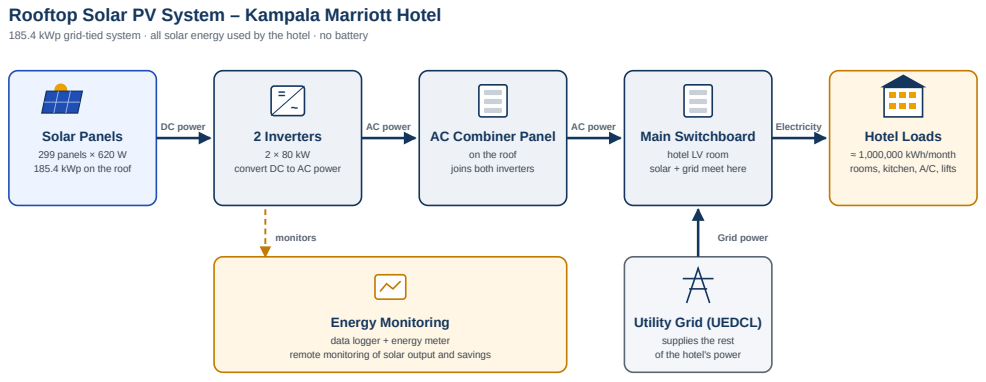
[picture p58: page 1]
2 Inverters; 2 × 80 kW convert DC to AC power; DC power; AC power; Electricity; Grid power; monitors

185.4 kWp grid-tied system · all solar energy used by the hotel · no battery

AC Combiner Panel

Main Switchboard
hotel LV room
solar + grid meet here

Hotel Loads
≈ 1,000,000 kWh/month
rooms, kitchen, A/C, lifts

299 panels × 620 W
185.4 kWp on the roof

on the roof
joins both inverters

Energy Monitoring
data logger + energy meter

Utility Grid (UEDCL)
supplies the rest
of the hotel's power

remote monitoring of solar output and savings
