mahilfernando/Tracker-Layout_Tororo-PV/solar-mezzanine-roof/annexes/5.PV_Stuctrural_Drawing.pdf

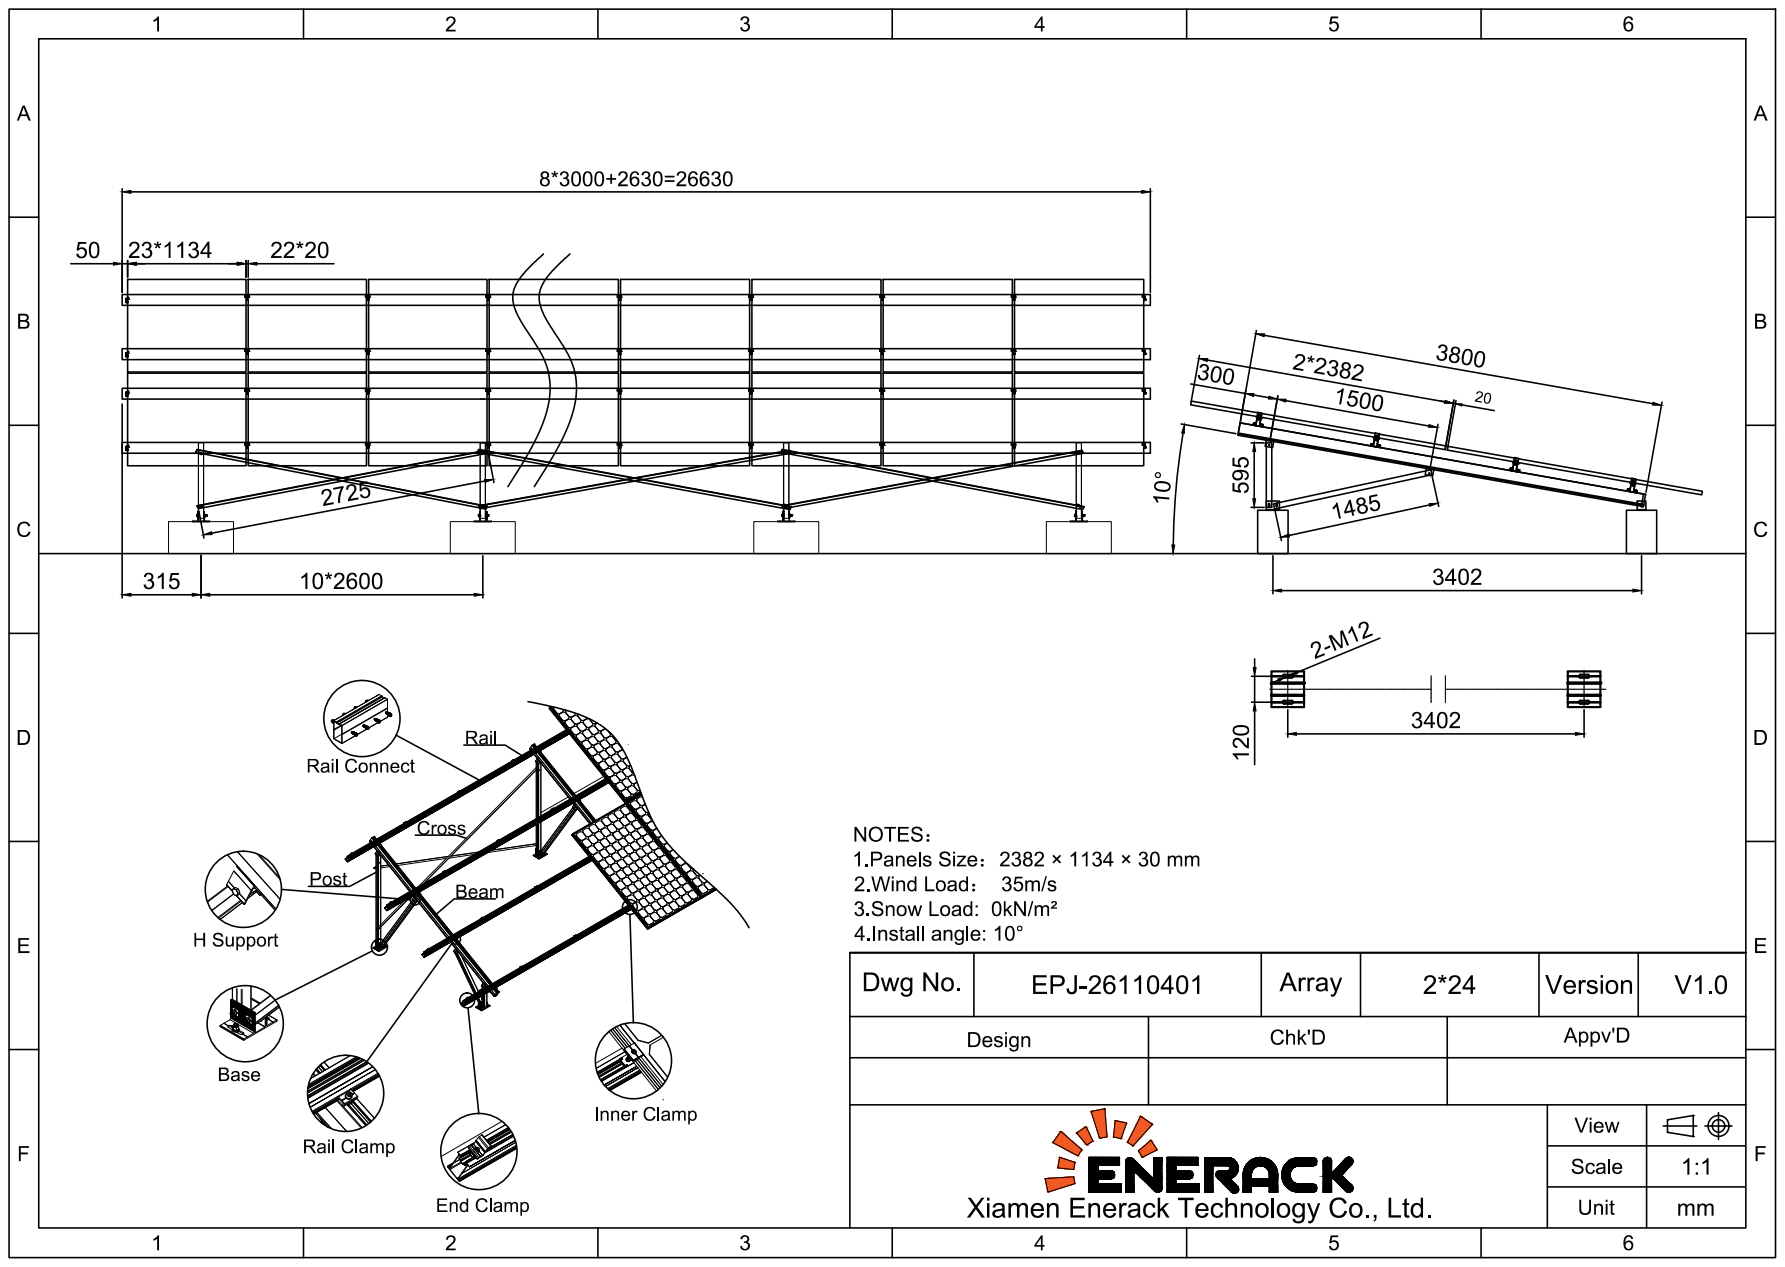
[picture p59: page 1]

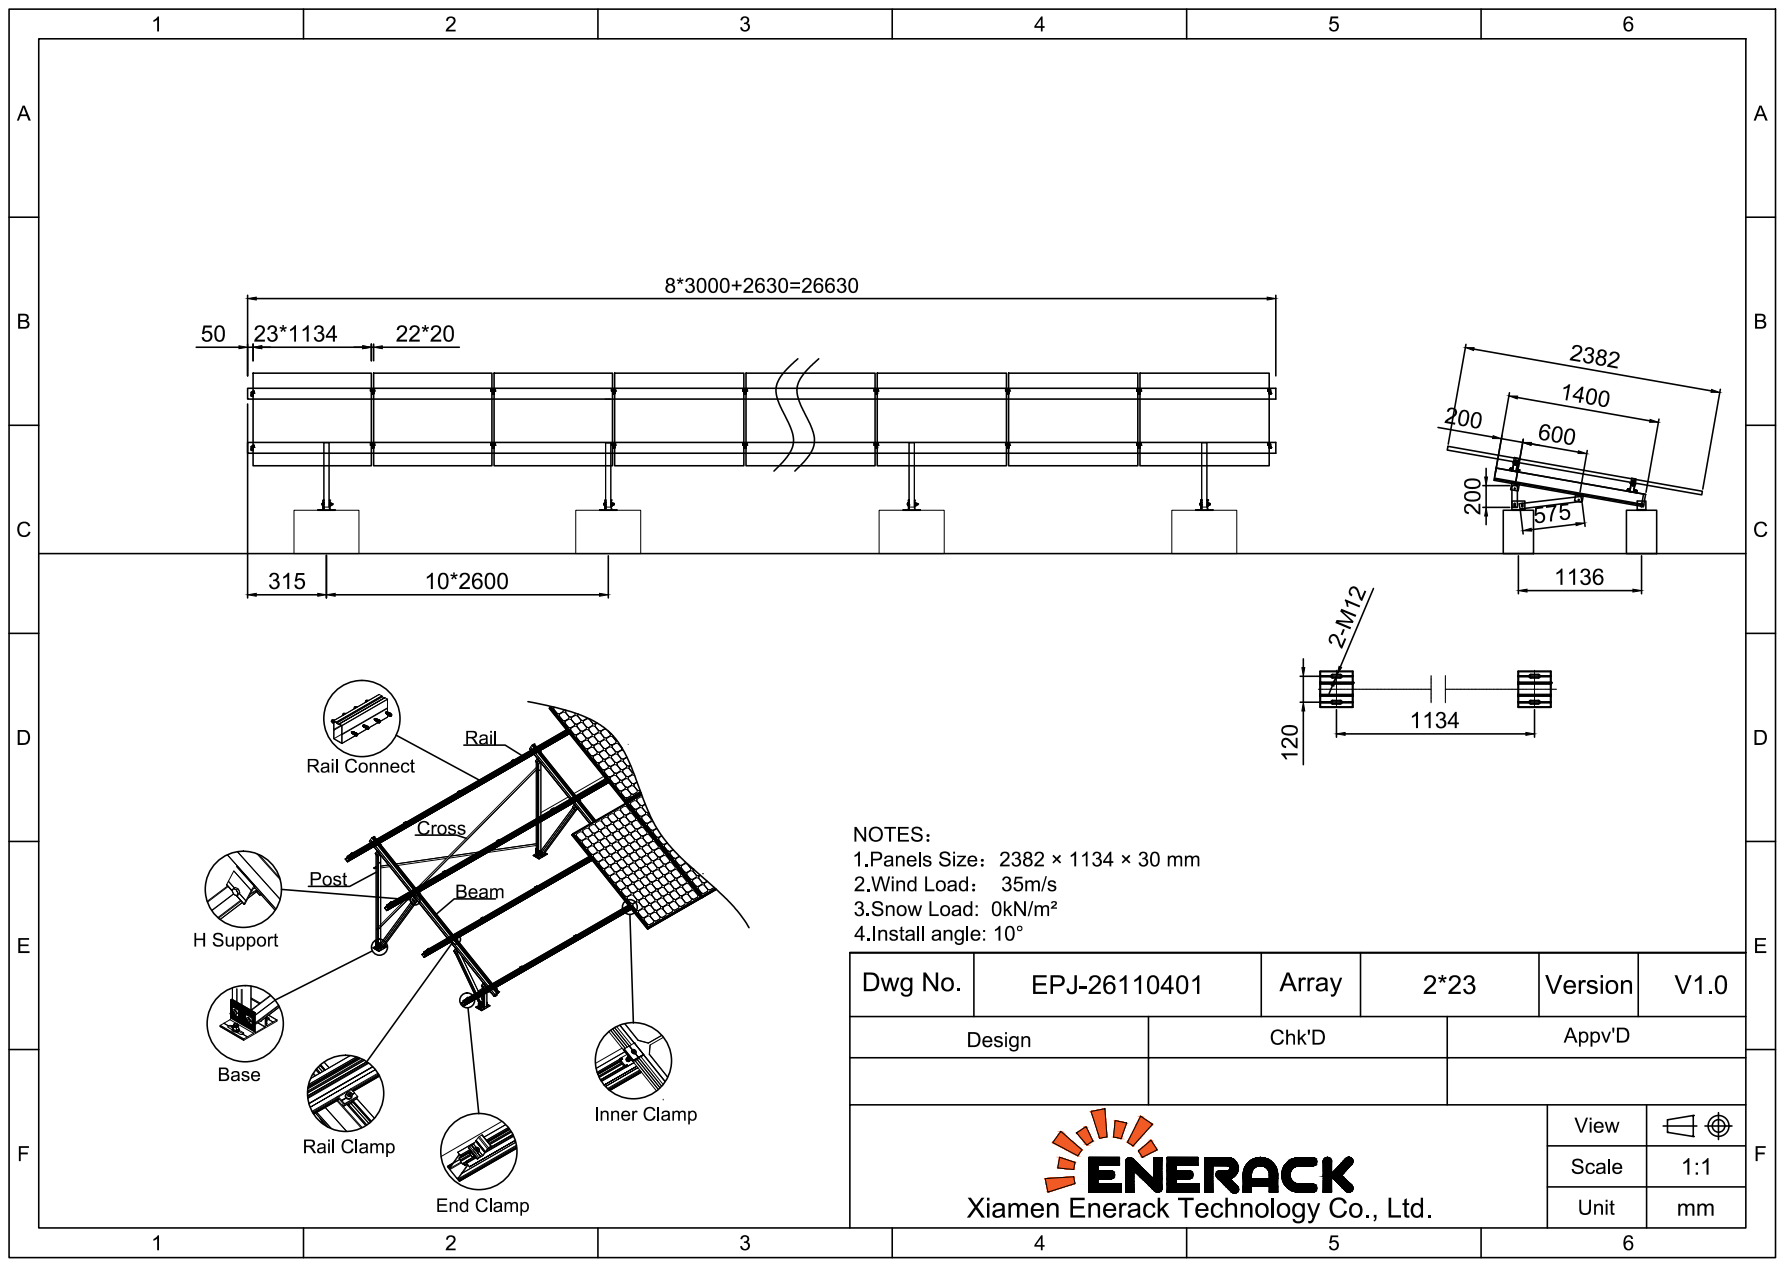
[picture p60: page 2]
