mahilfernando/Tracker-Layout_Tororo-PV/(commit log)

2026-10-04 Add Modbus TCP to SQLite to web dashboard app
    poller.py reads the register map in config.py from a Modbus TCP device
    every 5 s and stores readings in a local SQLite file; app.py (FastAPI)
    serves latest values and history as JSON plus a dashboard page.
    Includes read_test.py for first contact and a dependency-free device
    simulator for testing without hardware.
    Claude-Session: https://claude.ai/code/session_01XdjsMt9KRaA8dqG7C4ZYC6
2026-10-04 Map the app to the PVH DeepTrack TBox Modbus memory map
    Replace the 4-register example with the TBox map from manual
    PVH-RD-DC-MAN-0020-01_A10: ID 255 plant status, and per power block
    (ID 1-254) Meteo 0 plus every DBox (16-register slots from 40050).
    Reads use function 03 in 80-register requests; nothing is written.
    The poller keeps the latest state per tracker, saves history every
    HISTORY_MINUTES and logs mode, alarm and position-code changes as
    events. The dashboard shows plant status, a block overview, a
    filterable tracker table, per-tracker history and the event log.
    The simulator now emulates a TBox with the configured blocks.
    C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
    [app.py, config.py, modbus_io.py, poller.py, read_test.py, simulator.py, tbox_map.py]
2026-10-04 Add raw register test mode
    raw_poller.py reads any block of holding or input registers from any
    Modbus TCP device (accepts 45000 / 405000 / 35000 / plain offsets),
    prints them, and stores them for a new raw.html page that shows
    uint16, int16, hex and scaled values with a per-register chart.
    raw.bat runs it with the settings at the top of the file.
    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
2026-10-04 Add find_tbox.py network scan to locate the TBox
    Scans a /24 for open Modbus ports 502/503 and reads ID 255 @40000; a
    TBox answers with its UTC date and time there. Also shows ID 1 at
    40000 and 45000 for other devices.
    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
2026-10-04 raw_poller: add --one-based addressing to match Modbus Poll
    Most Modbus tools treat 45000 as wire address 4999 (40001 = register 0);
    the PVH manual treats 40000 as register 0. Add --one-based and use it in
    raw.bat so the raw page shows the same registers as the user's tool.
    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
2026-11-03 Add PV mounting structure RFQ and structural design brief (PDF)
    Claude-Session: https://claude.ai/code/session_01CjcS6nCSy7EK3TmDpBqLou
2026-11-03 Structure RFQ: drop roof/fixing section and code/material rows
    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
2026-11-04 Redraw PV layout with Enerack ballast structure (EPJ-26110401)
    DXF + A3 sheet with rails (26,630 mm), 11 frames per table at 2,600 mm,
    foot positions, 2P/1P sections and table schedule. Base 299 modules
    (185.4 kWp); optional T8-T9 (+69 modules) on a separate layer.
    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
2026-11-04 Add Word version of the PV report; switch inverters to 2 x 80 kW
    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
2026-11-04 Add full calculation workbook for the Kampala Marriott rooftop PV
    Summary, Inputs, Layout (incl. row-shading check), Electrical (strings,
    currents, protection, voltage drop), Structure (Enerack quantities),
    Generation, TOU Impact, BOQ, Financial and Sensitivity - all formulas,
    results match the report.
    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
2026-11-05 Workings: add bottom-up DC System and AC System breakdowns
    Quantities derived from strings, tables and cable runs; editable unit rates;
    comparison with the BOQ allowance and an Inputs switch to use the detailed
    totals in the BOQ (default off, so report figures are unchanged).
    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
2026-11-05 SLD: tag AC cables C1-C3, draw earth conductors E1-E3 and add cable schedule
    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
2026-11-05 Layout: show inverter station (INV-01, INV-02, ACCP), cable routes and inverter zones
    Modules shaded by inverter (INV-01 152, INV-02 147), inverter station with
    canopy and service clearance in the equipment strip, DC tray along the east
    corridor, C3/E3 route to the riser, existing ducts, Detail A. Rev B.
    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
2026-11-05 DXF: add cable layers (DC strings, home runs, tray, C1-C3, earths, comms, tags)
    Strings follow a snake module order so rows join at the same end; each
    string drawn module-to-module with + and - home runs via the east tray to
    its inverter. AC cables C1/C2/C3, earth conductors (array bonding, spine,
    E1-E3) and RS485 comms on their own layers with cable tags.
    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
2026-11-05 Add PDF plot of the CAD layout with cable layers
    plot_dxf_pdf.py renders PV_Layout_Enerack_10deg.dxf to an A3 PDF: page 1
    all layers, page 2 cable layers highlighted (structure greyed) with a layer
    legend.
    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
2026-11-05 Add engineering-standard SLD (IEC 60617 symbols, A3 frame, title block)
    PV-SLD-D18102-004 Rev A as SVG, PNG (5040 px), A3 PDF and a Word file;
    symbol legend, cable schedule, notes, new vs existing line weights.
    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
2026-11-05 Colour SLD: fix XML escape in cable schedule; add standalone SVG and hi-res PNG
    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
2026-11-05 Add technical & commercial proposal; quotation reduced to scope, price and terms
    Proposal (Word + PDF, 10 pages): executive summary, site, solution, generation,
    financial analysis (cash flow, sensitivity), scope/schedule, warranties,
    one-page commercial offer, next steps. Financials from the client's workings
    (USD 121,115; payback 6.1 yrs; IRR 16.6 %; NPV USD 71,221).
    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
2026-11-05 Proposal and quotation: supplier is Nile Sun Power Limited
    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
2026-11-05 Add Nile Sun Power logo to proposal (cover + headers) and quotation
    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
2026-11-05 Proposal: attach annexes 1-6, remove signature blocks, name inverter and module models
    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
2026-11-09 SLD: existing Masterpact NW10 H1 as solar incomer (Q5), Q3 switch-disconnector
    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
2026-11-09 Add DC cable tray explainer illustration
    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
2026-11-09 Add lightning air-termination rod explainer illustration
    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
2026-11-10 Workings: generation switched to PVsyst P50 as simulated (291,051 kWh)
    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
2026-11-12 Final workings: capex USD 139,881 (contingency 7 %, priced Al C3 cable); regenerate quotation, proposal and feasibility report
    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
